RobotGrrl/KitePropulsion/Simulation/CO2JetAnimation/atmosphinder_sprite.png

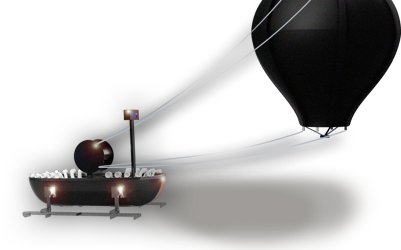
Simulation/CO2JetAnimation/atmosphinder_sprite.png
