RobotGrrl/KitePropulsion/Simulation/CO2JetAnimation/anim_bg.png

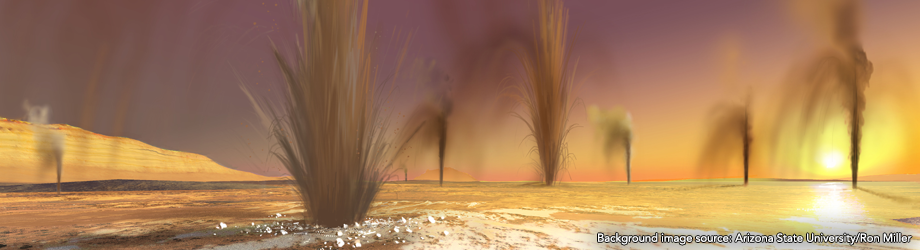
Simulation/CO2JetAnimation/anim_bg.png
