RobotGrrl/KitePropulsion/Electronics/efficiencies.md

| Power and Thermal Efficiencies | | | | | | | | |
| --- | --- | --- | --- | --- | --- | --- | --- | --- |
| | | | | | | | | |
| Ambient temperature | deg C | 25 | | | | | | |
| V\_bat | V | 16.8 | | | | | | (13.6, 14.8, 16.8) |
| | | | | | | | | |
| Parameter | Unit | 01 Input | 03 Motor | 04 Controller (5V) | 04 Controller (3.3V) | 05 Servo Out | 06 SBC  | Notes |
| V\_in | V | 16.8 | 16.8 | 16.8 | 16.8 | 16.8 | 16.8 | |
| V\_drop | V | 0.7 | 0.7 | 0.7 | 0.7 | 0.7 | 0.7 | Diode and other components |
| Load current | A | 1 | 1 | 1 | 1 | 1 | 2.2 | |
| | | | | | | | | |
| Switching name | \- | XL4005 | XL4016 | XL4005 | XL4005 | XL4005 | XL4005  | |
| Switching V\_in | V | 16.1 | 16.1 | 16.1 | 16.1 | 16.1 | 16.1 | |
| Switching I\_in | A | 0.50 | 0.56 | 0.46 | 0.46 | 0.48 | 1.03 | Determined by the efficiency |
| Switching P\_in | W | 8.0 | 9.1 | 7.4 | 7.4 | 7.7 | 16.5 | |
| Switching V\_out | V | 7.2 | 7.72 | 6.7 | 6.7 | 6.9 | 6.76 | |
| Switching I\_out | A | 1 | 1 | 1 | 1 | 1 | 2.2 | |
| Switching P\_out | W | 7.2 | 7.72 | 6.7 | 6.7 | 6.9 | 14.872  | |
| | | | | | | | | |
| Switching Effeciency | % | 90% | 85% | 90% | 90% | 90% | 90% | Given by the webpage... |
| Switching P\_dissipated | W | 0.8 | 1.4 | 0.7 | 0.7 | 0.8 | 1.7 | |
| | | | | | | | | |
| Linear name | \- | 7805 | AZ1084 | AZ1084 | AZ1117 | AZ1084 | AZ1084  | |
| Linear V\_drop | V | 2 | 1.5 | 1.5 | 1.4 | 1.5 | 1.5 | |
| Linear V\_in | V | 7.2 | 7.72 | 6.7 | 6.7 | 6.9 | 6.76 | Add +0.2V to be safe |
| Linear I\_in | A | 1 | 1 | 1 | 1 | 1 | 2.2 | |
| Linear P\_in | W | 7.2 | 7.72 | 6.7 | 6.7 | 6.9 | 14.872  | |
| Linear V\_out | V | 5 | 6.02 | 5 | 3.3 | 5.2 | 5.06 | |
| Linear I\_out | A | 1 | 1 | 1 | 1 | 1 | 2.2 | I\_out = I\_in for linear regulators |
| Linear P\_out | W | 5 | 6.02 | 5 | 3.3 | 5.2 | 11.132  | |
| | | | | | | | | |
| Linear Efficiency | % | 69% | 78% | 75% | 49% | 75% | 75% | |
| Linear P\_dissipated | W | 2.2 | 1.7 | 1.7 | 3.4 | 1.7 | 3.74 | |
| | | | | | | | | |
| Overall Efficiency | % | 63% | 66% | 67% | 44% | 68% | 67% | |
| | | | | | | | | |
| θ\_JC | deg C / W | 5 | 7.36 | 7.36 | 10 | 7.36 | 7.36 | Thermal resistance, junction-to-case, found as R\_thetaJC in the datasheet |
| θ\_CS | deg C / W | 0 | 0 | 0 | 0 | 0 | 0 | Thermal resistance case to surface |
| θ\_SA | deg C / W | 28 | 10 | 10 | 10 | 10 | 10 | Given in heatsink's datasheet, or 1000 deg C / W per 1 cm^2 (via TI app note). Thermal resistance from surface to air. |
| Thermal resistance | deg C / W | 33 | 17.36 | 17.36 | 20 | 17.36 | 17.36 | Total thermal resistance from junction to air |
| | | | | | | | | |
| Temperature rise above ambient | deg C | 72.6 | 29.512 | 29.512 | 68 | 29.512 | 64.9264 | Above ambient temperature |
| Temperature rise incl. ambient | deg C | 97.6 | 54.512 | 54.512 | 93 | 54.512 | 89.9264 | Including ambient |
| Operating junction temperature | deg C | 150 | 125 | 125 | 125 | 125 | 125 | The maximum temperature limit of the regulator, found as T\_j in the datasheet |
| Junction temperature remainder | deg C | 52.4 | 70.488 | 70.488 | 32 | 70.488 | 35.0736 | This many degrees to go until it is exceeded. The maximum internal die temperature (aka maximum operating junction temperature) cannot be exceeded |
