RobotGrrl/KitePropulsion/Data/generator_05-01-22/MokuOscilloscopeData_20220501_024608_Screenshot.png

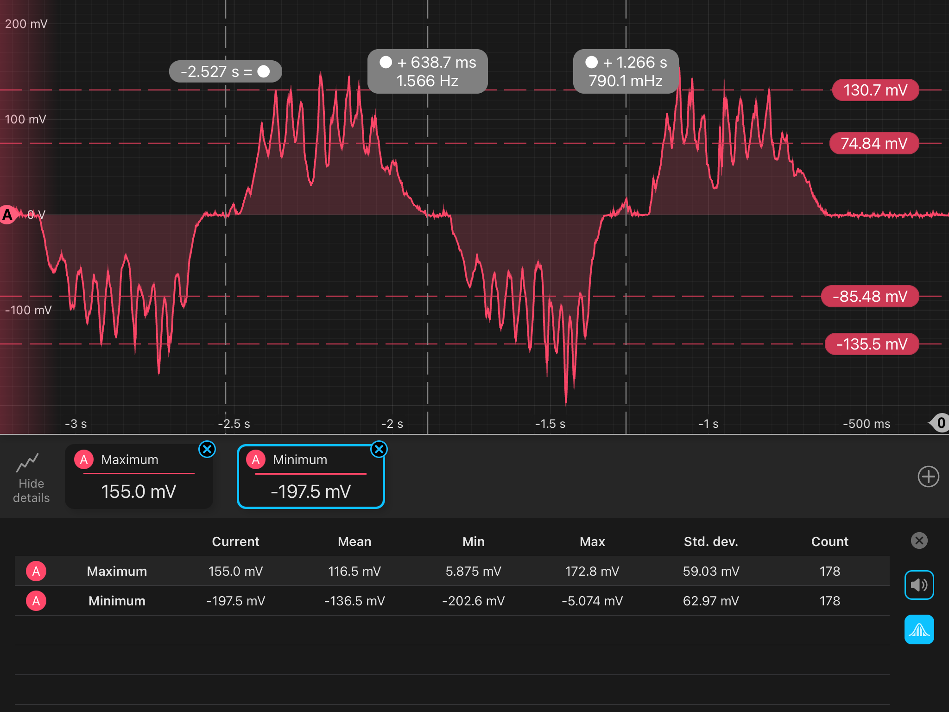
Data/generator_05-01-22/MokuOscilloscopeData_20220501_024608_Screenshot.png
