RobotGrrl/KitePropulsion/Diagrams/Kite Propulsion Block Diagram.png

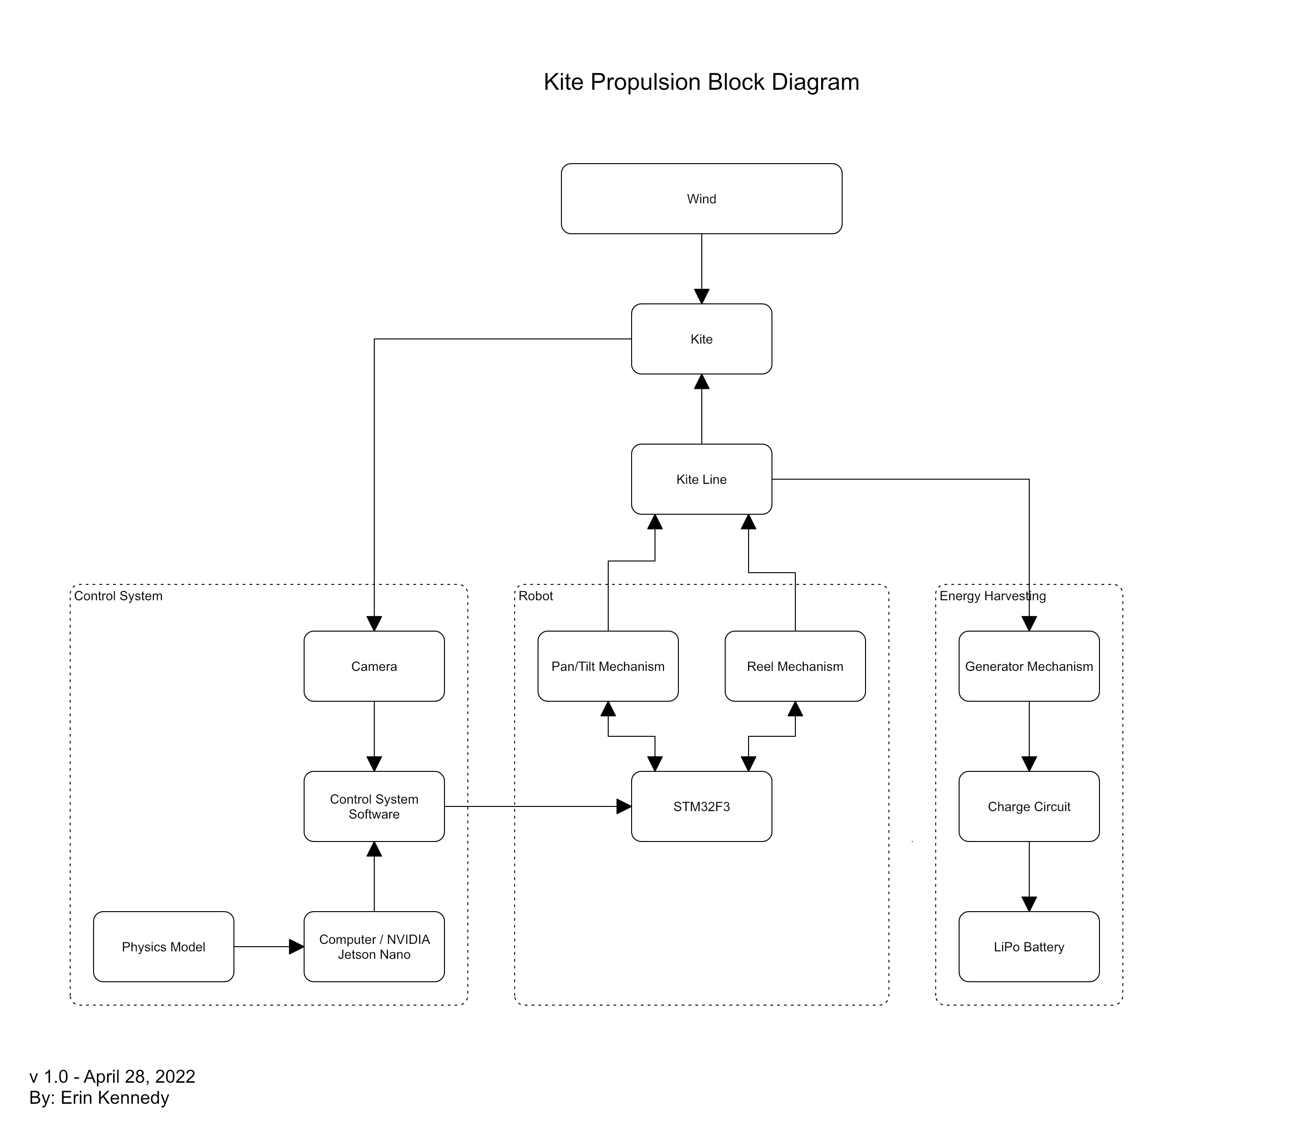
Diagrams/Kite Propulsion Block Diagram.png
