RobotGrrl/KitePropulsion/Electronics/00_CoverStage_v1/00_CoverStage_v1_art.png

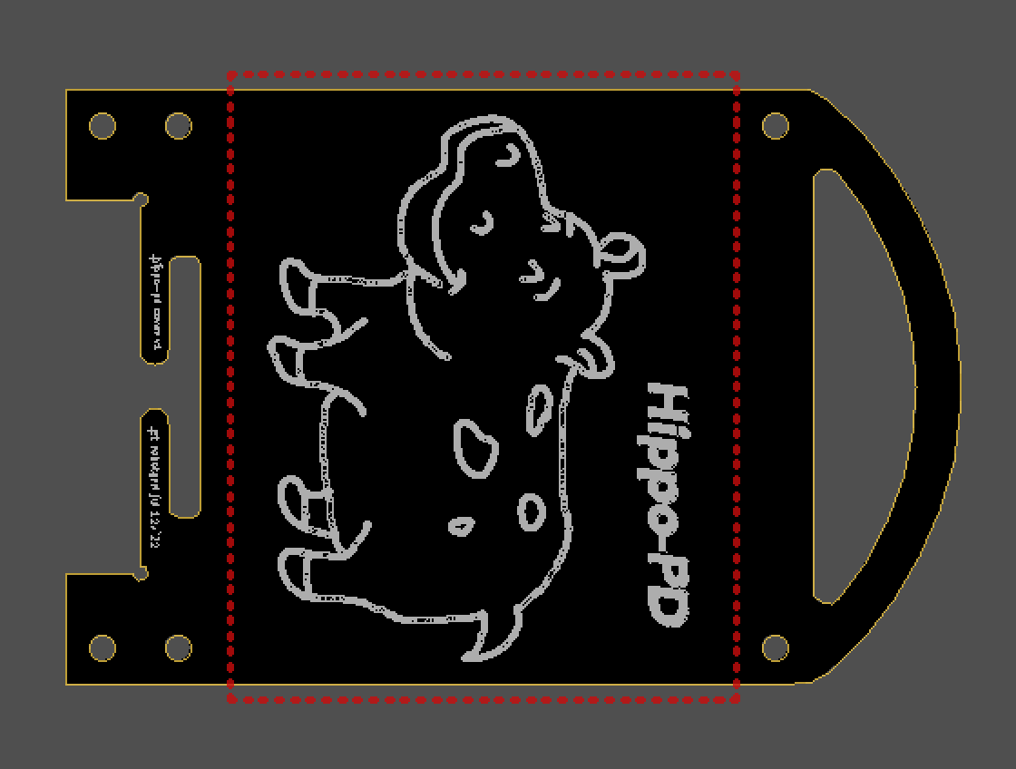
Electronics/00_CoverStage_v1/00_CoverStage_v1_art.png
