RobotGrrl/KitePropulsion/Electronics/00_CoverStage_v1/00_CoverStage_v1_top.png

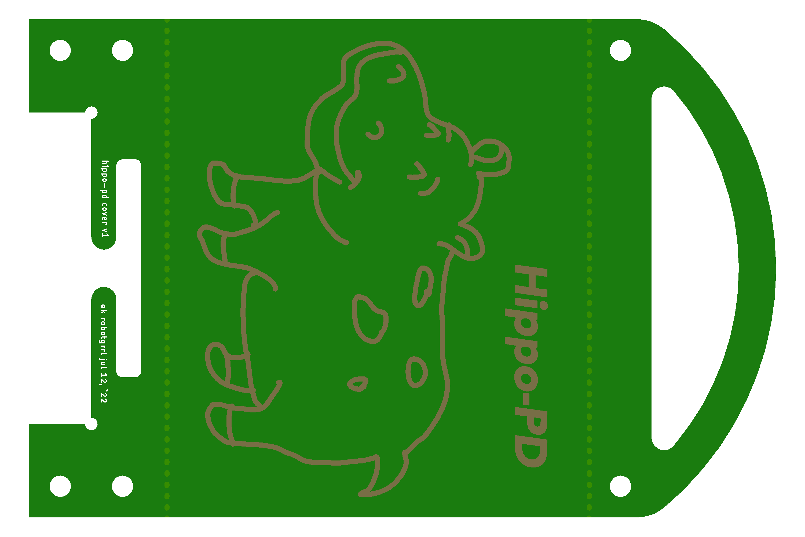
Electronics/00_CoverStage_v1/00_CoverStage_v1_top.png
