RobotGrrl/KitePropulsion/Electronics/01_InputStage_v1/01_InputStage_v1_bottom.png

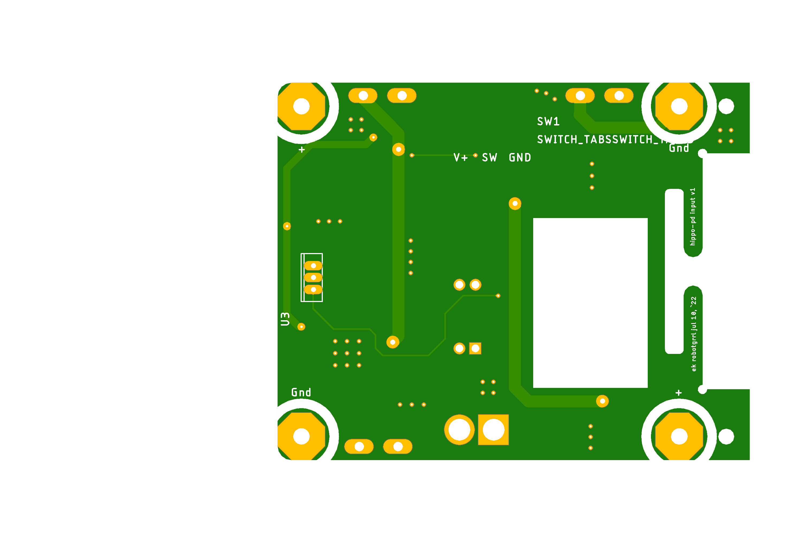
Electronics/01_InputStage_v1/01_InputStage_v1_bottom.png
