RobotGrrl/KitePropulsion/Electronics/02_MonitorStage_v1/02_MonitorStage_v1_art.png

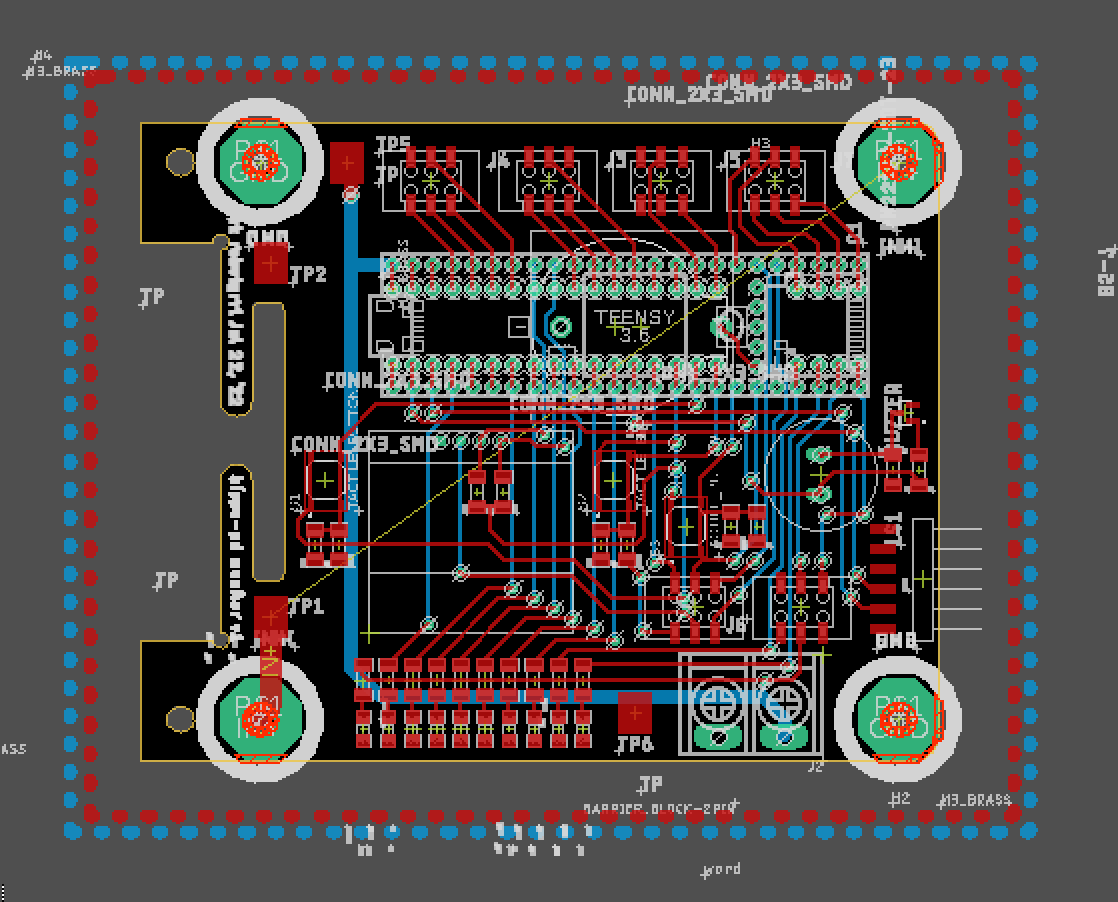
Electronics/02_MonitorStage_v1/02_MonitorStage_v1_art.png
