RobotGrrl/KitePropulsion/Electronics/02_MonitorStage_v1/02_MonitorStage_v1_bottom.png

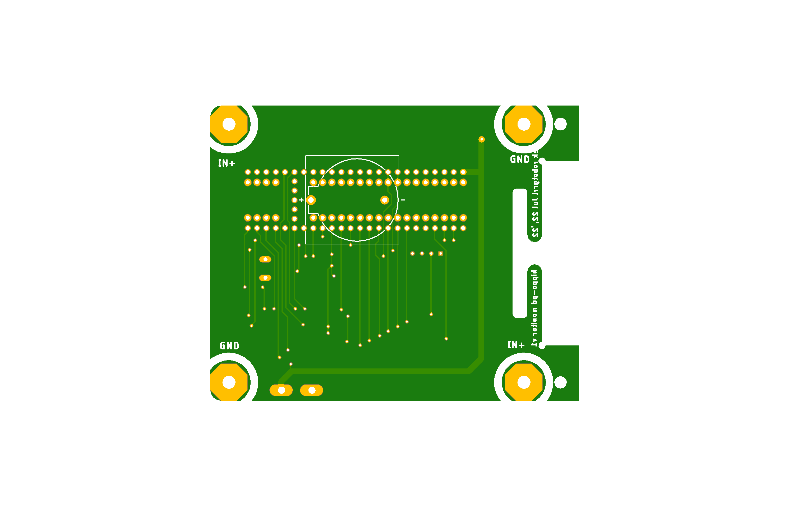
Electronics/02_MonitorStage_v1/02_MonitorStage_v1_bottom.png
