RobotGrrl/KitePropulsion/Electronics/03_MotorStage_v1/03_MotorStage_v1_art2.png

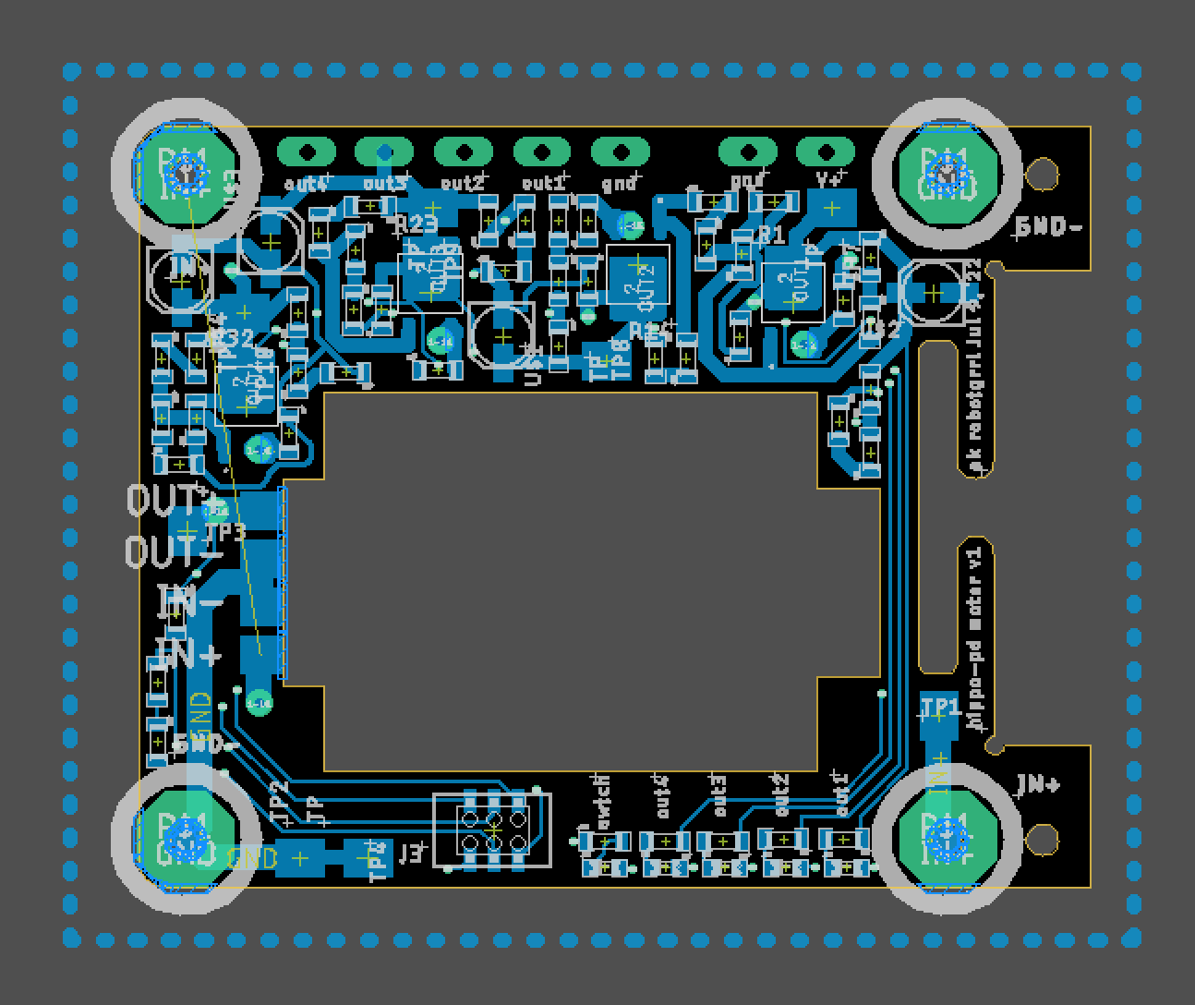
Electronics/03_MotorStage_v1/03_MotorStage_v1_art2.png
