RobotGrrl/KitePropulsion/Electronics/03_MotorStage_v1/03_MotorStage_v1_top.png

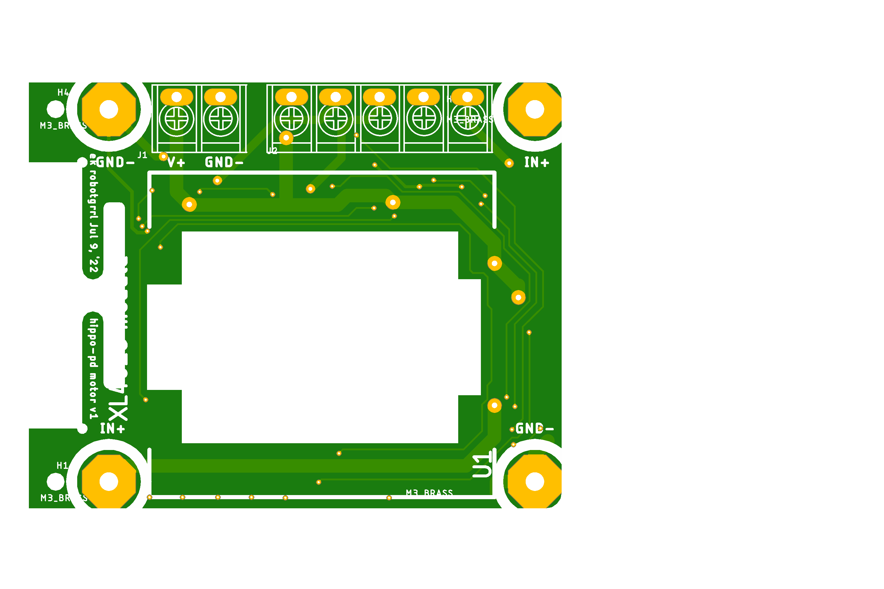
Electronics/03_MotorStage_v1/03_MotorStage_v1_top.png
