RobotGrrl/KitePropulsion/Electronics/04_ControllerStage_v1/04_ControllerStage_v1_bottom.png

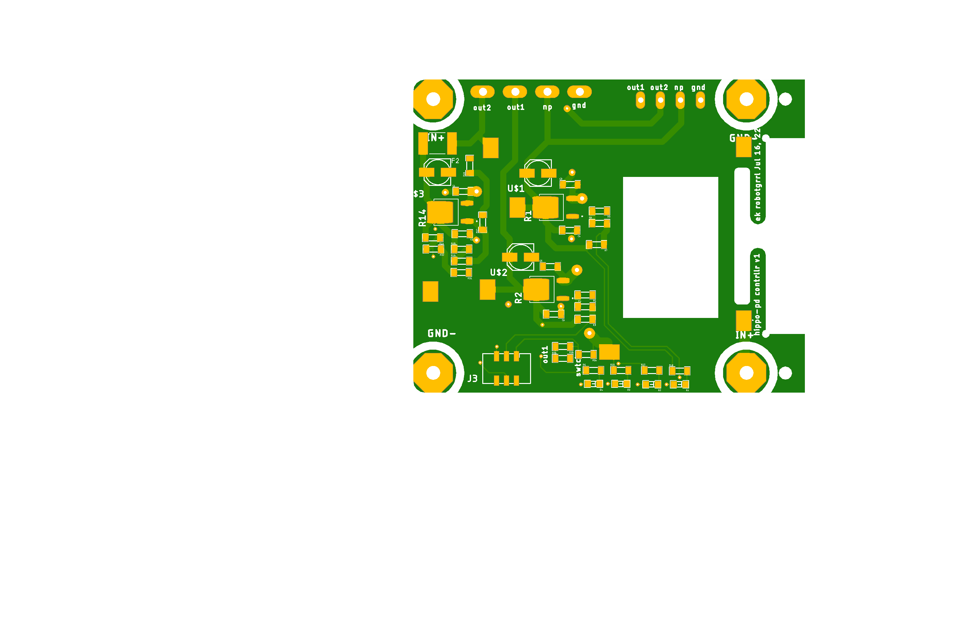
Electronics/04_ControllerStage_v1/04_ControllerStage_v1_bottom.png
