RobotGrrl/KitePropulsion/Electronics/04_ControllerStage_v1/04_ControllerStage_v1_top.png

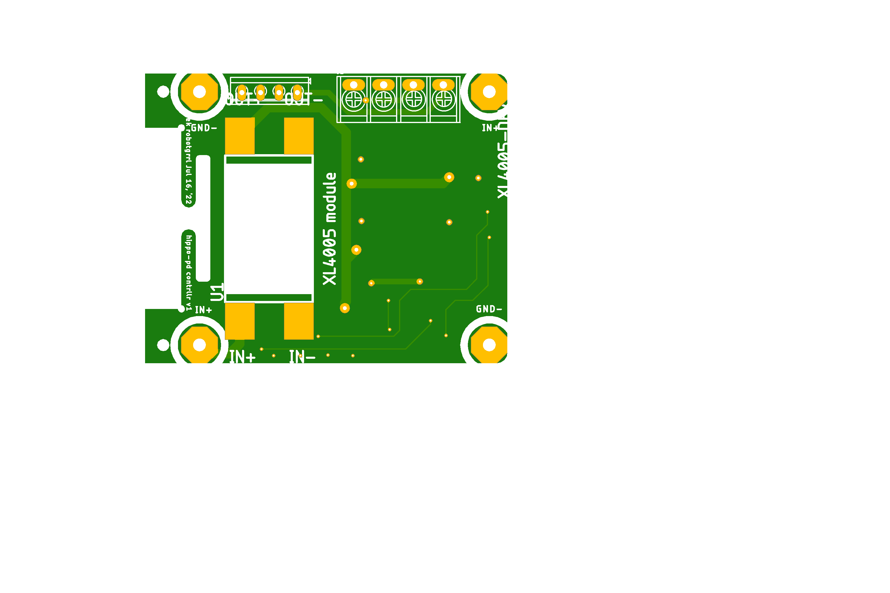
Electronics/04_ControllerStage_v1/04_ControllerStage_v1_top.png
