RobotGrrl/KitePropulsion/Electronics/05_ServoStage_v1/05_ServoStage_v1_art.png

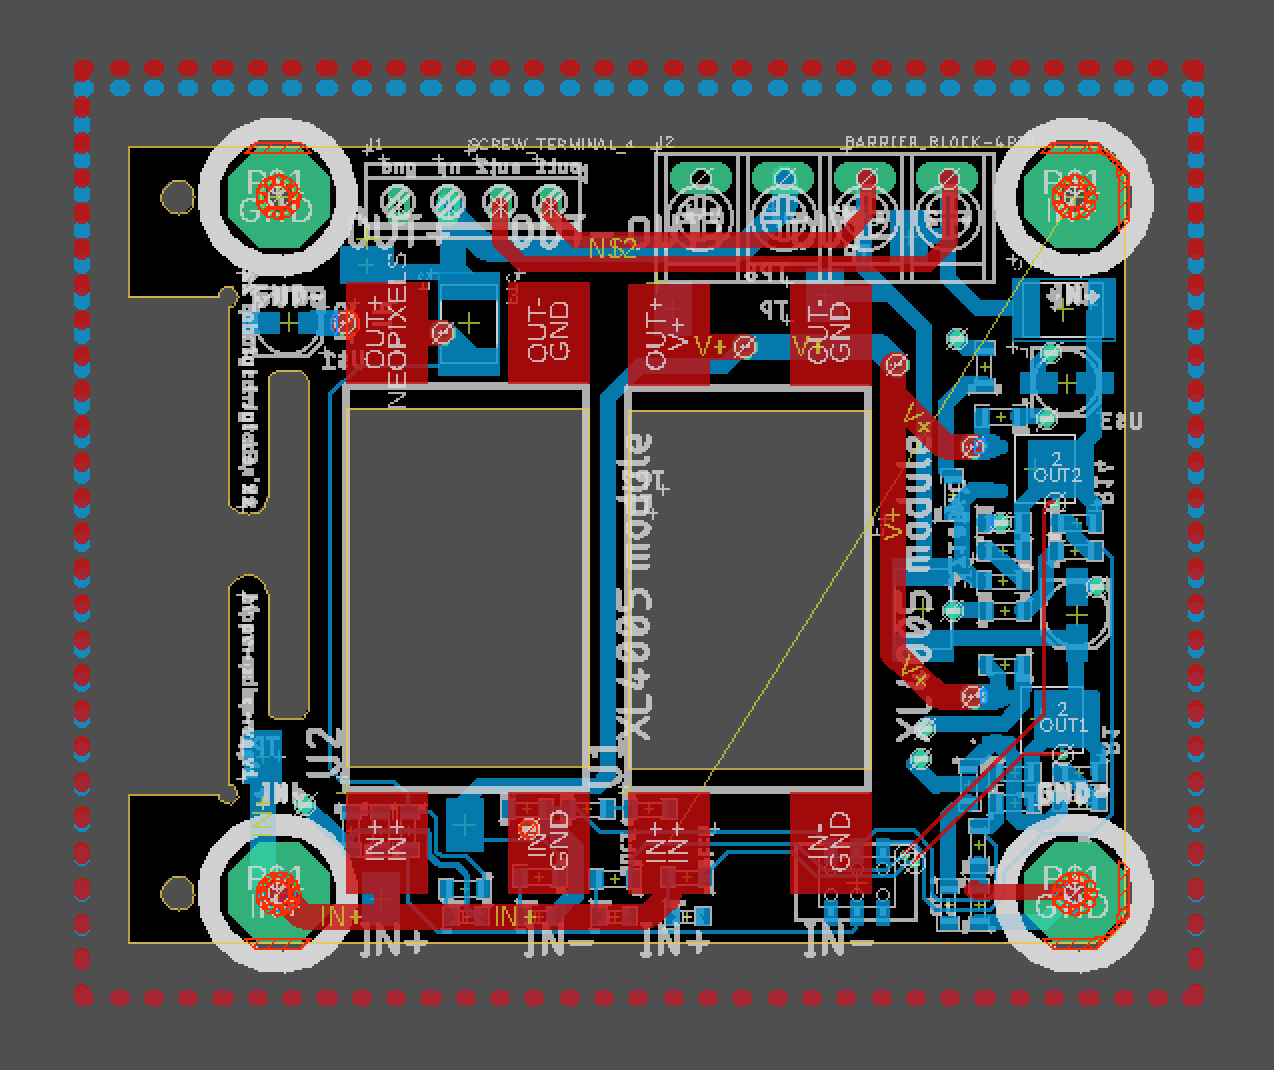
Electronics/05_ServoStage_v1/05_ServoStage_v1_art.png
