RobotGrrl/KitePropulsion/Electronics/06_SBCStage_v1/06_SBCStage_v1_art.png

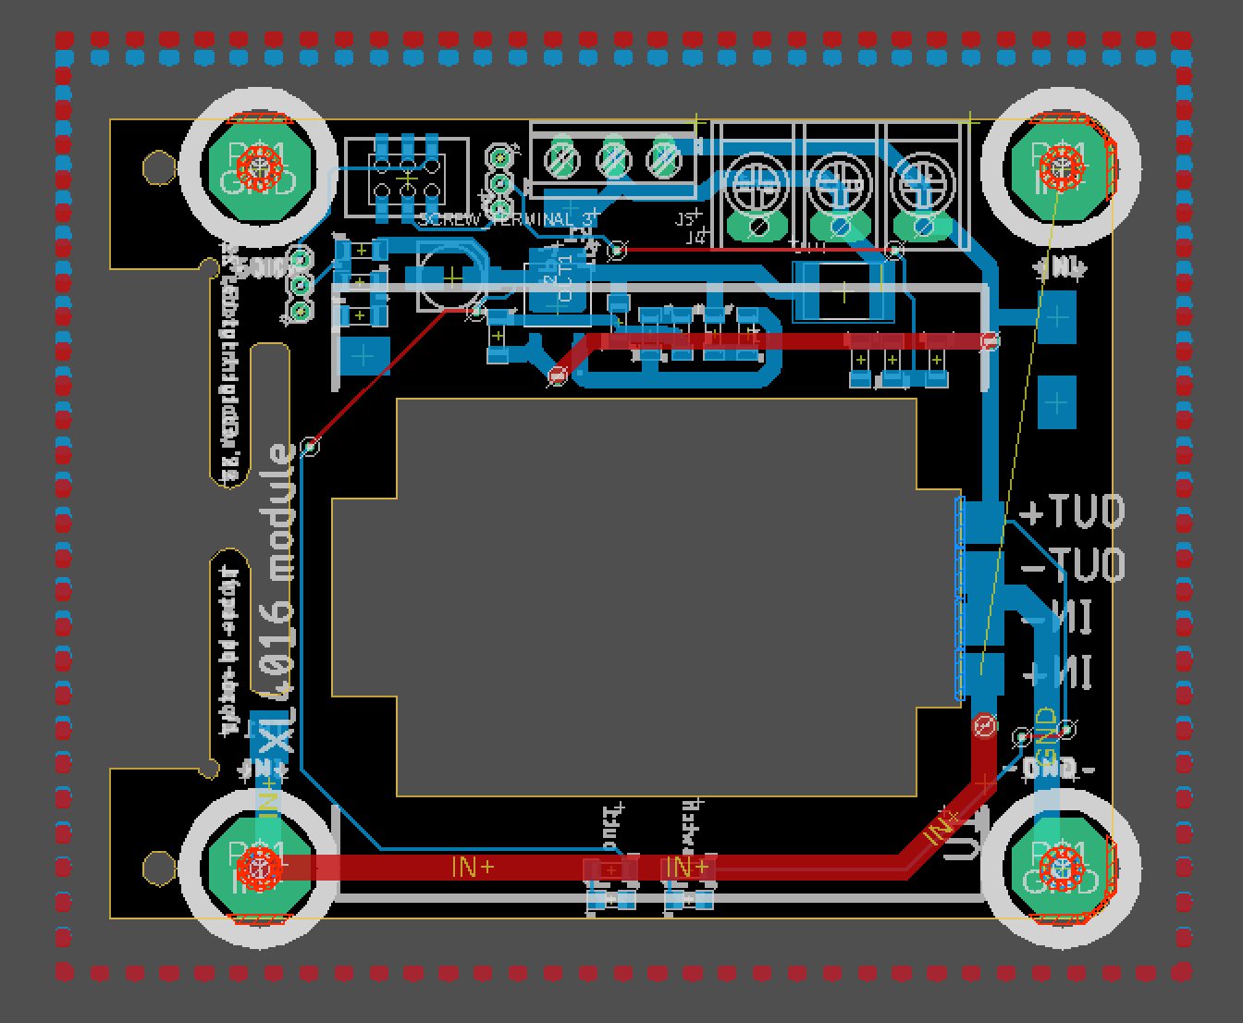
Electronics/06_SBCStage_v1/06_SBCStage_v1_art.png
