RobotGrrl/KitePropulsion/Electronics/06_SBCStage_v1/06_SBCStage_v1_top.png

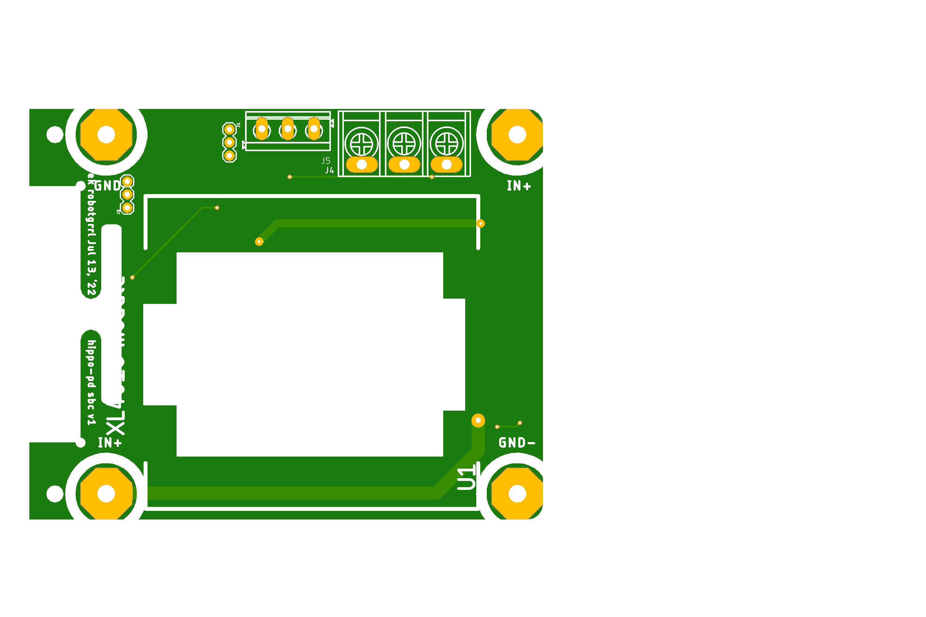
Electronics/06_SBCStage_v1/06_SBCStage_v1_top.png
