RobotGrrl/KitePropulsion/Electronics/99_Sleds_v1/Sled_8A_v1_art.png

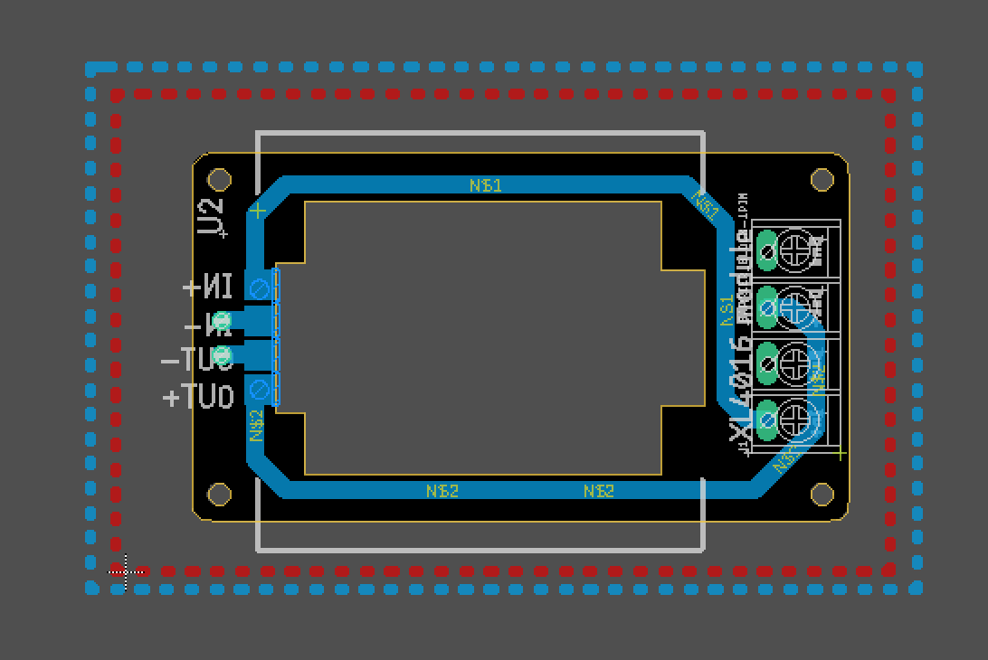
Electronics/99_Sleds_v1/Sled_8A_v1_art.png
