RobotGrrl/KitePropulsion/Design/hippo-pd/upper_bottom_test_jig.stl

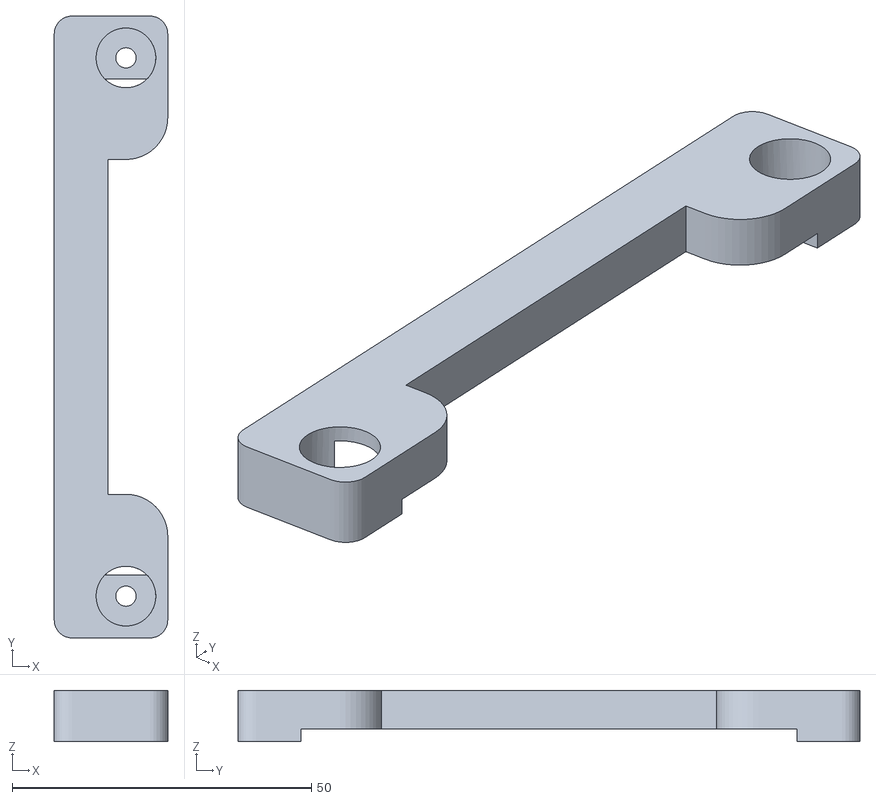
[picture p29: CAD file, 2022-07-31]
Design/hippo-pd/upper_bottom_test_jig.stl
19.0 x 104.0 x 8.57
