RobotGrrl/KitePropulsion/Design/Line Spool.stl

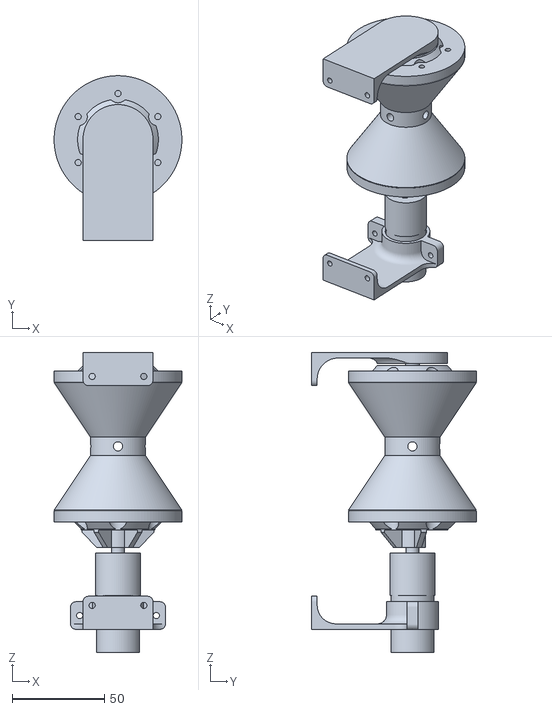
[picture p30: CAD file, 2022-09-07]
Design/Line Spool.stl
69.4 x 89.4 x 163.0
