RobotGrrl/KitePropulsion/Electronics/00_CoverStage_v1/00_CoverStage_v1.step

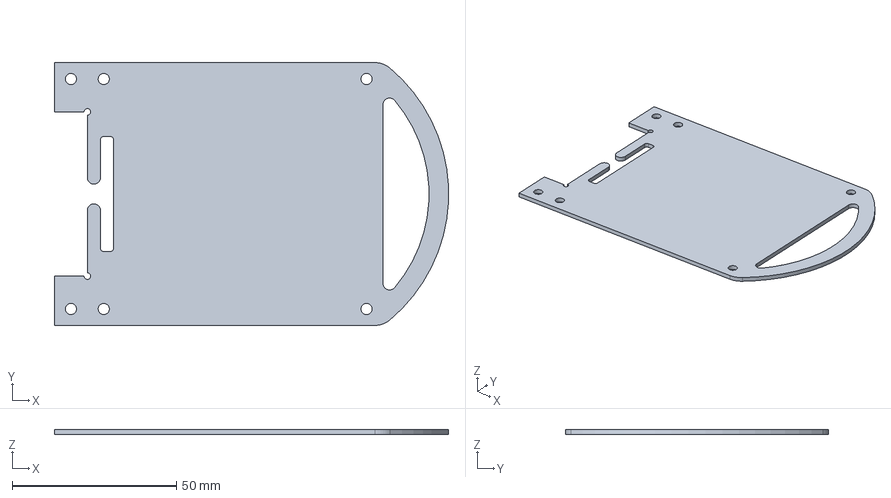
[picture p31: CAD file, 2022-07-22]
Electronics/00_CoverStage_v1/00_CoverStage_v1.step
119.9 x 80.0 x 1.57 mm
