RobotGrrl/KitePropulsion/Electronics/01_InputStage_v1/01_InputStage_v1.step

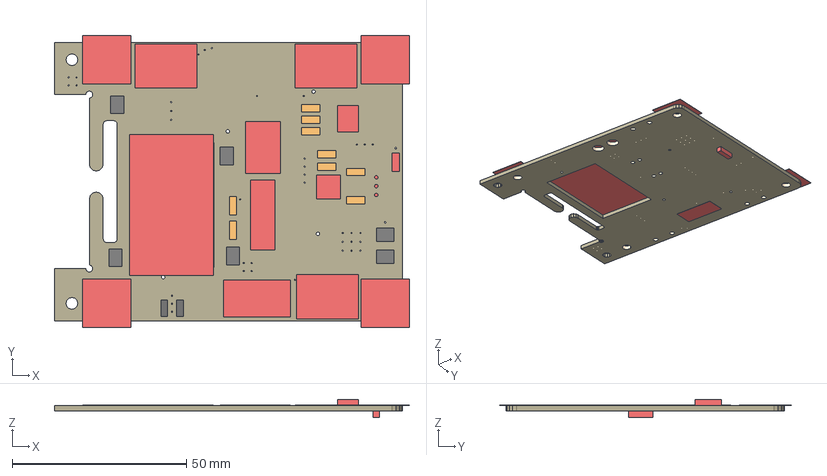
[picture p32: CAD file, 2022-07-22]
Electronics/01_InputStage_v1/01_InputStage_v1.step
102.0 x 84.0 x 5.18 mm
Board
BARRIER_BLOCK-2PIN x 3
XL4005-DEV
M3_BRASS x 4
XT60
TP x 6
TO220-IGO
DIODE_BIG
SWITCH_TABSSWITCH_TABS3
470 uF
15K x 9
ORANGE x 2
CONN_2X3_SMD
PTCPTC_1206
FUSE_HOLDER_TH
