RobotGrrl/KitePropulsion/Electronics/02_MonitorStage_v1/02_MonitorStage_v1.step

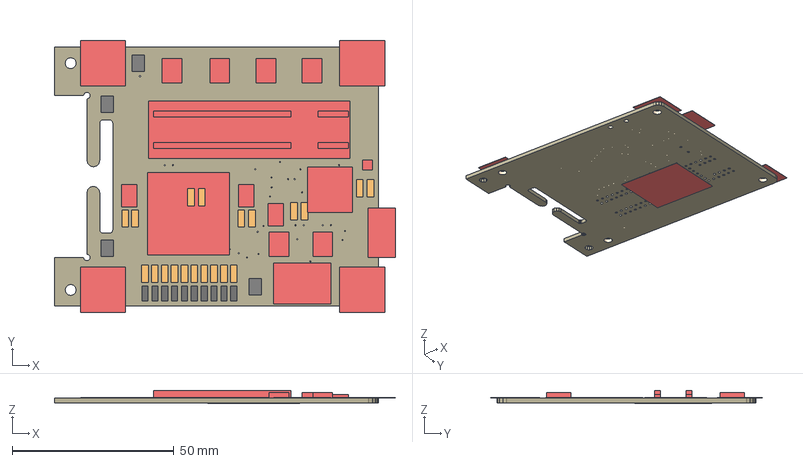
[picture p33: CAD file, 2022-07-22]
Electronics/02_MonitorStage_v1/02_MonitorStage_v1.step
105.3 x 84.0 x 3.93 mm
Board
BARRIER_BLOCK-2PIN
1X17 x 2
1X04 x 2
M3_BRASS x 4
BUZZER
CONN_2X3_SMD x 6
TP x 4
PN2222A-SOT-23
BS-7
1X06-SMD_RA_MALE_NO_HOLES
4.7K x 20
BLUE x 10
TEENSY_3.5/3.6
TINYSCREEN
TACTILE_BUTTON x 3
