RobotGrrl/KitePropulsion/Electronics/03_MotorStage_v1/03_MotorStage_v1.step

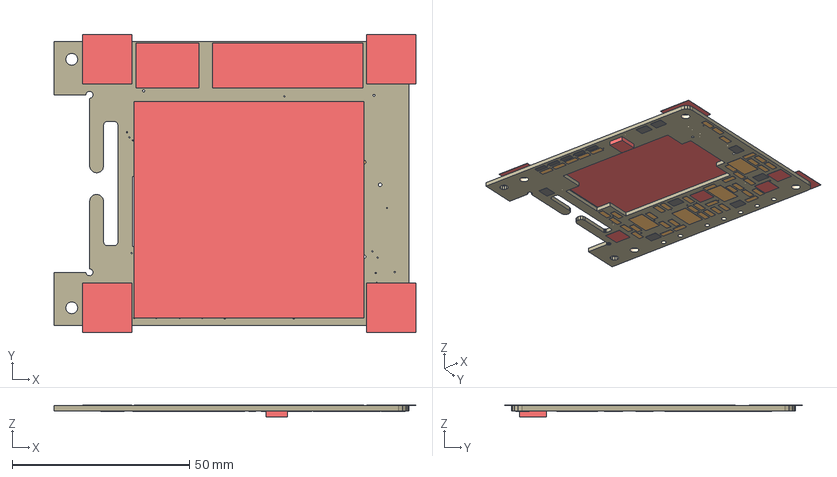
[picture p34: CAD file, 2022-07-22]
Electronics/03_MotorStage_v1/03_MotorStage_v1.step
102.0 x 84.0 x 3.37 mm
Board
M3_BRASS x 4
CONN_2X3_SMD
TP x 8
100 uF x 4
YELLOW x 5
XL4016-DEV
BARRIER_BLOCK-5PIN
BARRIER_BLOCK-2PIN
AZ1084C x 4
