RobotGrrl/KitePropulsion/Electronics/04_ControllerStage_v1/04_ControllerStage_v1.step

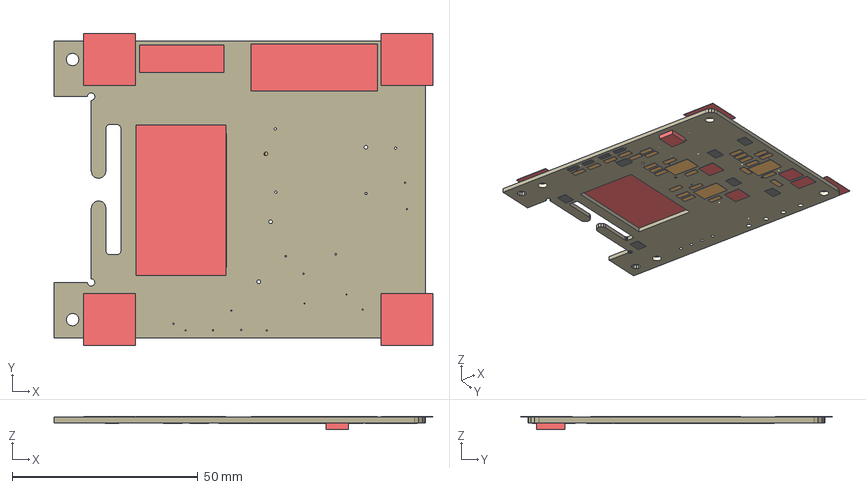
[picture p35: CAD file, 2022-07-22]
Electronics/04_ControllerStage_v1/04_ControllerStage_v1.step
102.0 x 84.0 x 3.37 mm
Board
M3_BRASS x 4
CONN_2X3_SMD
TP x 7
XL4005-DEV
100 uF x 3
AZ1084C
YELLOW x 4
PTC
SCREW_TERMINAL_4
BARRIER_BLOCK-4PIN
AZ1117CDAZ1117CD x 2
