RobotGrrl/KitePropulsion/Electronics/06_SBCStage_v1/06_SBCStage_v1.step

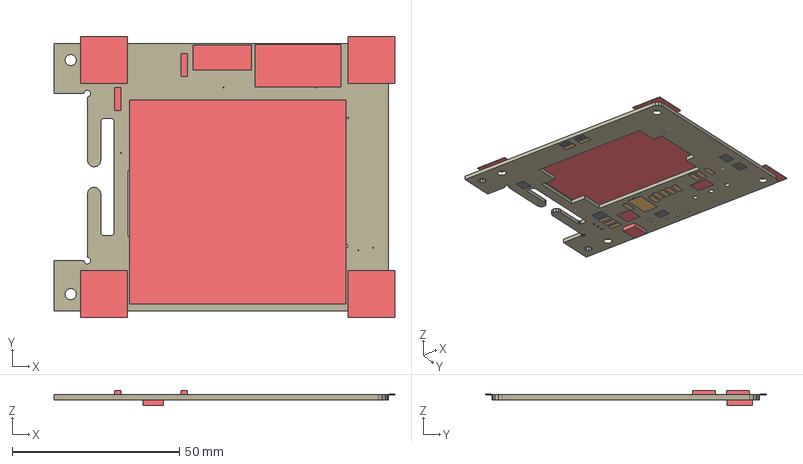
[picture p36: CAD file, 2022-07-22]
Electronics/06_SBCStage_v1/06_SBCStage_v1.step
102.0 x 84.0 x 4.53 mm
Board
M3_BRASS x 4
CONN_2X3_SMD
TP x 5
100 uF
YELLOW x 2
XL4016-DEV
AZ1084C
BARRIER_BLOCK-3PIN
1X03 x 2
PTC
SCREW_TERMINAL_3
