RobotGrrl/KitePropulsion/Electronics/99_Sleds_v1/Sled_5A_v1.step

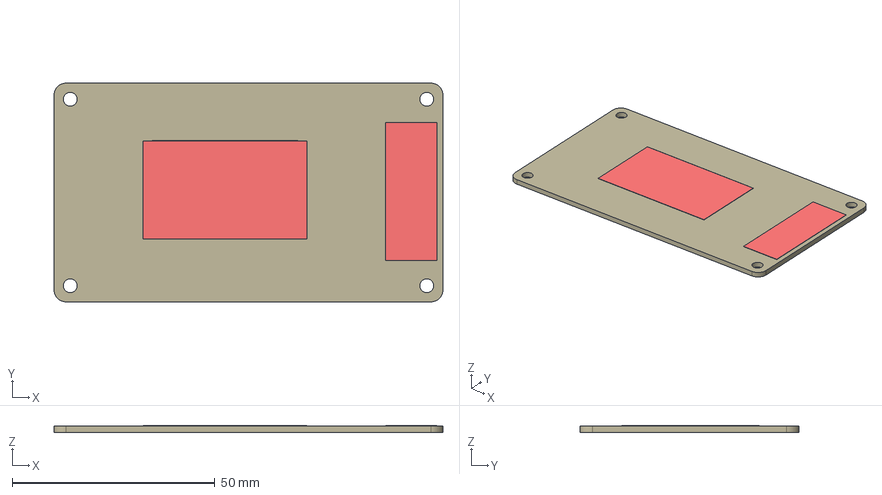
[picture p37: CAD file, 2022-07-22]
Electronics/99_Sleds_v1/Sled_5A_v1.step
96.0 x 54.0 x 1.67 mm
Board
BARRIER_BLOCK-4PIN
XL4005-DEV
