RobotGrrl/KitePropulsion/Electronics/stage_outline.dxf

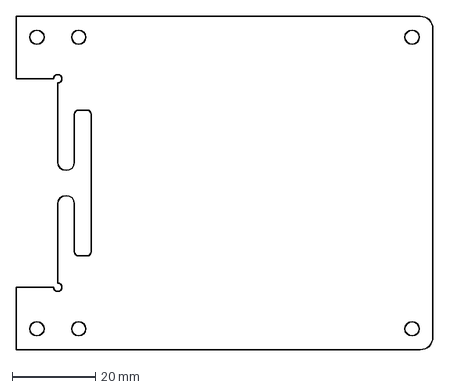
[picture p38: CAD file, 2022-07-22]
Electronics/stage_outline.dxf
100.0 x 80.0 mm
