RobotGrrl/KitePropulsion/Design/hippo-pd/lower_test_jig.stl

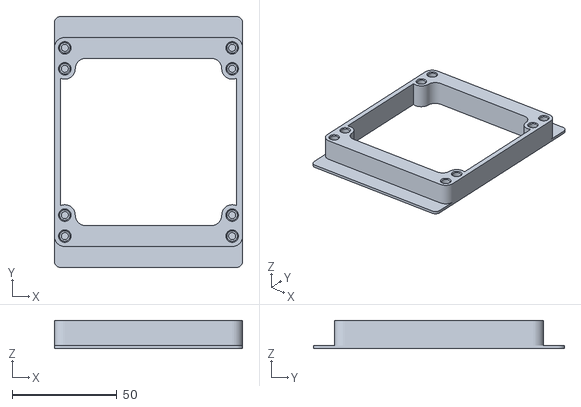
[picture p39: CAD file, 2022-07-31]
Design/hippo-pd/lower_test_jig.stl
90.0 x 120.0 x 13.6
