RobotGrrl/KitePropulsion/Design/Motor hub 3DP.stl

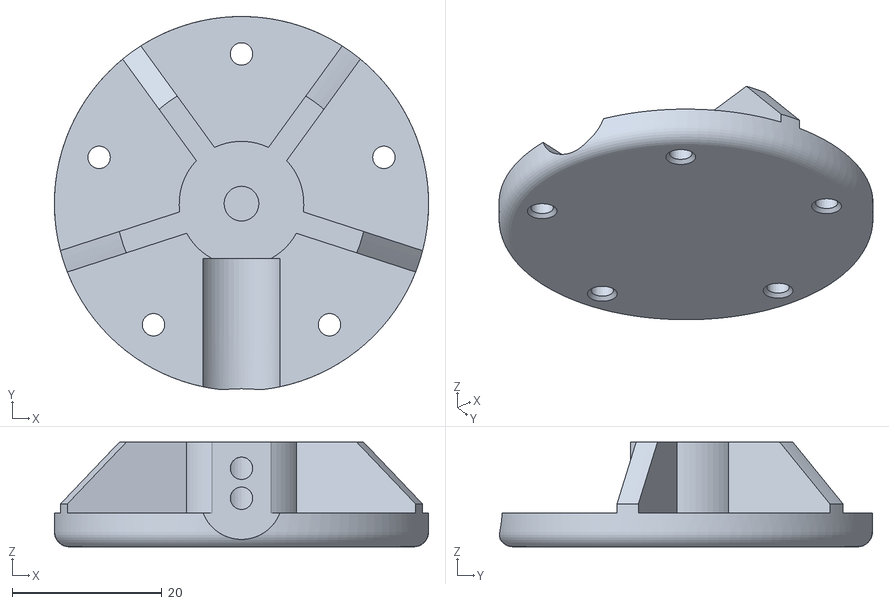
[picture p40: CAD file, 2022-07-12]
Design/Motor hub 3DP.stl
50.0 x 49.8 x 14.0
