RobotGrrl/KitePropulsion/Electronics/cover_outline.dxf

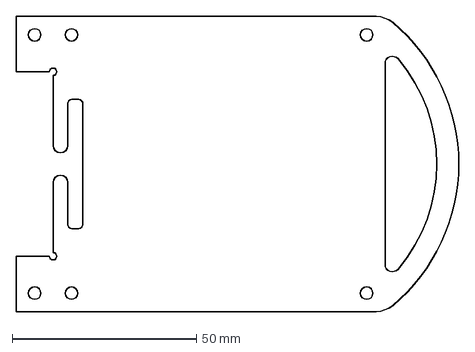
[picture p42: CAD file, 2022-07-22]
Electronics/cover_outline.dxf
120.0 x 80.0 mm
