RobotGrrl/KitePropulsion/Design/hippo-pd/Hippo-PD Test Jig.step

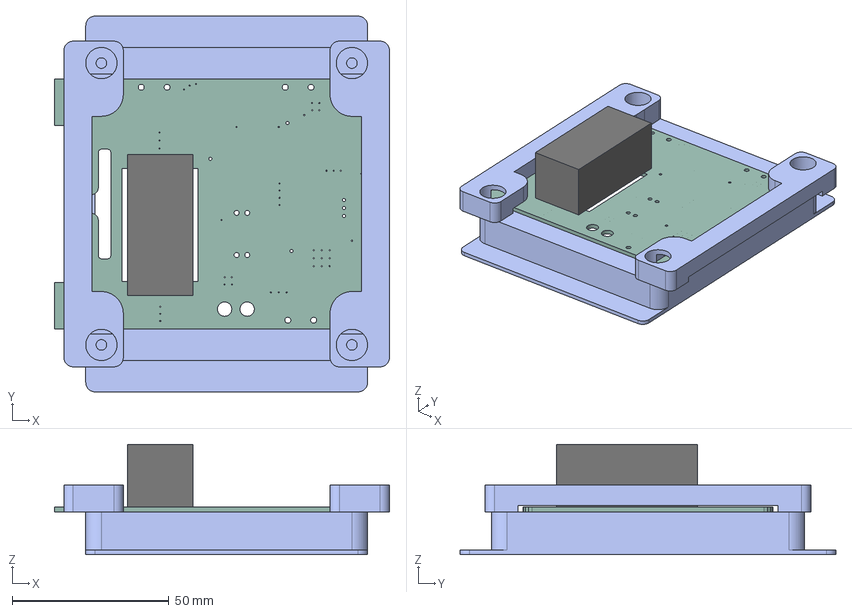
[picture p43: CAD file, 2022-07-31]
Design/hippo-pd/Hippo-PD Test Jig.step
107.0 x 120.0 x 35.2 mm
Board
5A regulator_1
lower
upper
