RobotGrrl/KitePropulsion/Design/Tilt Mechanism.step

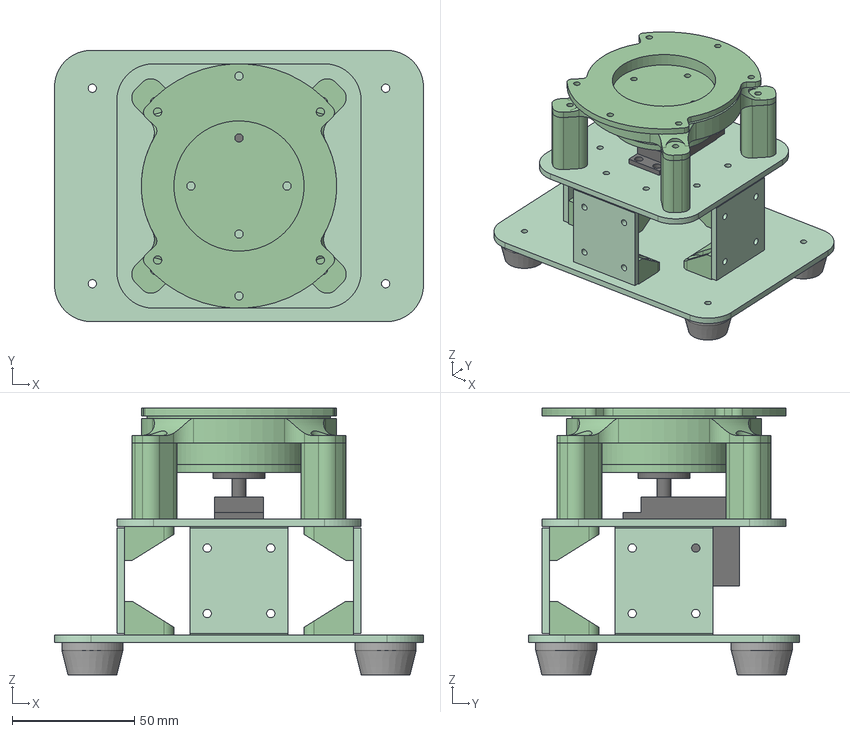
[picture p44: CAD file, 2022-06-22]
Design/Tilt Mechanism.step
151.0 x 111.0 x 109.2 mm
servo L
servo plate
axel
pan plate
bearing plate
side plate
side angle bracket
side angle bracket(Mirror)
side plate(Mirror)
side angle bracket(Mirror) (1)
side angle bracket(Mirror)(Mirror)
side angle bracket(Mirror) (2)
side angle bracket (1)
side plate (1)
ball
bearing spacers
feet (1)
