RobotGrrl/KitePropulsion/Electronics/99_Sleds_v1/Sled_Terminals_v1.step

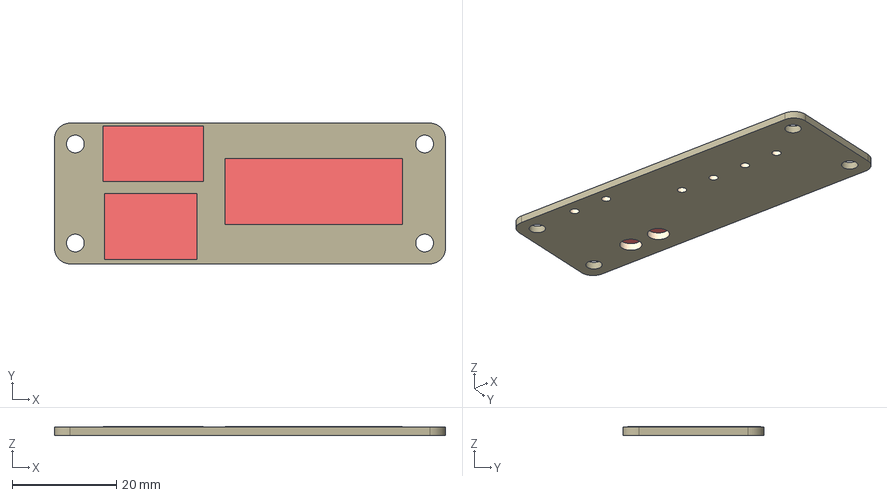
[picture p45: CAD file, 2022-07-22]
Electronics/99_Sleds_v1/Sled_Terminals_v1.step
75.0 x 27.0 x 1.67 mm
Board
BARRIER_BLOCK-4PIN
XT60
BARRIER_BLOCK-2PIN
