RobotGrrl/KitePropulsion/Design/Pan Mechanism.step

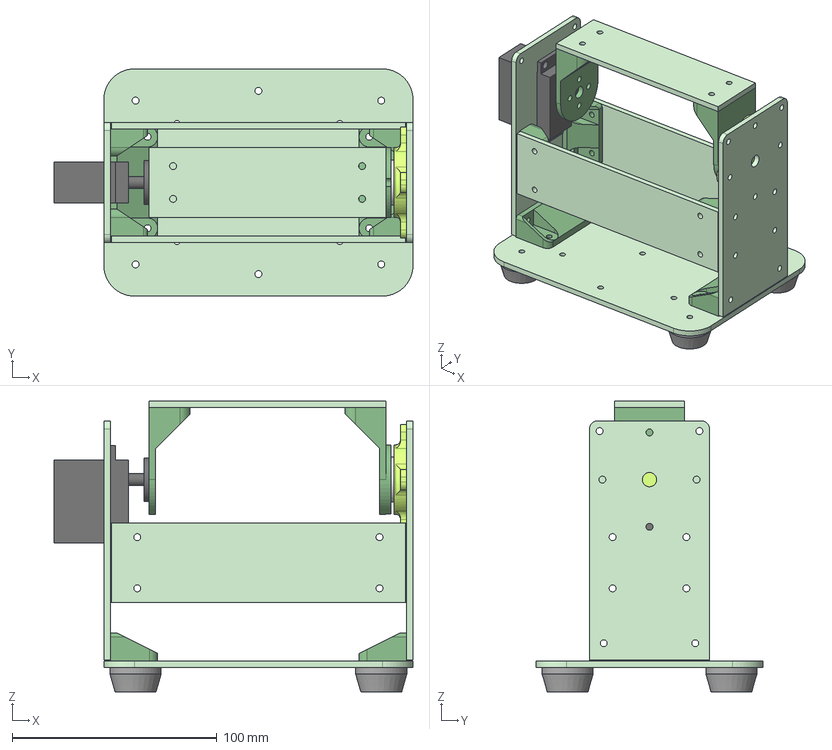
[picture p46: CAD file, 2022-06-21]
Design/Pan Mechanism.step
175.3 x 111.0 x 142.1 mm
servo L
servo plate
servo horn
bearing plate
Inner
ABEC9 v3
94459A130
bearing horn
mounting plate
angle bracket
end stop plate
angle bracket(Mirror)
angle plate
feet
angle plate(Mirror)
angle bracket(Mirror) (1)
angle bracket(Mirror)(Mirror)
end stop plate(Mirror)
fasteners todo
