RobotGrrl/KitePropulsion/Design/Generator.step

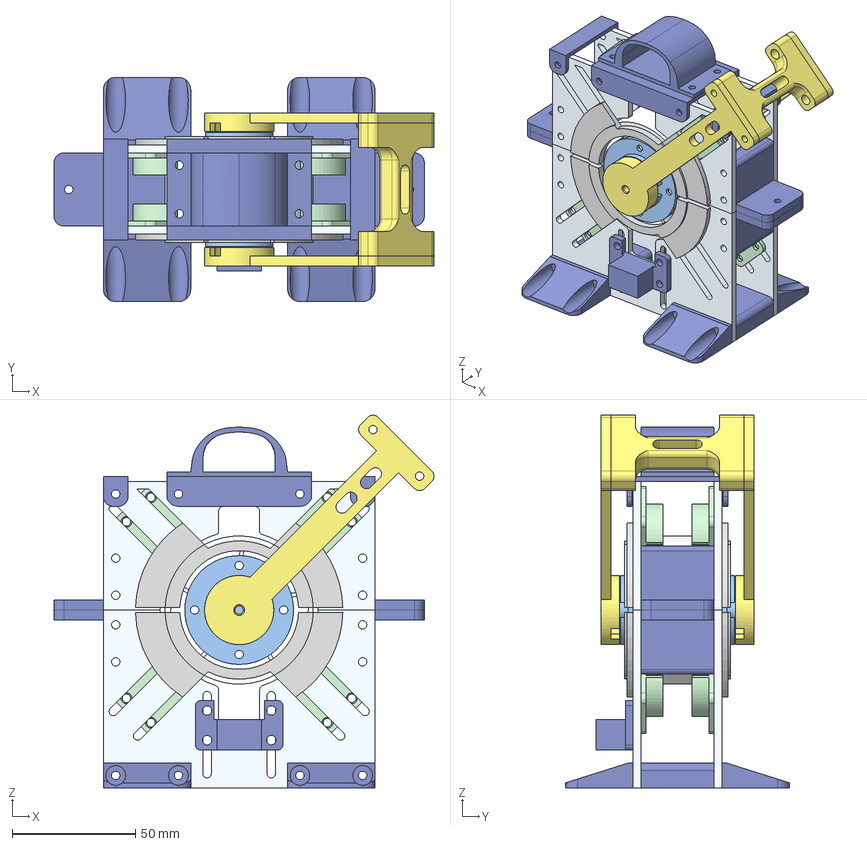
[picture p47: CAD file, 2022-05-01]
Design/Generator.step
153.9 x 90.8 x 150.9 mm
lower plate
support bearing
wheel
wheel bearing
kite bearing
support bearing(Mirror)
upper plate
support bearing(Mirror) (2)
support bearing(Mirror)(Mirror) (1)
lower link
half latch
foot
upper link
handle
kite link
upper side link
foot(Mirror)
lower plate(Mirror)
support bearing(Mirror) (1)
wheel(Mirror)
wheel bearing(Mirror)
kite bearing(Mirror)
support bearing(Mirror)(Mirror)
upper plate(Mirror)
support bearing(Mirror) (2)(Mirror)
support bearing(Mirror)(Mirror) (1)(Mirror)
half latch(Mirror)
lower link(Mirror)
half latch(Mirror) (1)
foot(Mirror) (1)
half latch(Mirror)(Mirror)
foot(Mirror)(Mirror)
upper side link(Mirror)
guard
motor mount
