RobotGrrl/KitePropulsion/Design/hippo-pd/clip_A.stl

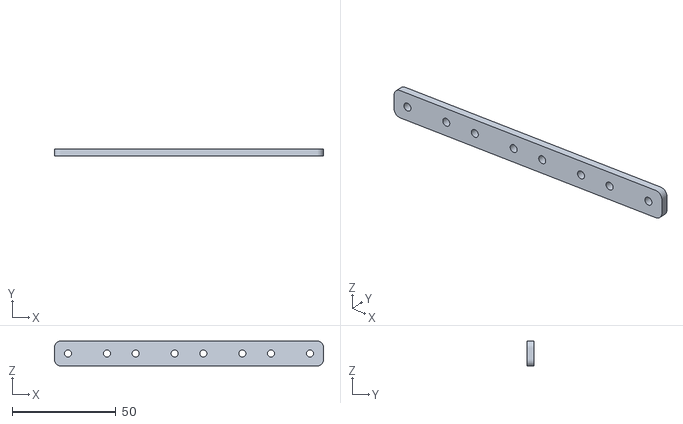
[picture p48: CAD file, 2022-07-25]
Design/hippo-pd/clip_A.stl
129.5 x 3.18 x 12.0
