RobotGrrl/KitePropulsion/Design/hippo-pd/tray.stl

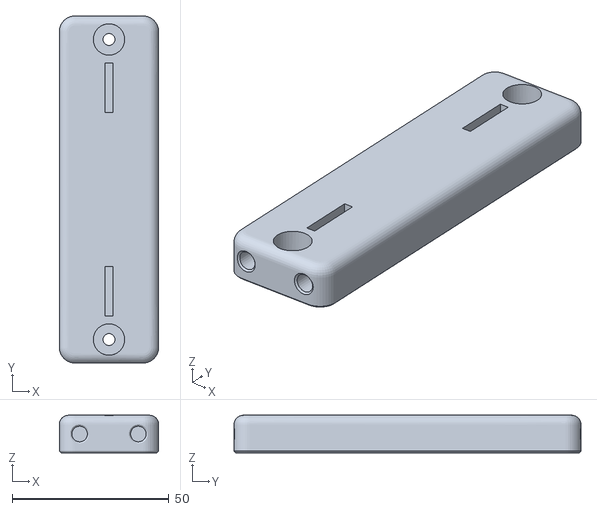
[picture p49: CAD file, 2022-07-25]
Design/hippo-pd/tray.stl
31.8 x 110.8 x 12.0
