RobotGrrl/KitePropulsion/Design/hippo-pd/clip_B.stl

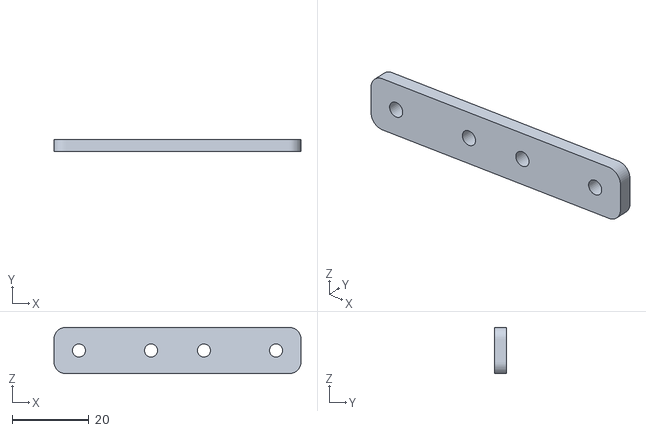
[picture p50: CAD file, 2022-07-25]
Design/hippo-pd/clip_B.stl
64.3 x 3.18 x 12.0
