RobotGrrl/KitePropulsion/(list of files, cad)

Other CAD files:
Electronics/05_ServoStage_v1/05_ServoStage_v1.step
Design/hippo-pd/upper_top_test_jig.stl
Design/Generator.f3d
Design/Generator.stl
Design/Line Spool.f3z
Design/Motor hub 3DP.f3z
Design/Pan Mechanism.f3z
Design/Pan Mechanism.stl
Design/Roll Experiment.f3z
Design/Tilt Mechanism.f3z
Design/Tilt Mechanism.stl
Design/hippo-pd/Hippo-PD Test Jig.f3z
