RobotGrrl/KitePropulsion/Electronics/05_ServoStage_v1/05_ServoStage_v1_CAMOutputs/Assembly/PnP_05_ServoStage_v1_front.txt

U1	79.59	53.87	0.00	XL4005-DEV	XL4005-DEV
U2	51.39	54.00	0.00	XL4005-DEV	XL4005-DEV
