RobotGrrl/KitePropulsion/Data/generator_05-01-22/MokuOscilloscopeData_20220501_024608_Measurements.csv

% Moku:Oscilloscope
% Channel A (Input 1) - DC coupling | 1 MOhm impedance | 1 x probe attenuation
% Channel B (Input 2) - DC coupling | 1 MOhm impedance | 1 x probe attenuation
% Time span 3.000 s | time offset 1.740 s | Normal acquisition mode | 1 averages
% Edge trigger: Channel A | level 2.000 V | Auto mode | Rising edge | Auto sensitivity | noise reject off | HF reject off
% Output 1 - Pulse | 50.000 000 Hz | 3.303 5 Vpp | offset 0.000 0 V | phase 0.000 deg | width 1.000 ms | edge 4.000 ns | output load 1 MOhm
% Output 2 - Ramp | 50.000 000 000 kHz | 500.9 mVpp | offset 0.000 0 V | phase 0.000 deg | symmetry 90.00 % | output load 50 Ohm
% Internal 10 MHz clock
% Acquired 2022-05-01 T 02:47:07 -0400
% Kite Propulsion Generator Prototype Iteration 1.0
% Statistics | Ch A Maximum (V) | Ch A Minimum (V)
% Mean | 1.165437e-01 | -1.365011e-01
% Min | 5.875082e-03 | -2.025568e-01
% Max | 1.727808e-01 | -5.073935e-03
% Std. dev. | 5.902575e-02 | 6.296557e-02
% Count | 178 | 178
% Time (s) | Ch A Maximum (V) | Ch A Minimum (V)
-1.292674e+02 | 4.939865e-03 | -4.939865e-03
-1.291653e+02 | 4.939865e-03 | -5.473905e-03
-1.290658e+02 | 4.939865e-03 | -4.806356e-03
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
