RobotGrrl/KitePropulsion/Electronics/01_intput_testpoints.PNG

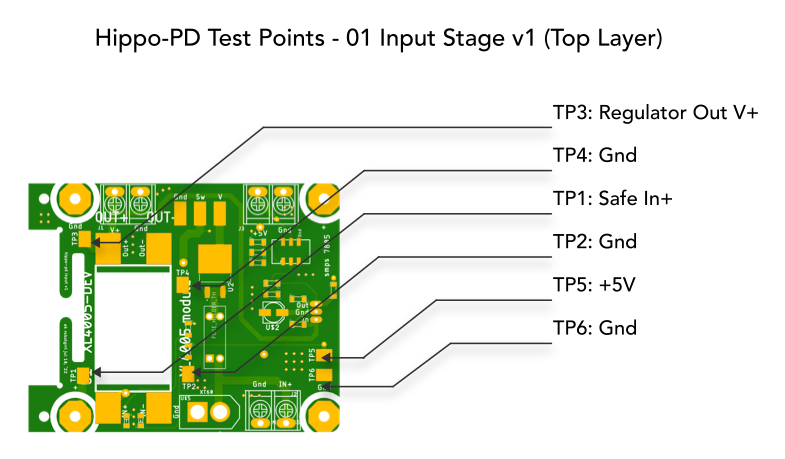
Electronics/01_intput_testpoints.PNG
