RobotGrrl/KitePropulsion/Electronics/02_monitor_testpoints.PNG

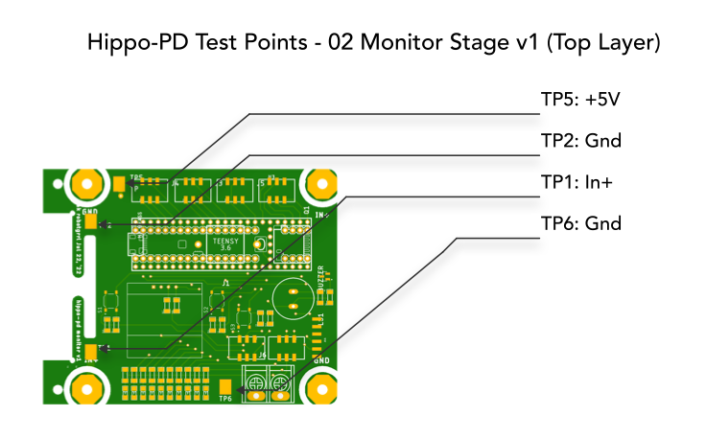
Electronics/02_monitor_testpoints.PNG
