RobotGrrl/KitePropulsion/Electronics/03_motor_testpoints.PNG

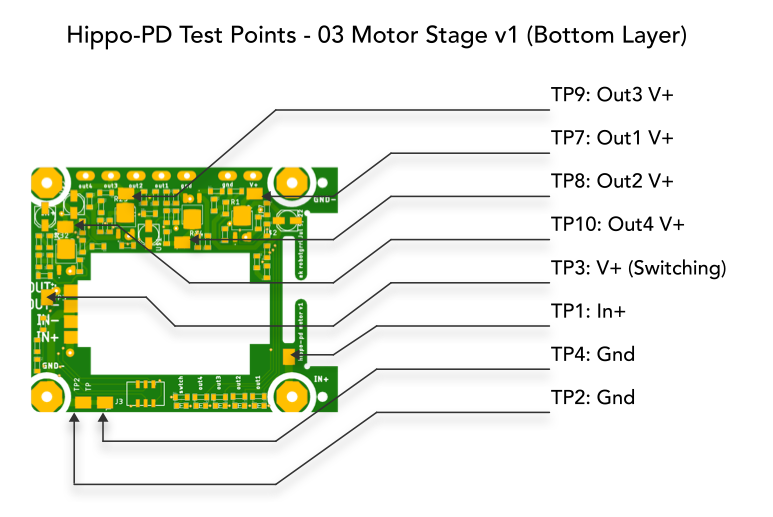
Electronics/03_motor_testpoints.PNG
