RobotGrrl/KitePropulsion/Electronics/06_SBCStage_v1/06_SBCStage_v1.pdf

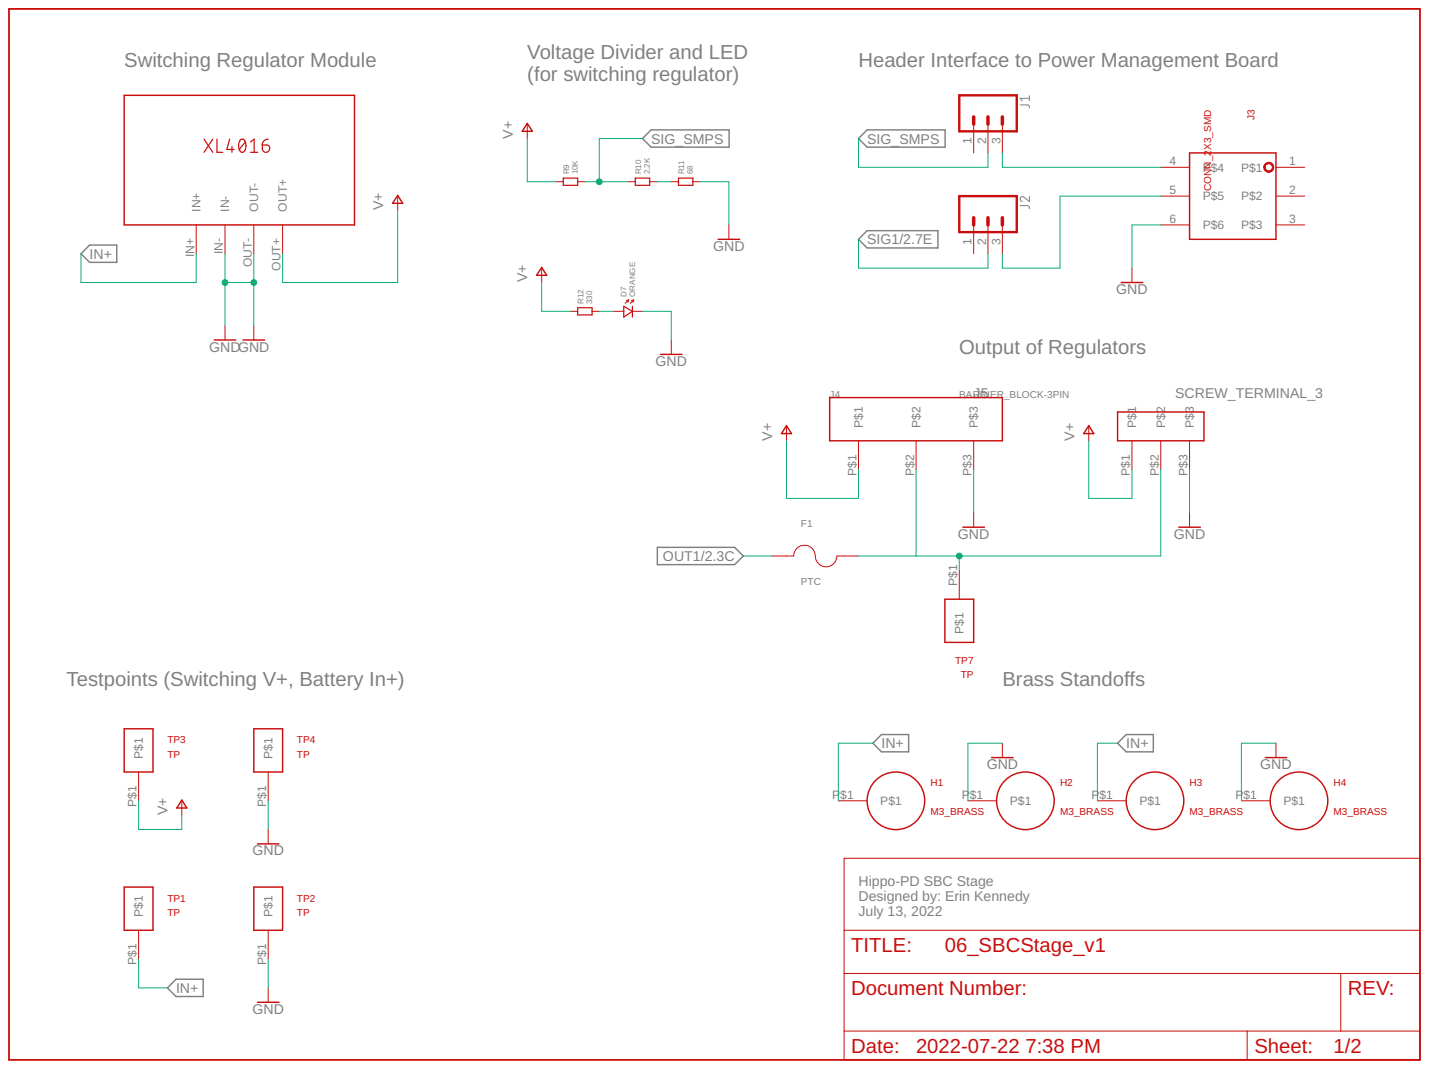
[picture p54: page 1]

IN- OUT- OUT- OUT+ OUT+

Hippo-PD SBC Stage Designed by: Erin Kennedy
July 13, 2022
TITLE:

Document Number: | REV:

Date: 2022-07-22 7:38 PM | Sheet: 1/2

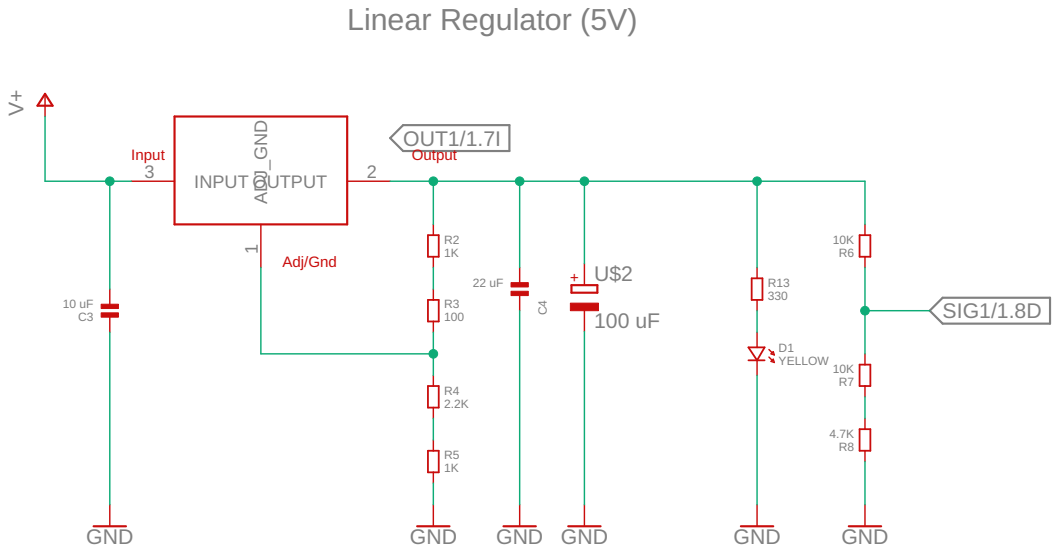
[picture p55: page 2]

V+ GND GND GND GND GND GND

Hippo-PD SBC Stage Designed by: Erin Kennedy
July 13, 2022
TITLE:

Document Number: | REV:

Date: 2022-07-22 7:38 PM | Sheet: 2/2
