RobotGrrl/KitePropulsion/Electronics/05_ServoStage_v1/05_ServoStage_v1.pdf

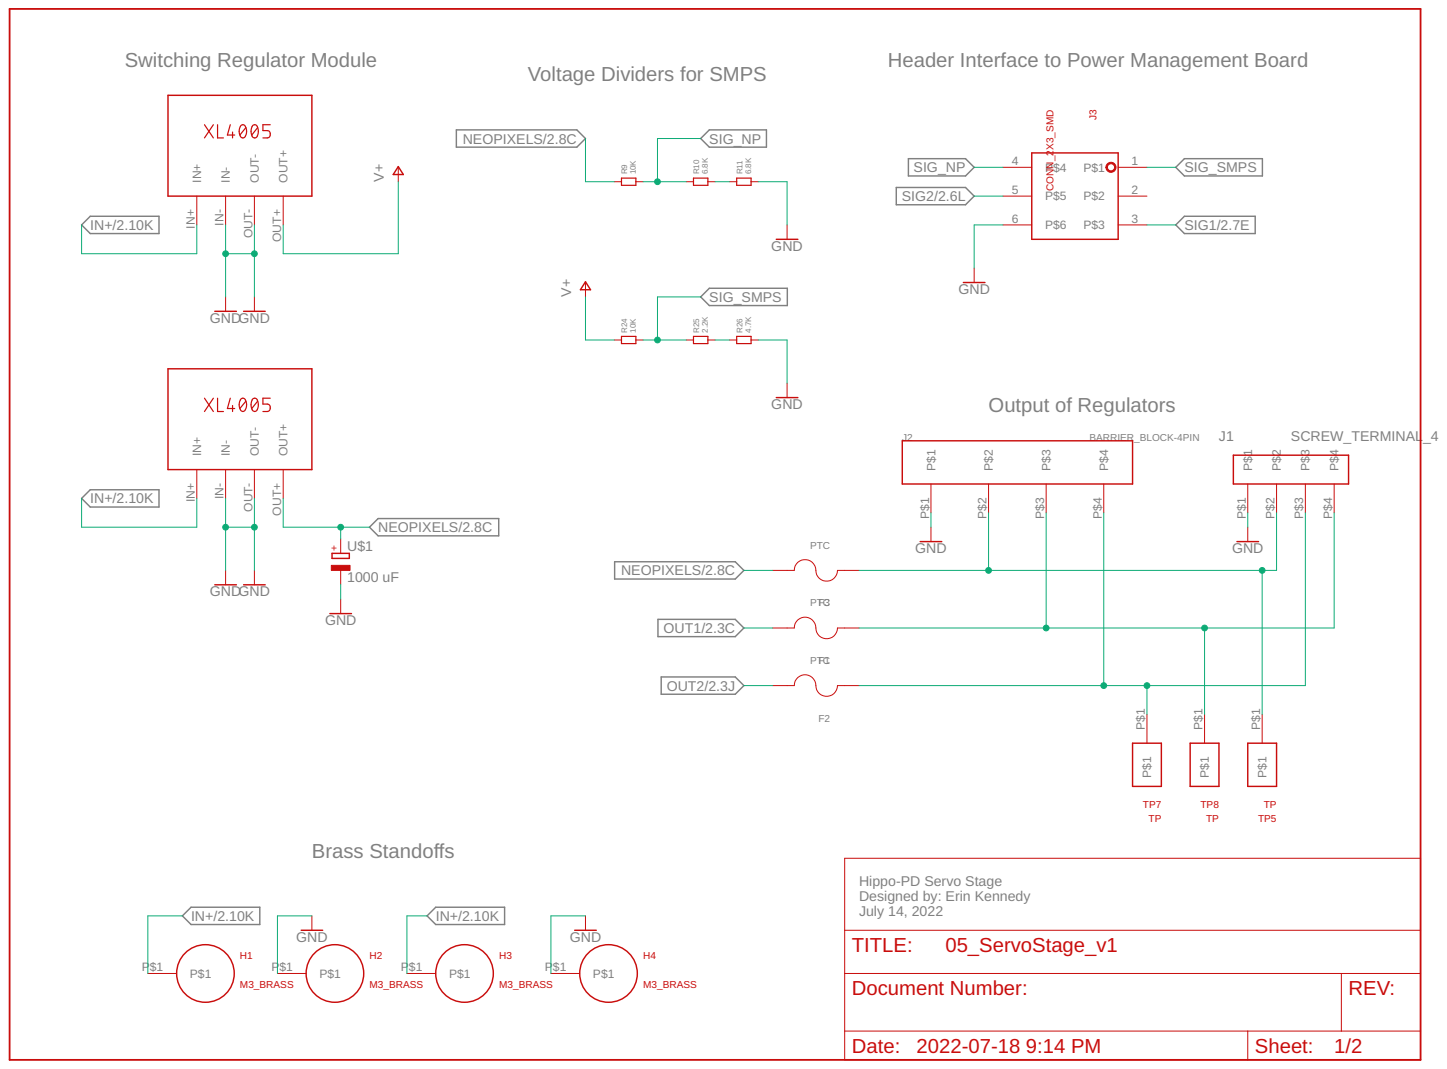
[picture p56: page 1]

Header Interface to Power Management Board

Voltage Dividers for SMPS

IN- OUT- OUT- OUT+ OUT+

IN- OUT- OUT- OUT+ OUT+ U$1

Hippo-PD Servo Stage Designed by: Erin Kennedy

Document Number: | REV:

Date: 2022-07-18 9:14 PM | Sheet: 1/2

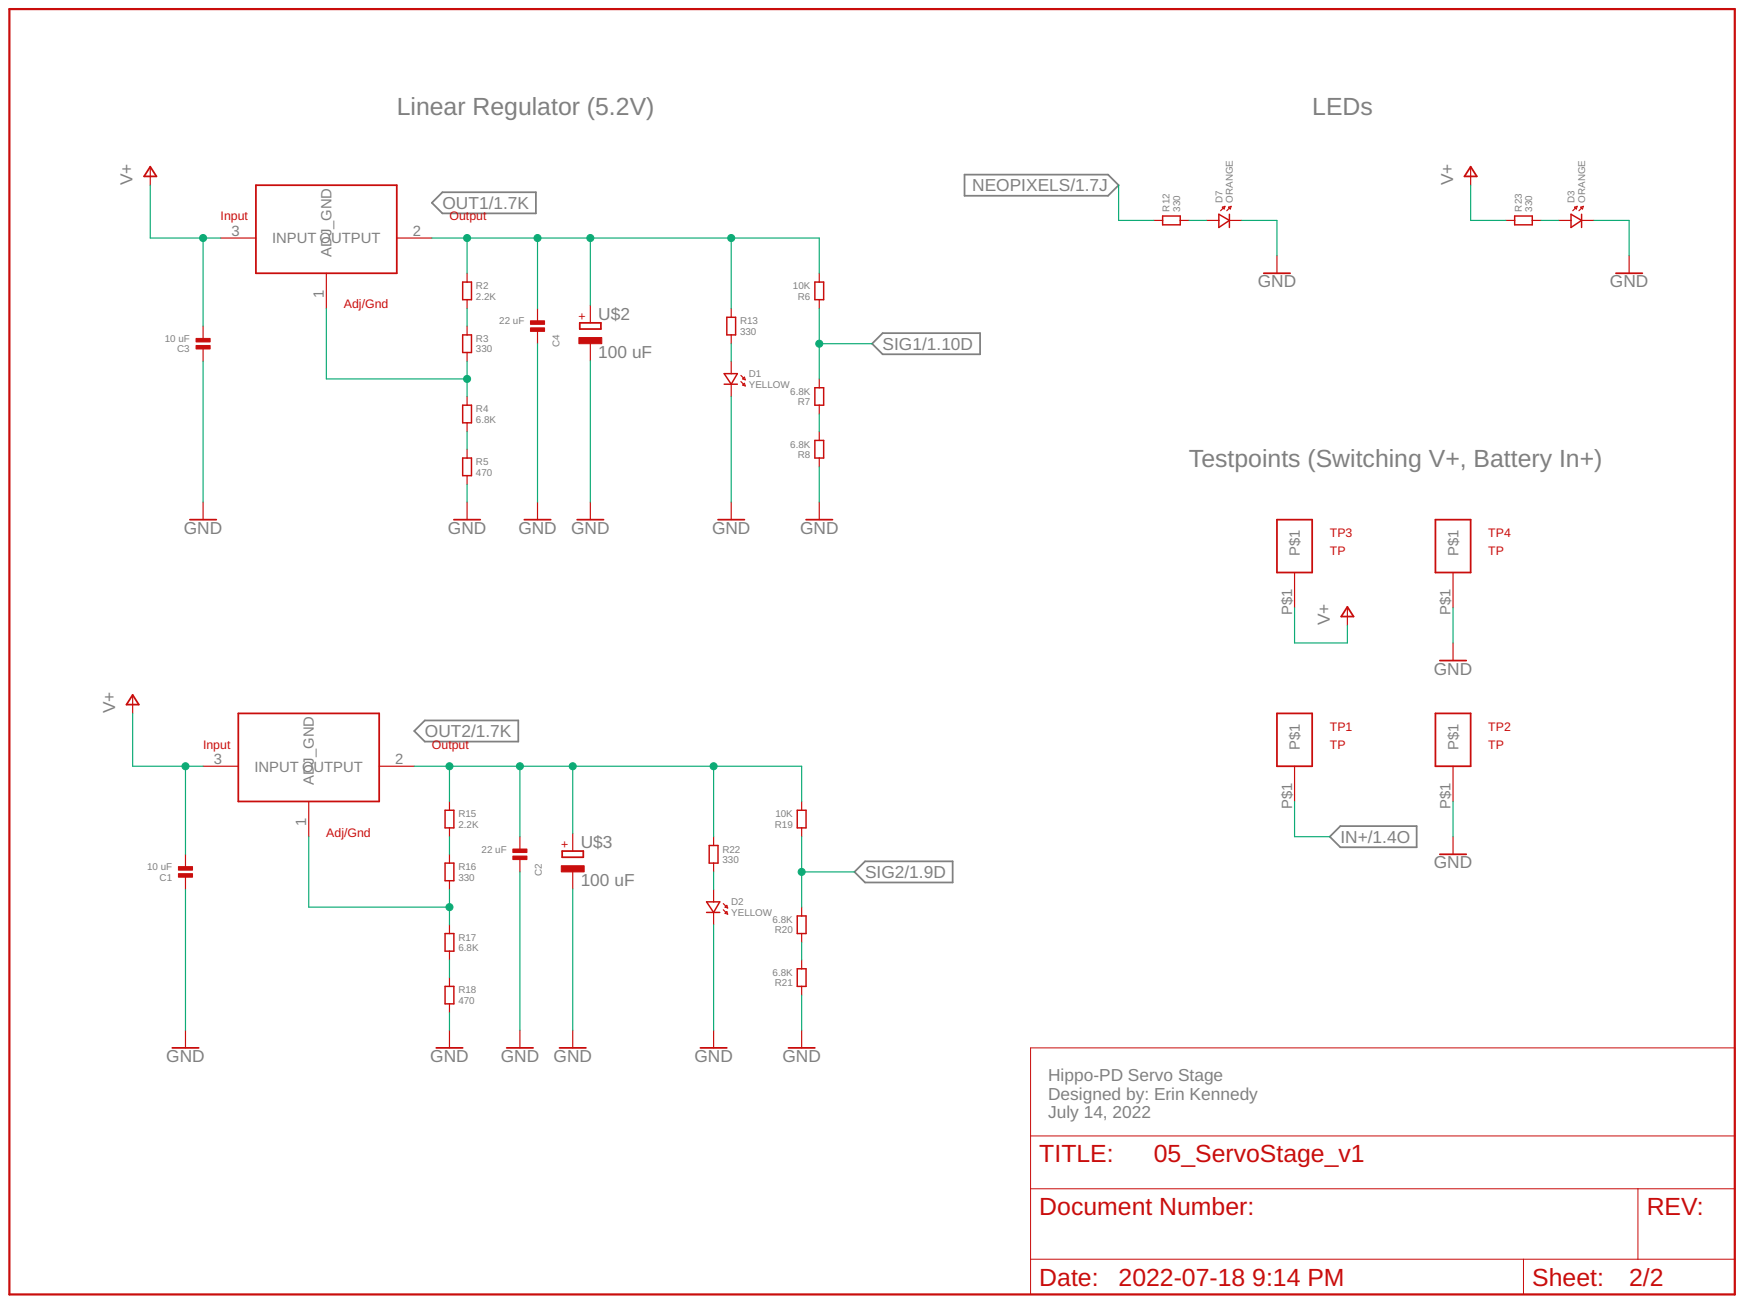
[picture p57: page 2]

V+ GND GND GND GND GND GND

Testpoints (Switching V+, Battery In+)

Hippo-PD Servo Stage Designed by: Erin Kennedy
July 14, 2022
TITLE:

Document Number: | REV:

Date: 2022-07-18 9:14 PM | Sheet: 2/2
