RobotGrrl/KitePropulsion/Electronics/04_ControllerStage_v1/04_ControllerStage_v1.pdf

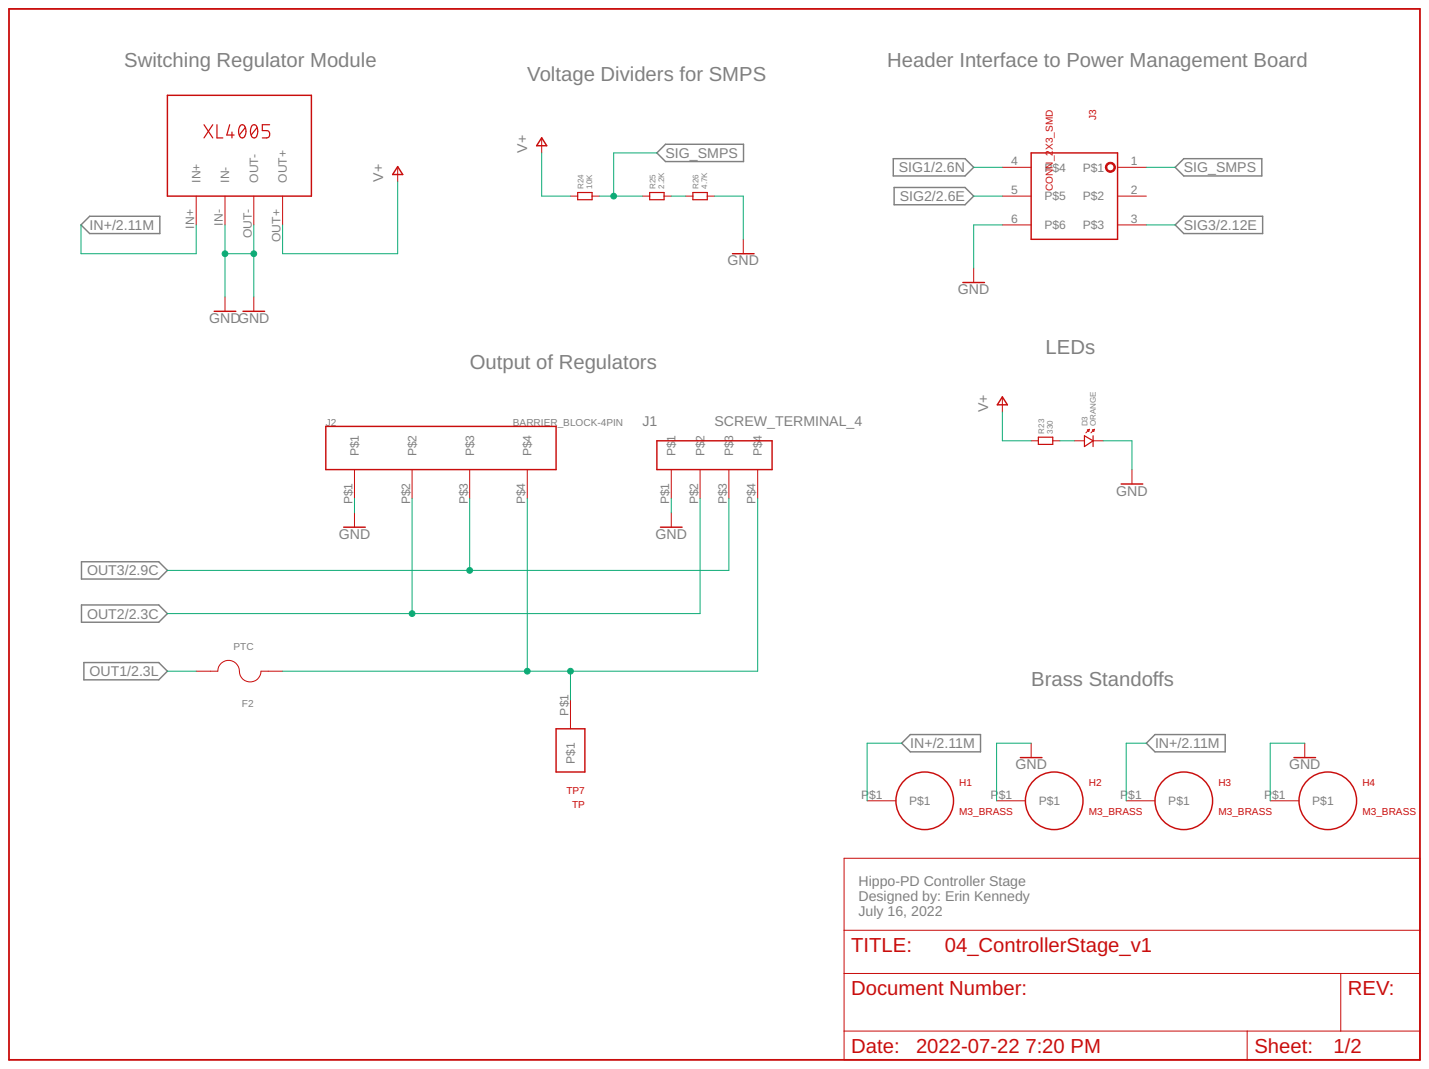
[picture p58: page 1]

Header Interface to Power Management Board

Voltage Dividers for SMPS

IN- OUT- OUT- OUT+ OUT+

Hippo-PD Controller Stage Designed by: Erin Kennedy
July 16, 2022
TITLE:

Document Number: | REV:

Date: 2022-07-22 7:20 PM | Sheet: 1/2

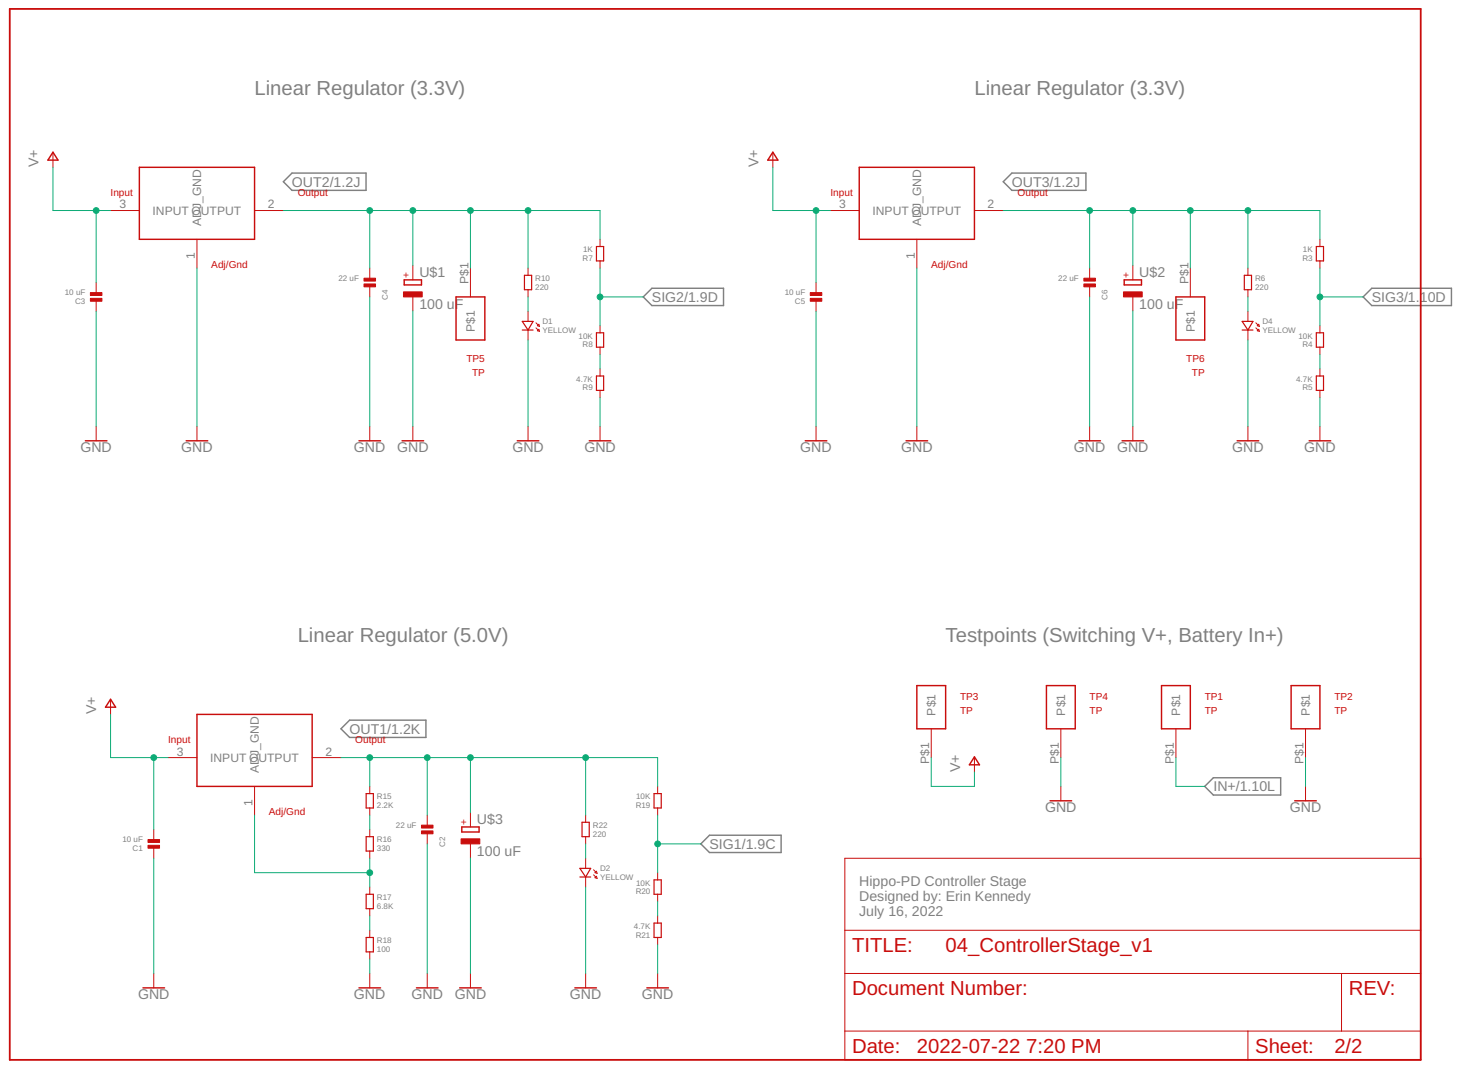
[picture p59: page 2]

V+ GND GND GND GND GND GND

Testpoints (Switching V+, Battery In+)

Hippo-PD Controller Stage Designed by: Erin Kennedy
July 16, 2022
TITLE:

Document Number: | REV:

Date: 2022-07-22 7:20 PM | Sheet: 2/2
