RobotGrrl/KitePropulsion/Electronics/03_MotorStage_v1/03_MotorStage_v1.pdf

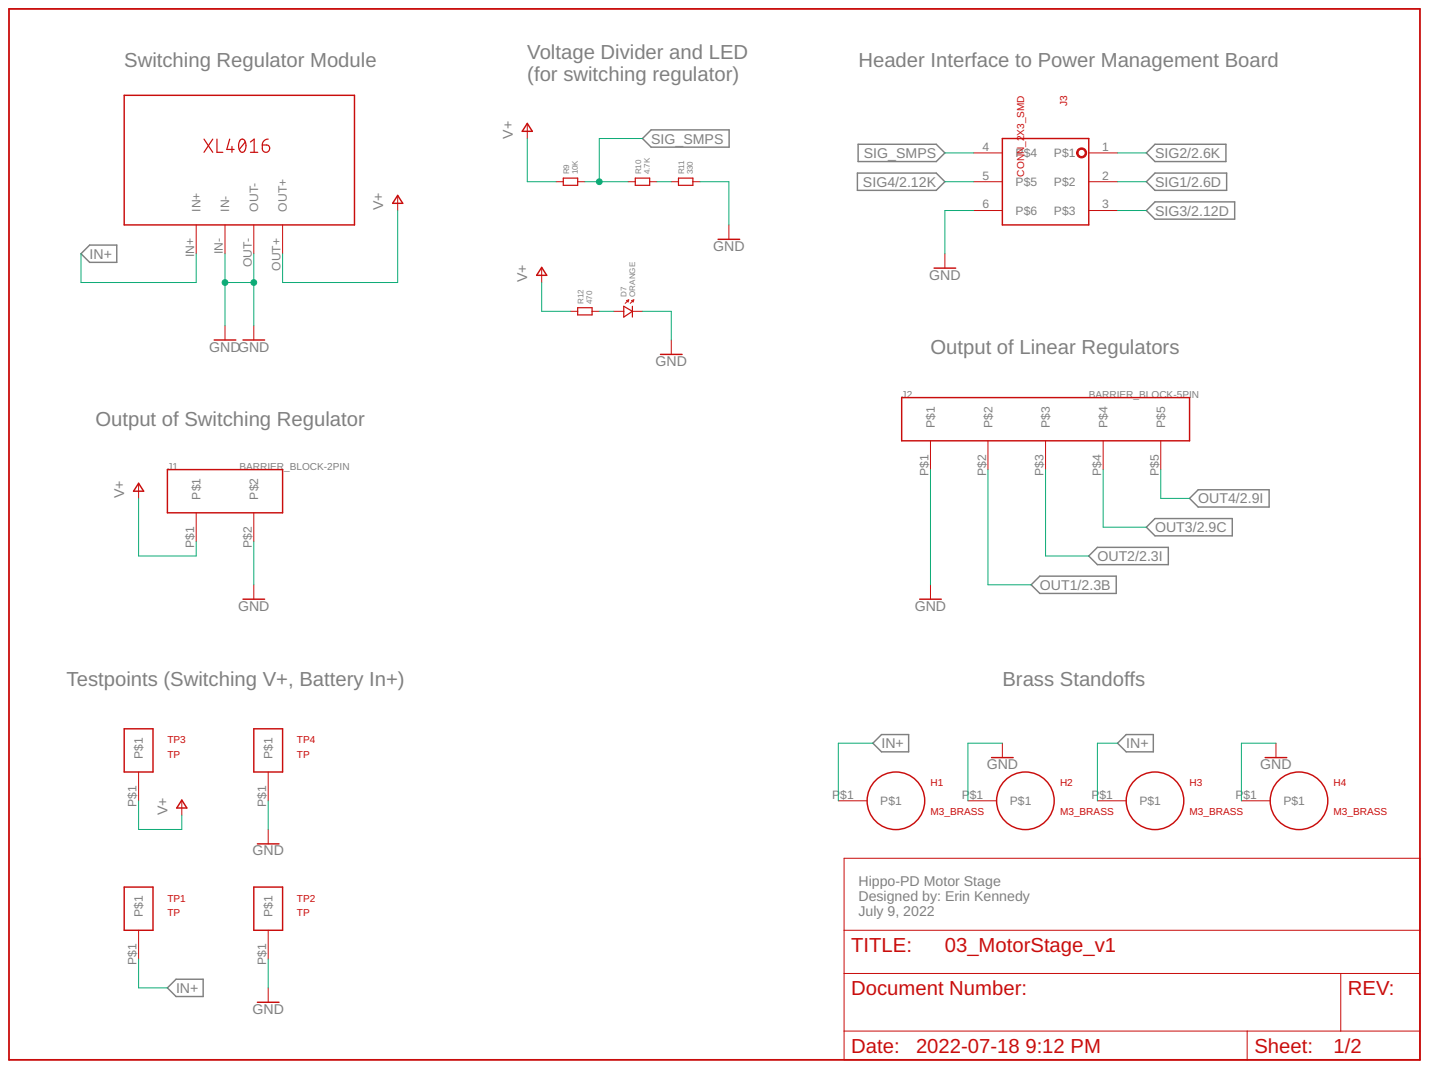
[picture p60: page 1]

IN- OUT- OUT- OUT+ OUT+

Output of Linear Regulators

Output of Switching Regulator

Hippo-PD Motor Stage Designed by: Erin Kennedy
July 9, 2022
TITLE:

Document Number: | REV:

Date: 2022-07-18 9:12 PM | Sheet: 1/2

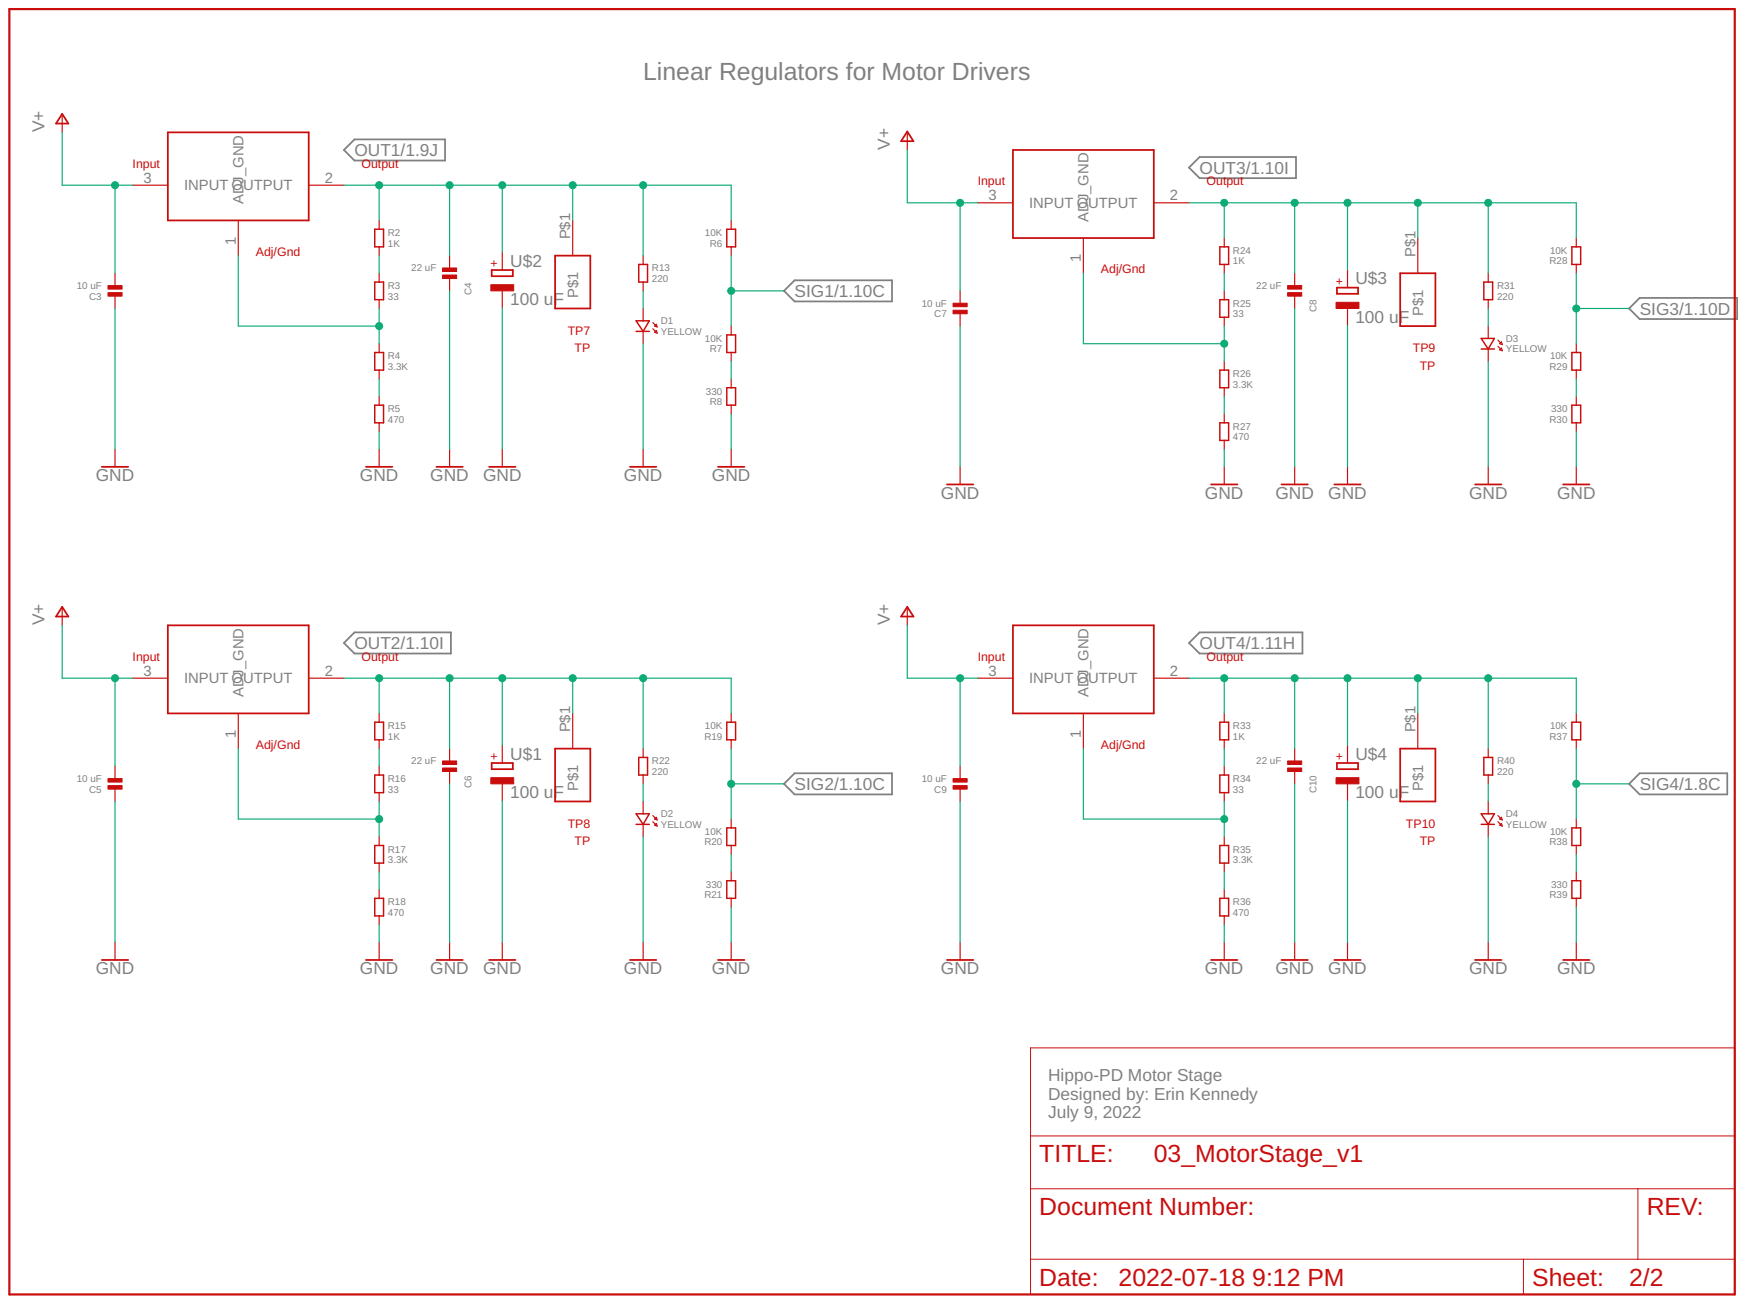
[picture p61: page 2]

Linear Regulators for Motor Drivers

V+ GND GND GND GND GND GND

Hippo-PD Motor Stage Designed by: Erin Kennedy
July 9, 2022
TITLE:

Document Number: | REV:

Date: 2022-07-18 9:12 PM | Sheet: 2/2
