RobotGrrl/KitePropulsion/Electronics/02_MonitorStage_v1/02_MonitorStage_v1.pdf

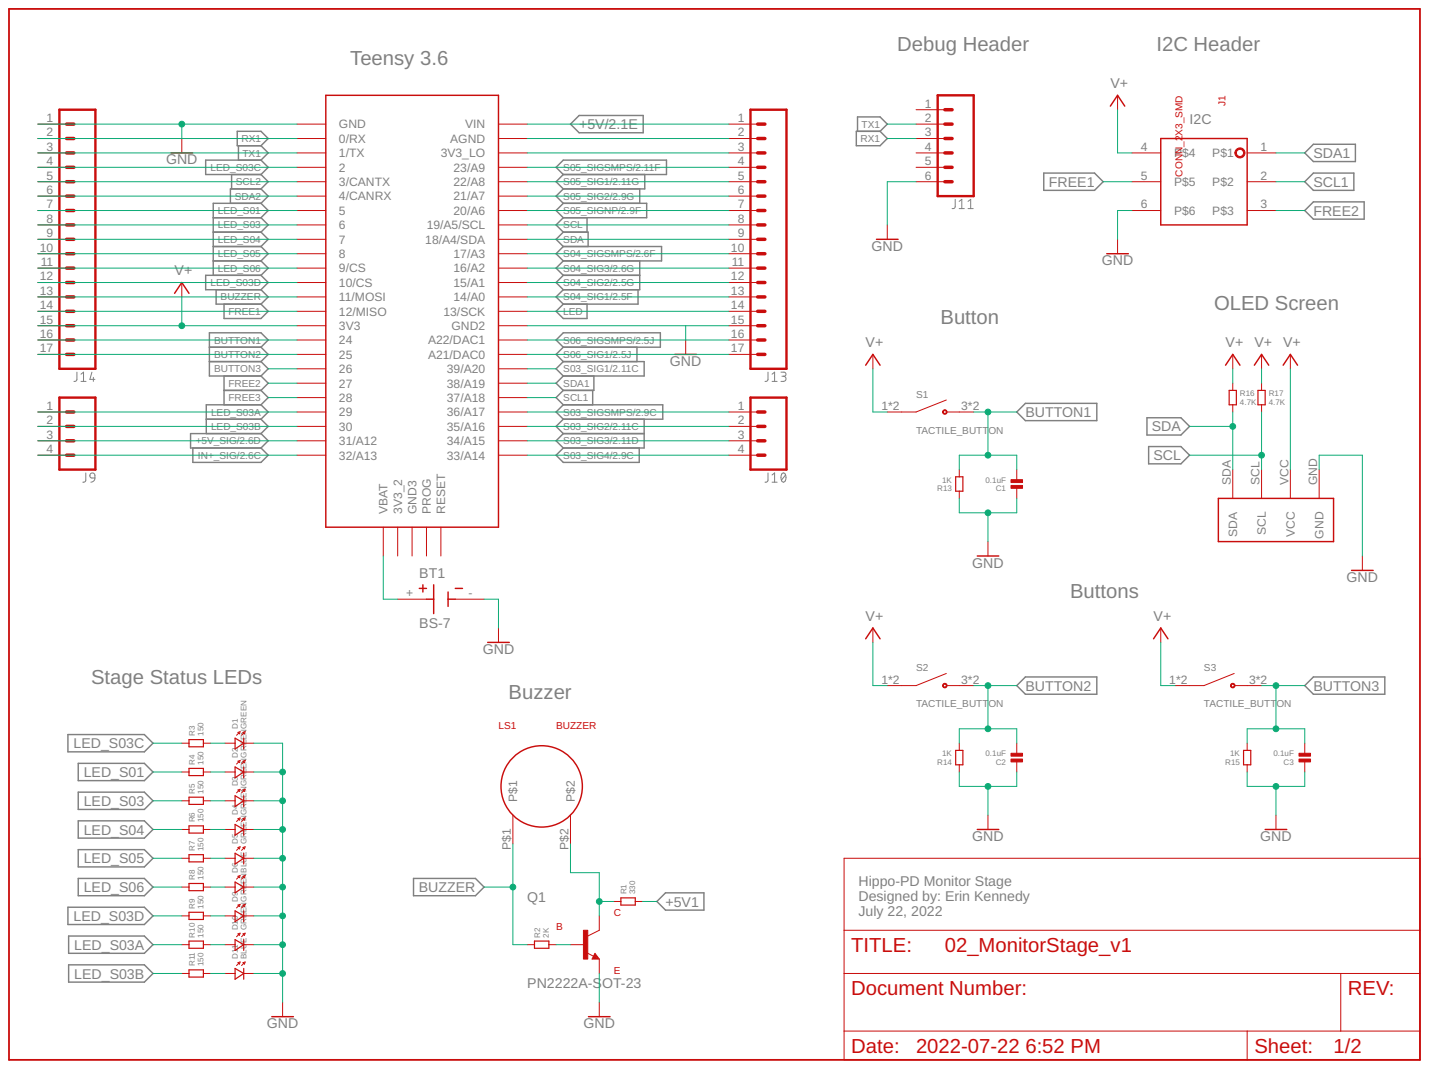
[picture p62: page 1]

GREEN GREEN GREEN GREEN GREEN BLUE

Hippo-PD Monitor Stage Designed by: Erin Kennedy
July 22, 2022
TITLE:
Document Number:

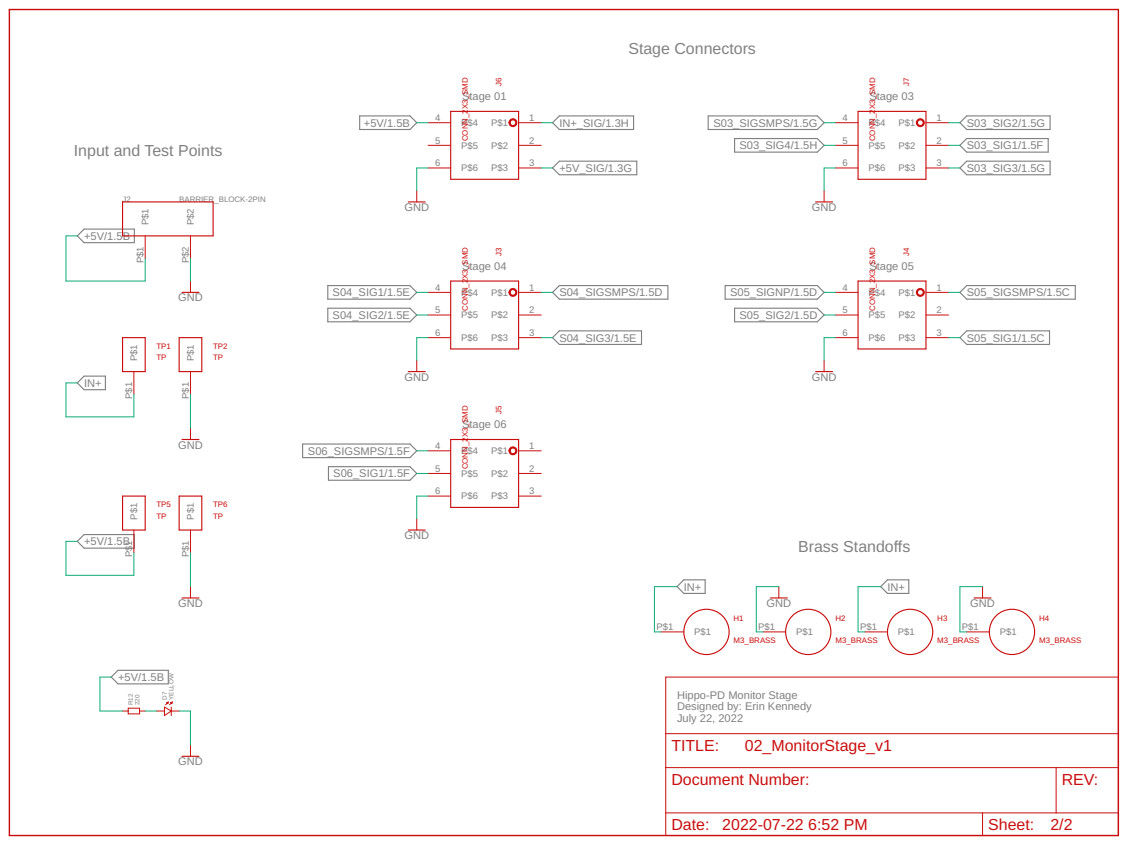
[picture p63: page 2]

Input and Test Points

Hippo-PD Monitor Stage Designed by: Erin Kennedy
July 22, 2022
TITLE:

Document Number: | REV:

Date: 2022-07-22 6:52 PM | Sheet: 2/2
