RobotGrrl/KitePropulsion/Electronics/01_InputStage_v1/01_InputStage_v1.pdf

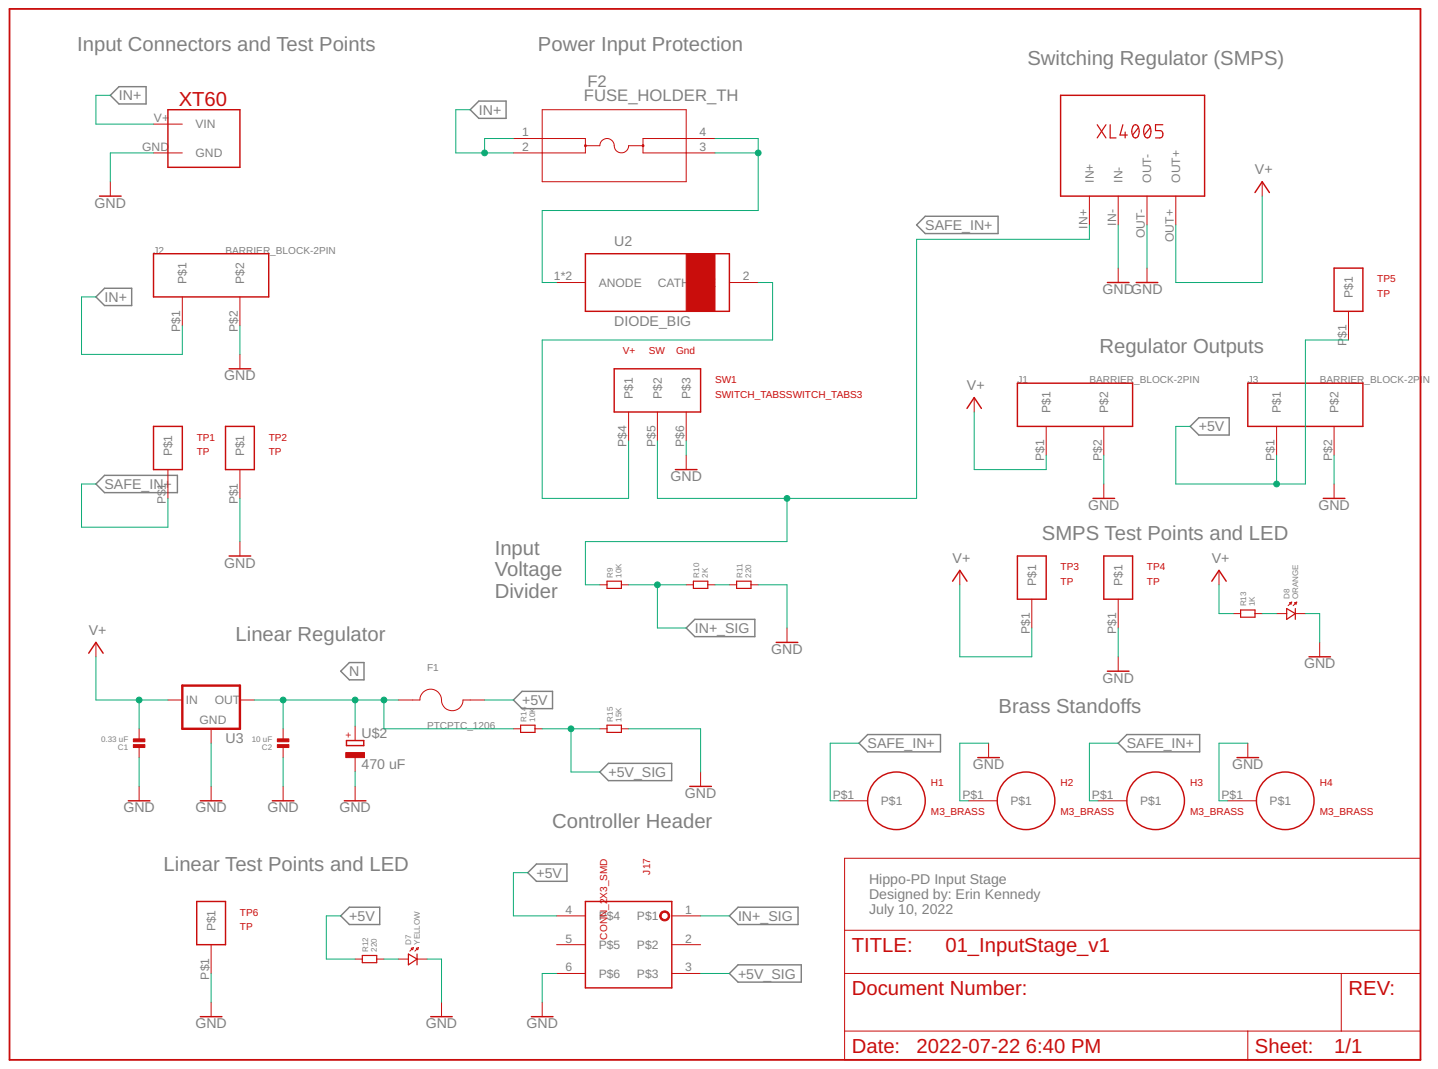
[picture p64: page 1]

Input Connectors and Test Points

Switching Regulator (SMPS) Power Input Protection

IN- OUT- OUT- OUT+ OUT+

GND
SMPS Test Points and LED

Linear Test Points and LED

Hippo-PD Input Stage Designed by: Erin Kennedy
July 10, 2022
TITLE:
Document Number:
