RobotGrrl/KitePropulsion/Electronics/00_CoverStage_v1/00_CoverStage_v1.pdf

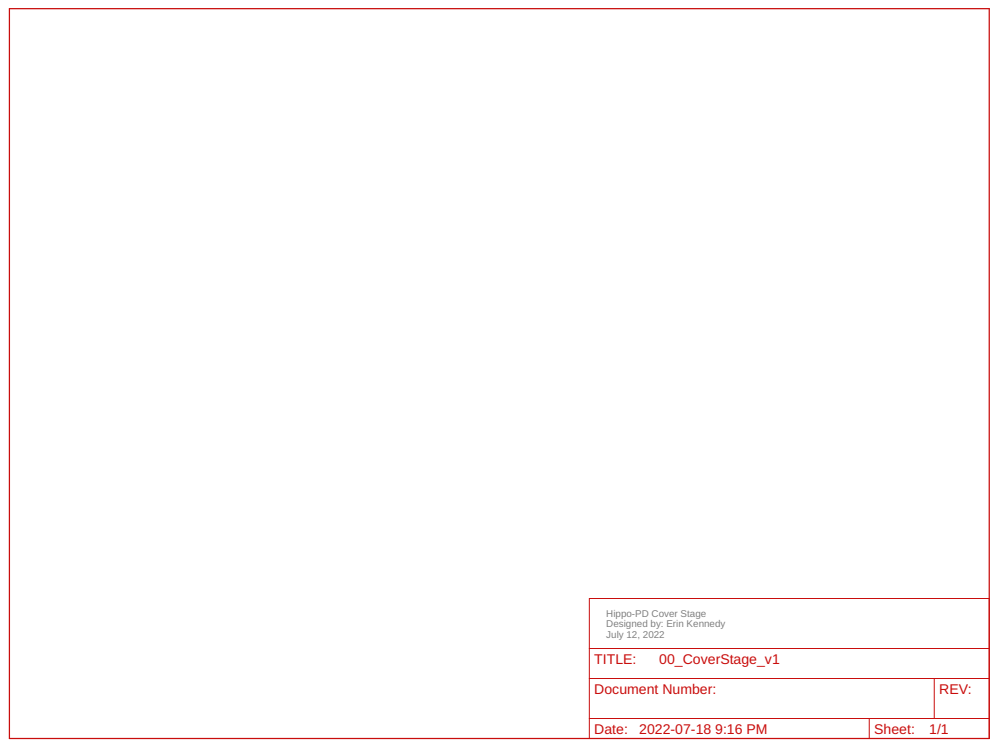
[picture p65: page 1]

Hippo-PD Cover Stage Designed by: Erin Kennedy
July 12, 2022
TITLE:

Document Number: | REV:

Date: 2022-07-18 9:16 PM | Sheet: 1/1
