RobotGrrl/KitePropulsion/Electronics/02_MonitorStage_v1/02_MonitorStage_v1.brd

## EAGLE design Electronics/02_MonitorStage_v1/02_MonitorStage_v1.brd (2022-08-03)

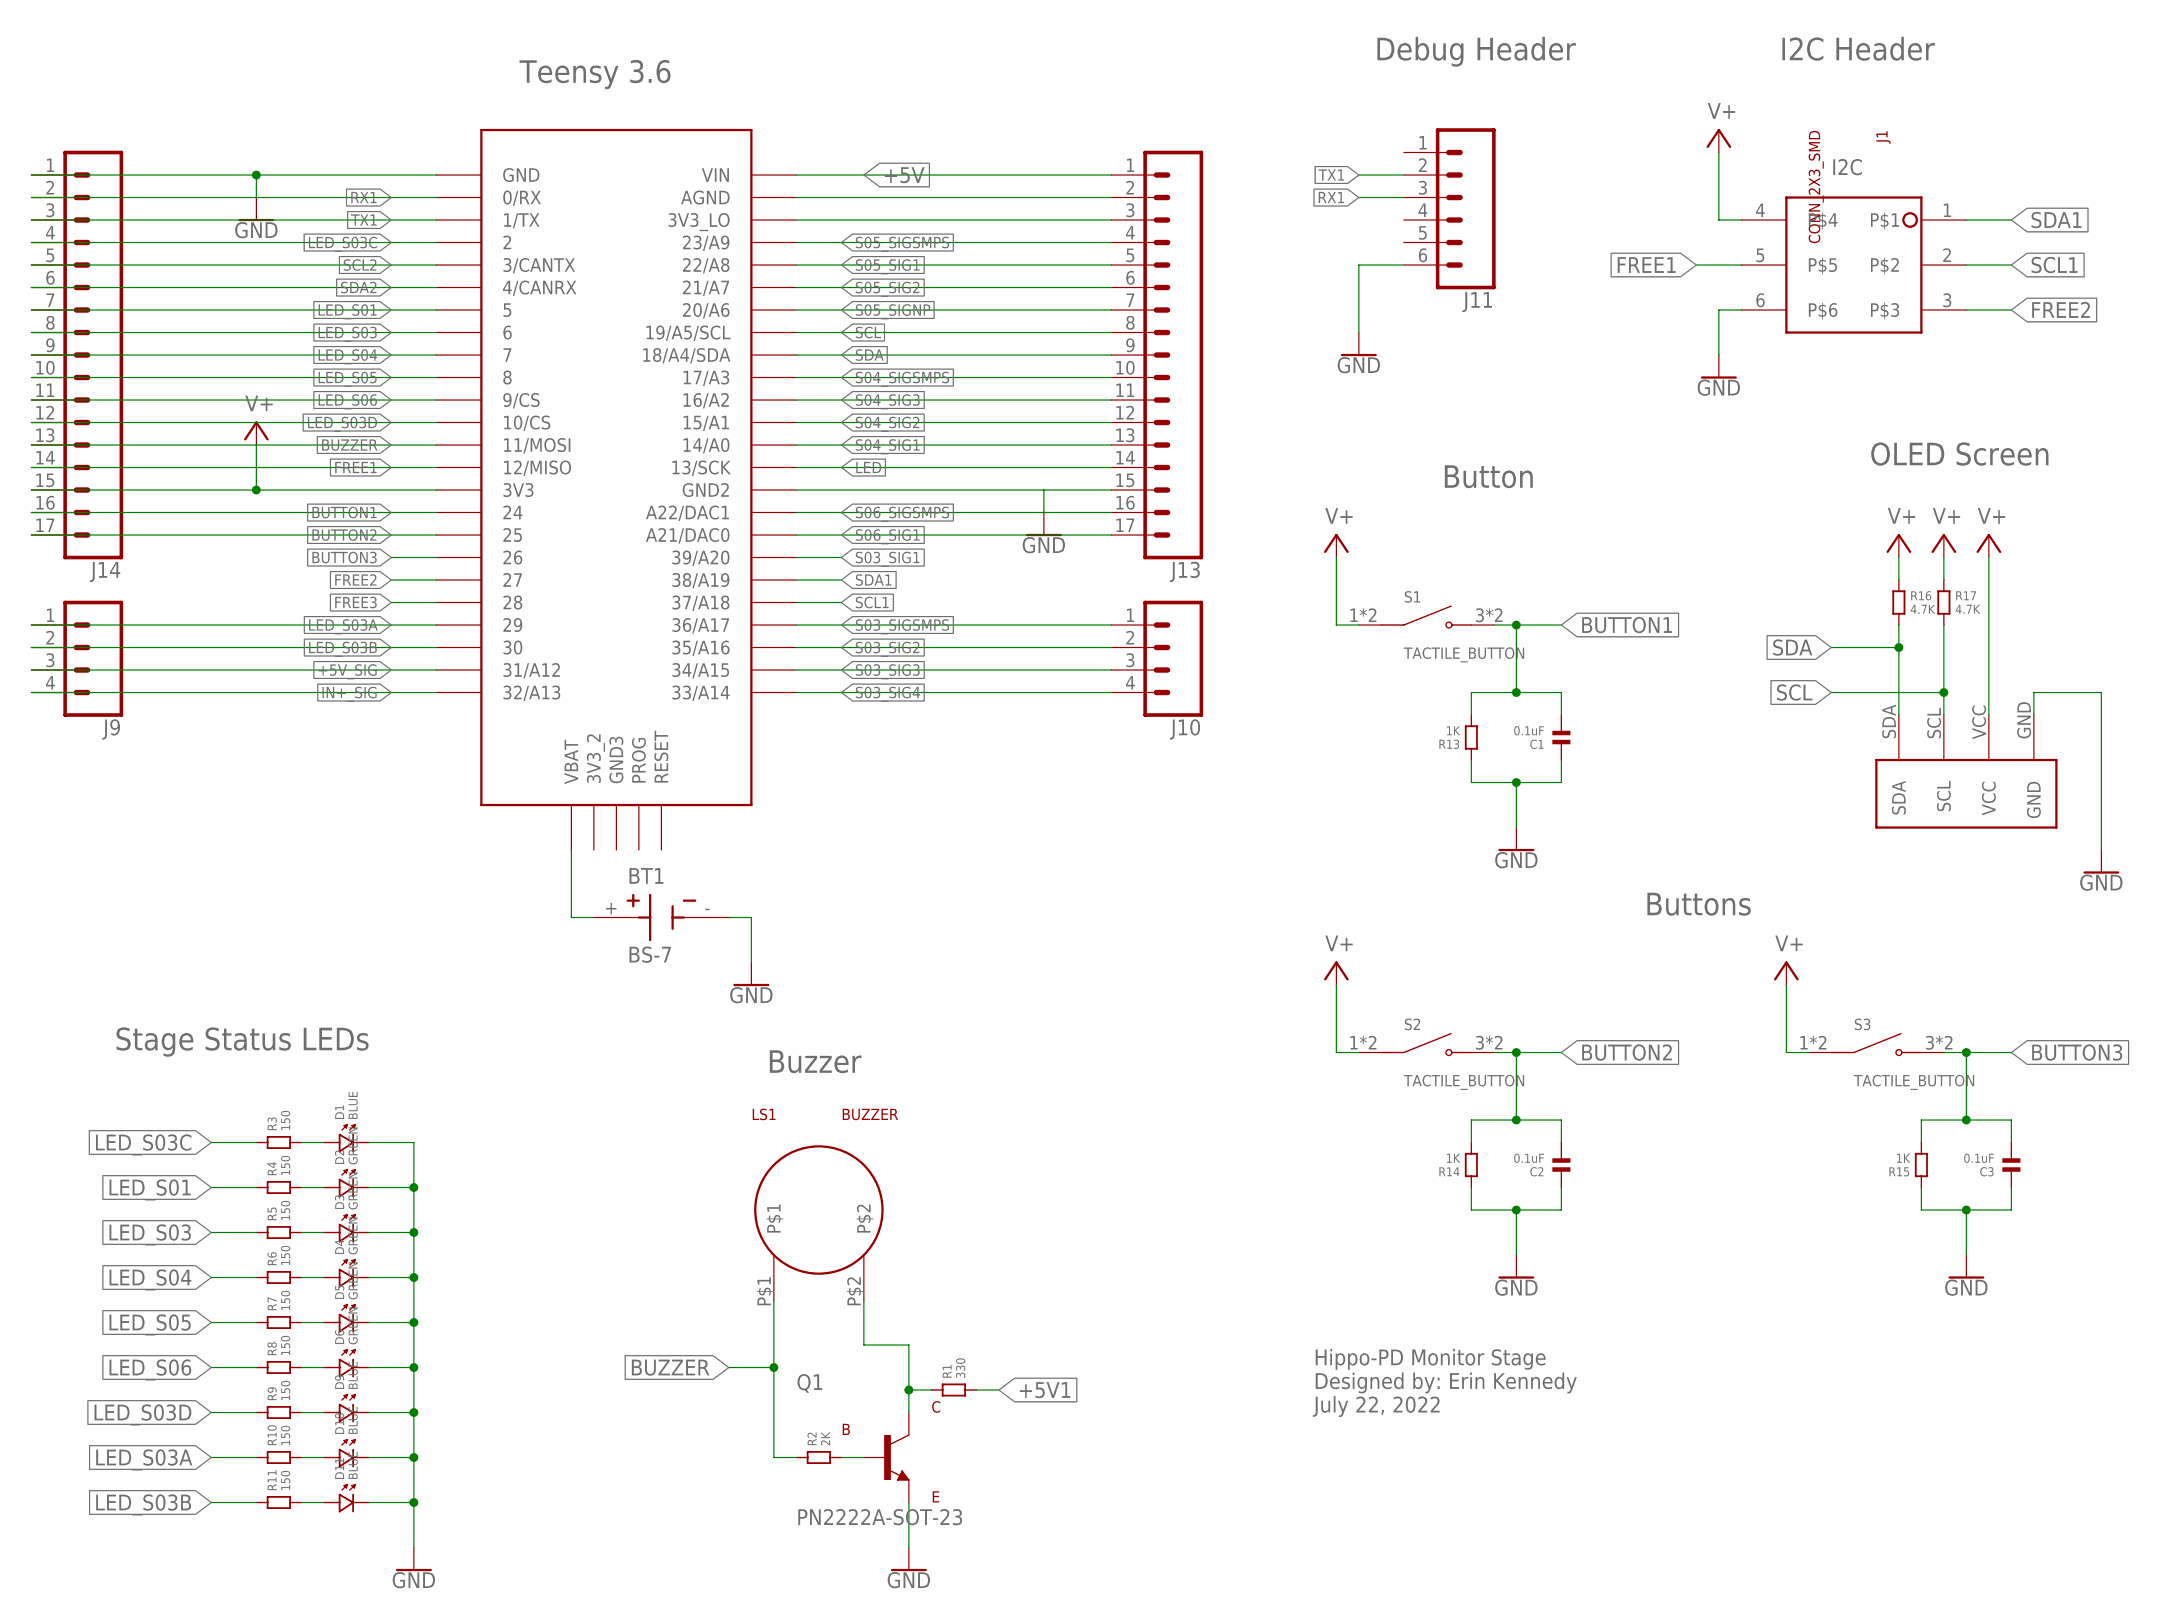
[picture p69: schematic 02_MonitorStage_v1.sch, sheet 1]

Parts:
BT1: BS-7; BAT_BS-7
C1, C2, C3: 0.1uF; 1206
D1, D9, D10, D11: BLUE; 1206.LED
D2, D3, D4, D5, D6: GREEN; 1206.LED
J1: CONN_2X3_SMD; 2X3_SMD_CONNECTOR
J9, J10: CONN_04; 1X04
J11: CONN_06; 1X06-SMD_RA_MALE_NO_HOLES
J13, J14: CONN_17; 1X17
LS1: BUZZER
Q1: PN2222A-SOT-23
R1: 330; 1206
R2: 2K; 1206
R3, R4, R5, R6, R7, R8, R9, R10, R11: 150; 1206
R13, R14, R15: 1K; 1206
R16, R17: 4.7K; 1206
S1, S2, S3: TACTILE_BUTTON
U1: TEENSY_3.5/3.6
U2: TINYSCREEN

Connections:
+5V: J13.1, U1.VIN; also elsewhere on the board
+5V1: R1.2
+5V_SIG: J9.3, U1.31/A12; also elsewhere on the board
BUTTON1: C1.2, J14.16, R13.2, S1.3 (NO), S1.4 (NO), U1.24
BUTTON2: C2.2, J14.17, R14.2, S2.3 (NO), S2.4 (NO), U1.25
BUTTON3: C3.2, R15.2, S3.3 (NO), S3.4 (NO), U1.26
BUZZER: J14.13, LS1.P$1, R2.1, U1.11/MOSI
FREE1: J1.5, J14.14, U1.12/MISO
FREE2: J1.3, U1.27
FREE3: U1.28
GND: BT1.-, C1.1, C2.1, C3.1, D1.P$2 (2), D2.P$2 (2), D3.P$2 (2), D4.P$2 (2), D5.P$2 (2), D6.P$2 (2), D9.P$2 (2), D10.P$2 (2), D11.P$2 (2), J1.6, J11.6, J13.15, J14.1, Q1.EMITTER, R13.1, R14.1, R15.1, U1.GND, U1.GND2, U2.GND; also elsewhere on the board
IN+_SIG: J9.4, U1.32/A13; also elsewhere on the board
LED: J13.14, U1.13/SCK
LED_S01: J14.7, R4.1, U1.5
LED_S03: J14.8, R5.1, U1.6
LED_S03A: J9.1, R10.1, U1.29
LED_S03B: J9.2, R11.1, U1.30
LED_S03C: J14.4, R3.1, U1.2
LED_S03D: J14.12, R9.1, U1.10/CS
LED_S04: J14.9, R6.1, U1.7
LED_S05: J14.10, R7.1, U1.8
LED_S06: J14.11, R8.1, U1.9/CS
unnamed: BT1.+, U1.VBAT
unnamed: D1.P$1 (1), R3.2
unnamed: D2.P$1 (1), R4.2
unnamed: J13.2, U1.AGND
unnamed: D3.P$1 (1), R5.2
unnamed: D4.P$1 (1), R6.2
unnamed: D5.P$1 (1), R7.2
unnamed: D6.P$1 (1), R8.2
unnamed: D9.P$1 (1), R9.2
unnamed: D10.P$1 (1), R10.2
unnamed: D11.P$1 (1), R11.2
unnamed: LS1.P$2, Q1.COLLECTOR, R1.1
unnamed: J13.3, U1.3V3_LO
unnamed: Q1.BASE, R2.2
RX1: J11.3, J14.2, U1.0/RX
S03_SIG1: U1.39/A20; also elsewhere on the board
S03_SIG2: J10.2, U1.35/A16; also elsewhere on the board
S03_SIG3: J10.3, U1.34/A15; also elsewhere on the board
S03_SIG4: J10.4, U1.33/A14; also elsewhere on the board
S03_SIGSMPS: J10.1, U1.36/A17; also elsewhere on the board
S04_SIG1: J13.13, U1.14/A0; also elsewhere on the board
S04_SIG2: J13.12, U1.15/A1; also elsewhere on the board
S04_SIG3: J13.11, U1.16/A2; also elsewhere on the board
S04_SIGSMPS: J13.10, U1.17/A3; also elsewhere on the board
S05_SIG1: J13.5, U1.22/A8; also elsewhere on the board
S05_SIG2: J13.6, U1.21/A7; also elsewhere on the board
S05_SIGNP: J13.7, U1.20/A6; also elsewhere on the board
S05_SIGSMPS: J13.4, U1.23/A9; also elsewhere on the board
S06_SIG1: J13.17, U1.21/DAC0 (A21/DAC0); also elsewhere on the board
S06_SIGSMPS: J13.16, U1.A22/DAC1; also elsewhere on the board
SCL: J13.8, R17.2, U1.19/A5/SCL, U2.SCL
SCL1: J1.2, U1.37/A18
SCL2: J14.5, U1.3/CANTX
SDA: J13.9, R16.2, U1.18/A4/SDA, U2.SDA
SDA1: J1.1, U1.38/A19
SDA2: J14.6, U1.4/CANRX
TX1: J11.2, J14.3, U1.1/TX
V+: J1.4, J14.15, R16.1, R17.1, S1.1 (COM), S1.2 (COM), S2.1 (COM), S2.2 (COM), S3.1 (COM), S3.2 (COM), U1.3V3, U2.VCC

Notes on the sheet:
I2C
Hippo-PD Monitor Stage Designed by: Erin Kennedy July 22, 2022
Teensy 3.6
Stage Status LEDs
Buzzer
Debug Header
I2C Header
OLED Screen
Button
Buttons

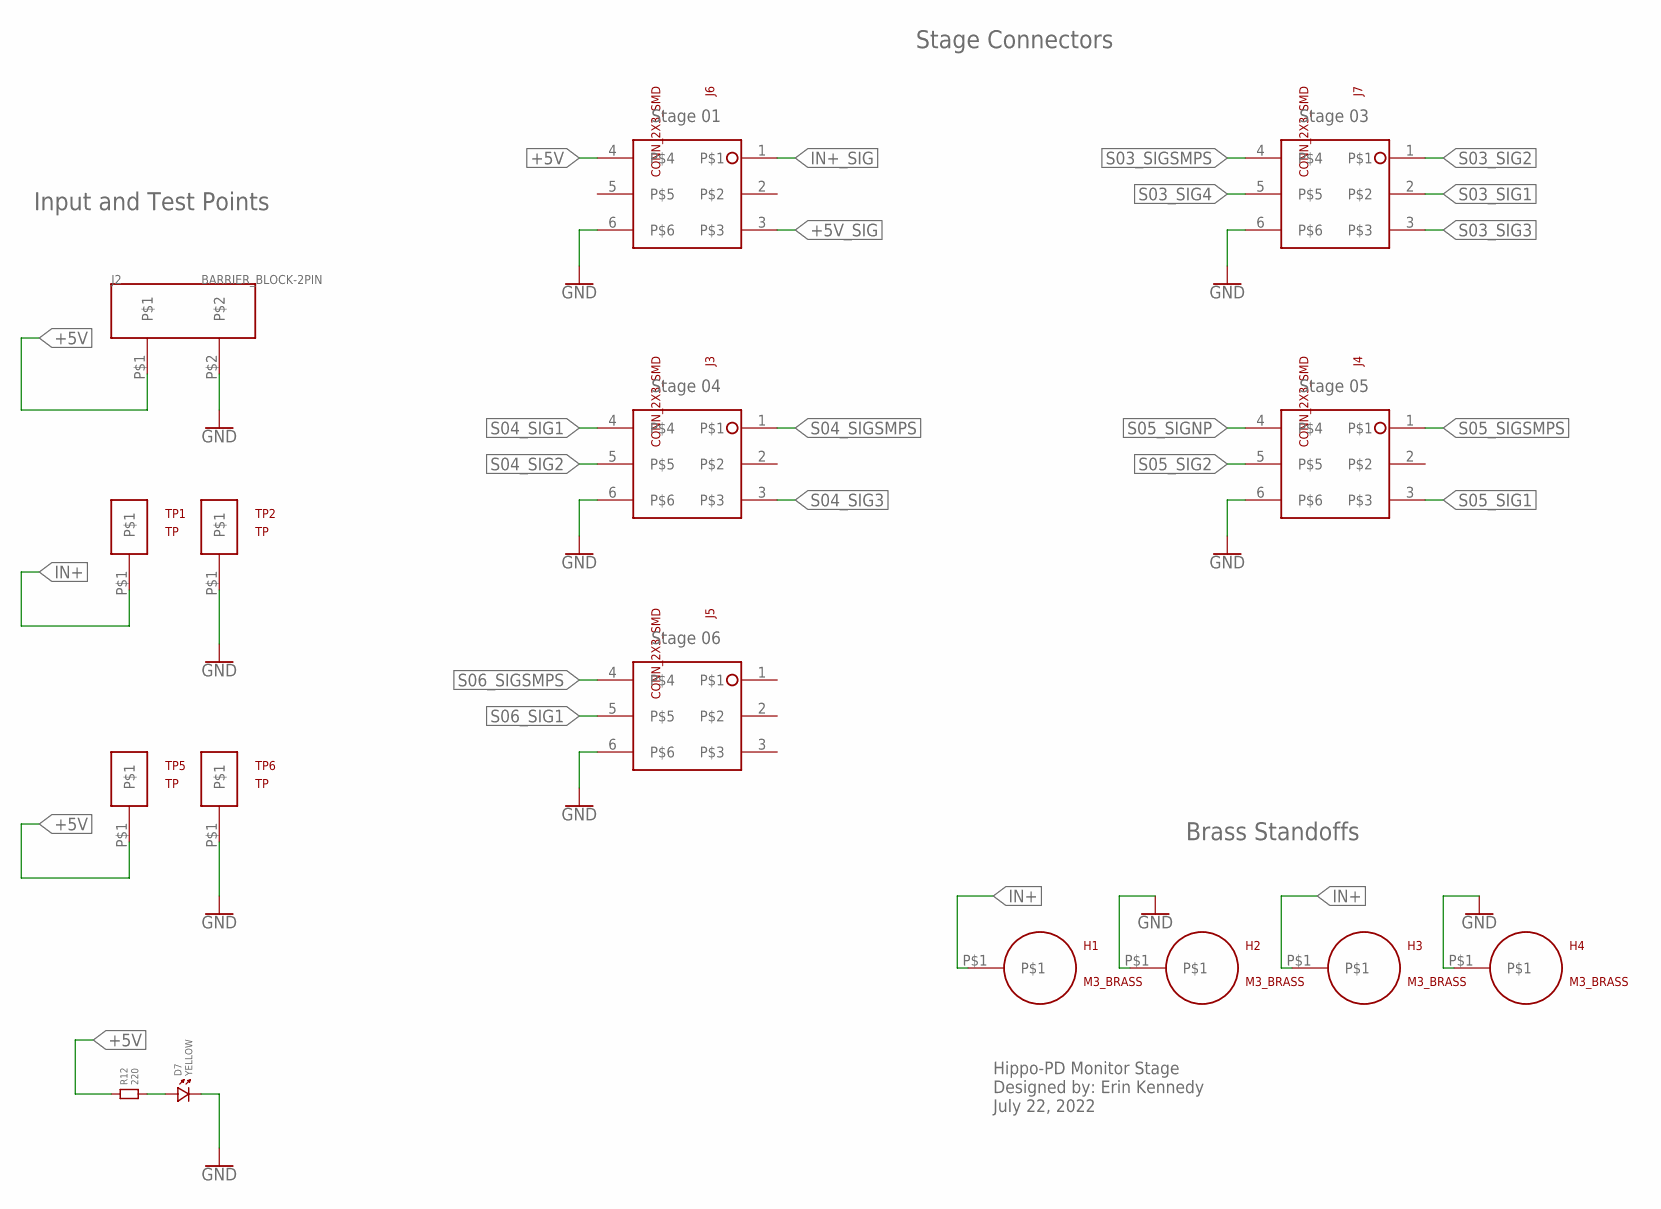
[picture p70: schematic 02_MonitorStage_v1.sch, sheet 2]

Parts:
D7: YELLOW; 1206.LED
H1, H2, H3, H4: M3_BRASS
J2: BARRIER_BLOCK-2PIN; BARRIERBLOCK-2PIN
J3, J4, J5, J6, J7: CONN_2X3_SMD; 2X3_SMD_CONNECTOR
R12: 220; 1206
TP1, TP2, TP5, TP6: TP

Connections:
+5V: J2.P$1, J6.4, R12.1, TP5.P$1; also elsewhere on the board
+5V_SIG: J6.3; also elsewhere on the board
GND: D7.P$2 (2), H2.P$1, H4.P$1, J2.P$2, J3.6, J4.6, J5.6, J6.6, J7.6, TP2.P$1, TP6.P$1; also elsewhere on the board
IN+: H1.P$1, H3.P$1, TP1.P$1
IN+_SIG: J6.1; also elsewhere on the board
unnamed: D7.P$1 (1), R12.2
S03_SIG1: J7.2; also elsewhere on the board
S03_SIG2: J7.1; also elsewhere on the board
S03_SIG3: J7.3; also elsewhere on the board
S03_SIG4: J7.5; also elsewhere on the board
S03_SIGSMPS: J7.4; also elsewhere on the board
S04_SIG1: J3.4; also elsewhere on the board
S04_SIG2: J3.5; also elsewhere on the board
S04_SIG3: J3.3; also elsewhere on the board
S04_SIGSMPS: J3.1; also elsewhere on the board
S05_SIG1: J4.3; also elsewhere on the board
S05_SIG2: J4.5; also elsewhere on the board
S05_SIGNP: J4.4; also elsewhere on the board
S05_SIGSMPS: J4.1; also elsewhere on the board
S06_SIG1: J5.5; also elsewhere on the board
S06_SIGSMPS: J5.4; also elsewhere on the board

Notes on the sheet:
Stage 01
Stage 03
Stage 04
Stage 05
Stage 06
Hippo-PD Monitor Stage Designed by: Erin Kennedy July 22, 2022
Input and Test Points
Brass Standoffs
Stage Connectors

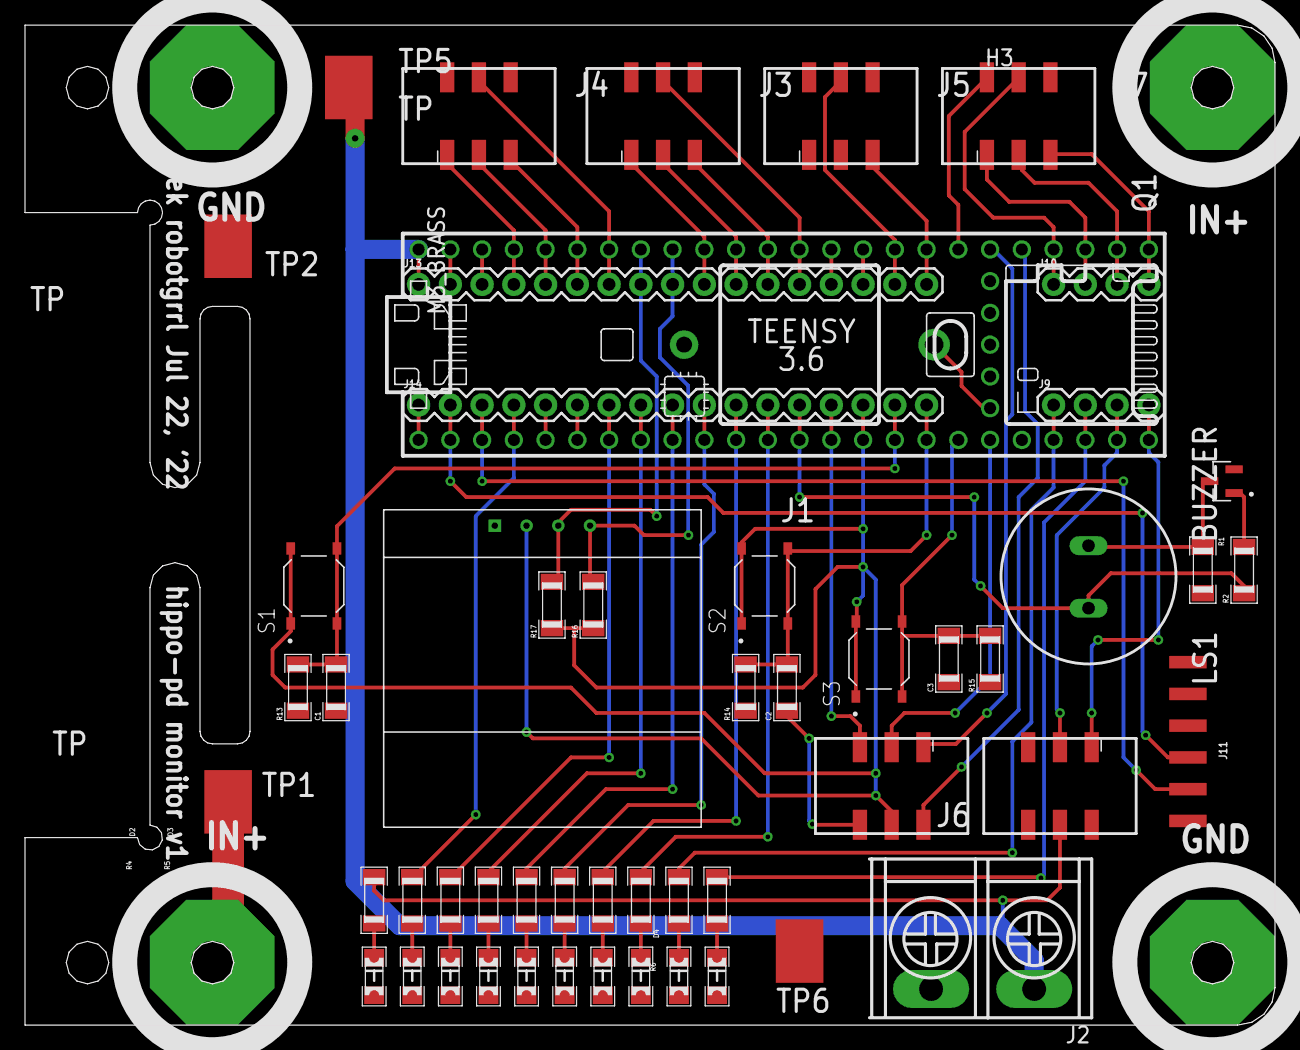
[picture p71: board 02_MonitorStage_v1.brd from above]

Board: 2 copper layers, 100.0 x 80.0 mm, 58 parts (1 on the bottom side), 60 nets.
