RobotGrrl/KitePropulsion/Electronics/03_MotorStage_v1/03_MotorStage_v1.brd

## EAGLE design Electronics/03_MotorStage_v1/03_MotorStage_v1.brd (2022-08-03)

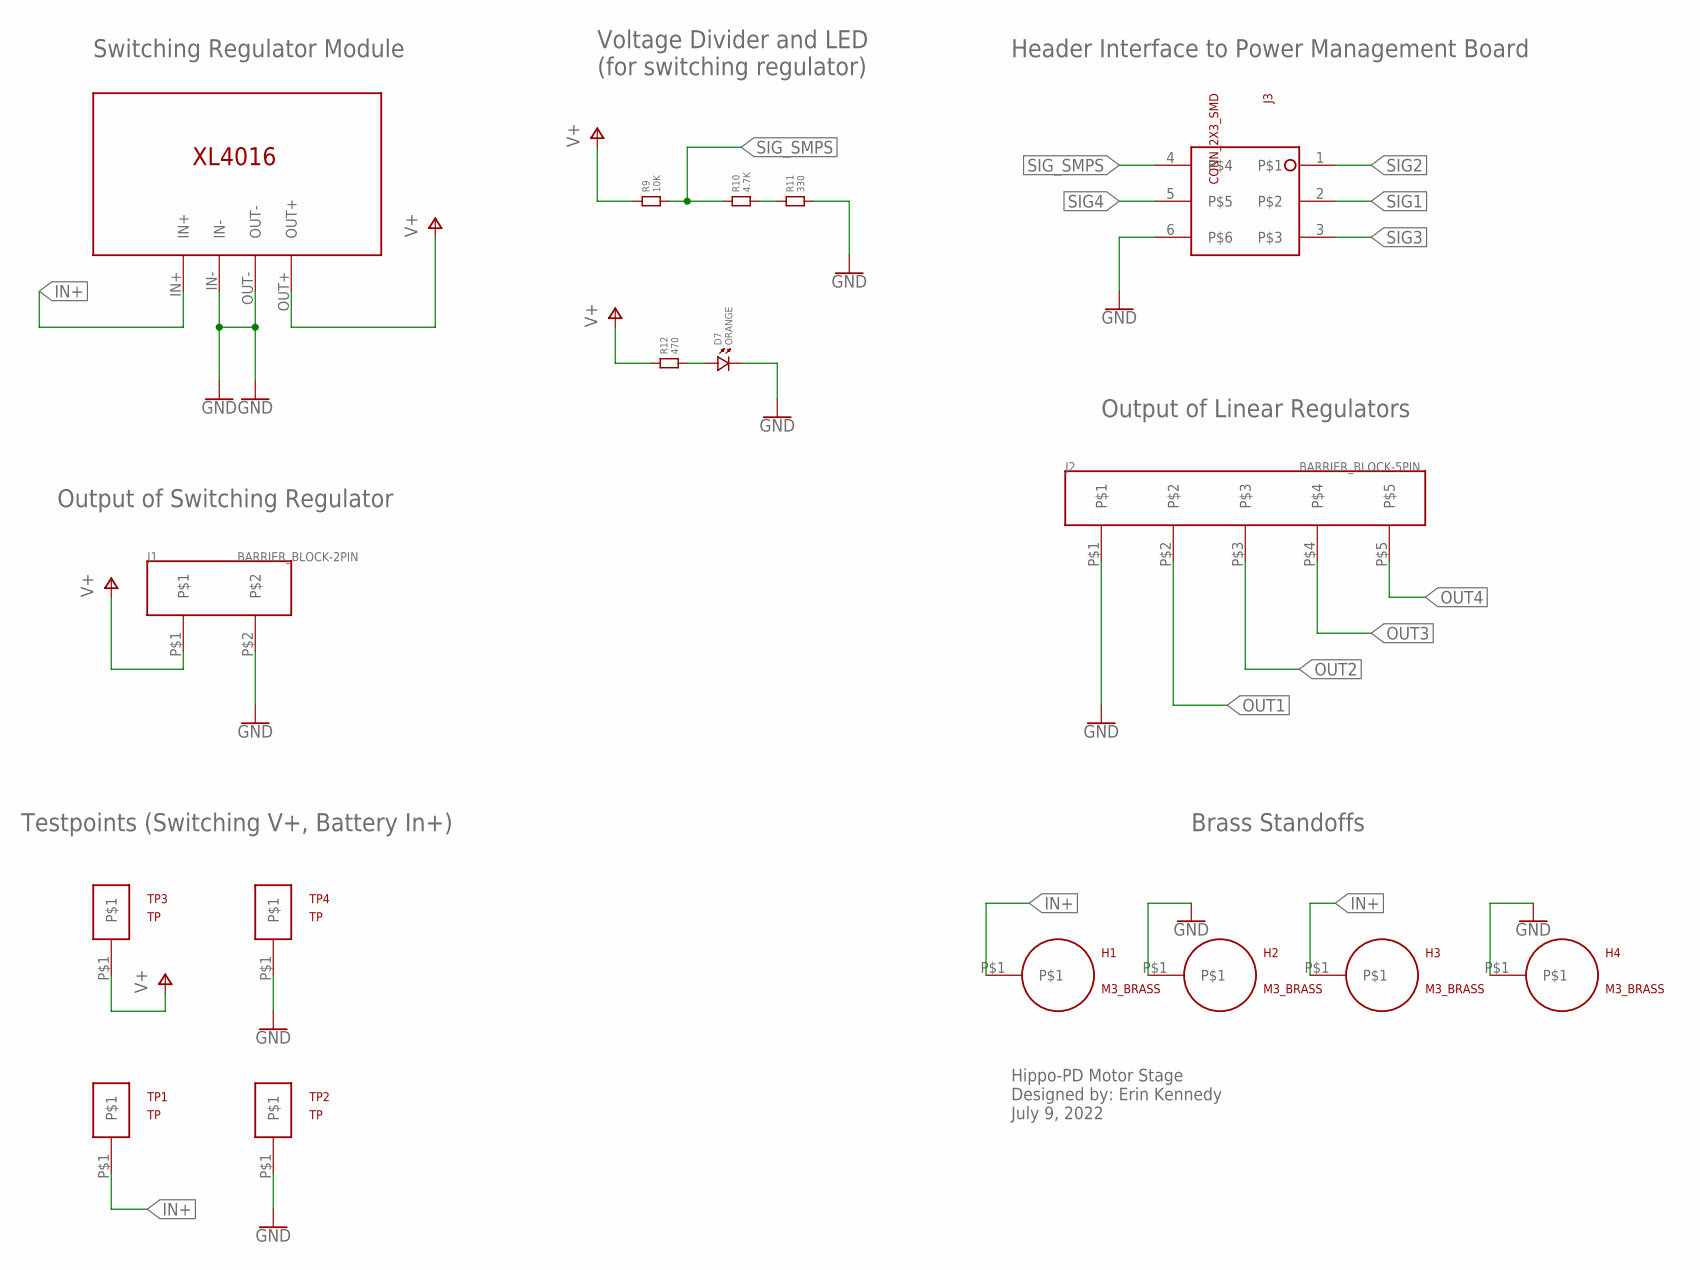
[picture p72: schematic 03_MotorStage_v1.sch, sheet 1]

Parts:
D7: ORANGE; 1206.LED
H1, H2, H3, H4: M3_BRASS
J1: BARRIER_BLOCK-2PIN; BARRIERBLOCK-2PIN
J2: BARRIER_BLOCK-5PIN; BARRIERBLOCK-5PIN
J3: CONN_2X3_SMD; 2X3_SMD_CONNECTOR
R9: 10K; 1206
R10: 4.7K; 1206
R11: 330; 1206
R12: 470; 1206
TP1, TP2, TP3, TP4: TP
U1: XL4016-DEV

Connections:
GND: D7.P$2 (2), H2.P$1, H4.P$1, J1.P$2, J2.P$1, J3.6, R11.2, TP2.P$1, TP4.P$1, U1.IN-, U1.OUT-; also elsewhere on the board
IN+: H1.P$1, H3.P$1, TP1.P$1, U1.IN+
unnamed: D7.P$1 (1), R12.2
unnamed: R10.2, R11.1
OUT1: J2.P$2; also elsewhere on the board
OUT2: J2.P$3; also elsewhere on the board
OUT3: J2.P$4; also elsewhere on the board
OUT4: J2.P$5; also elsewhere on the board
SIG1: J3.2; also elsewhere on the board
SIG2: J3.1; also elsewhere on the board
SIG3: J3.3; also elsewhere on the board
SIG4: J3.5; also elsewhere on the board
SIG_SMPS: J3.4, R9.2, R10.1
V+: J1.P$1, R9.1, R12.1, TP3.P$1, U1.OUT+; also elsewhere on the board

Notes on the sheet:
Switching Regulator Module
Voltage Divider and LED (for switching regulator)
Header Interface to Power Management Board
Output of Linear Regulators
Brass Standoffs
Testpoints (Switching V+, Battery In+)
Output of Switching Regulator
Hippo-PD Motor Stage Designed by: Erin Kennedy July 9, 2022

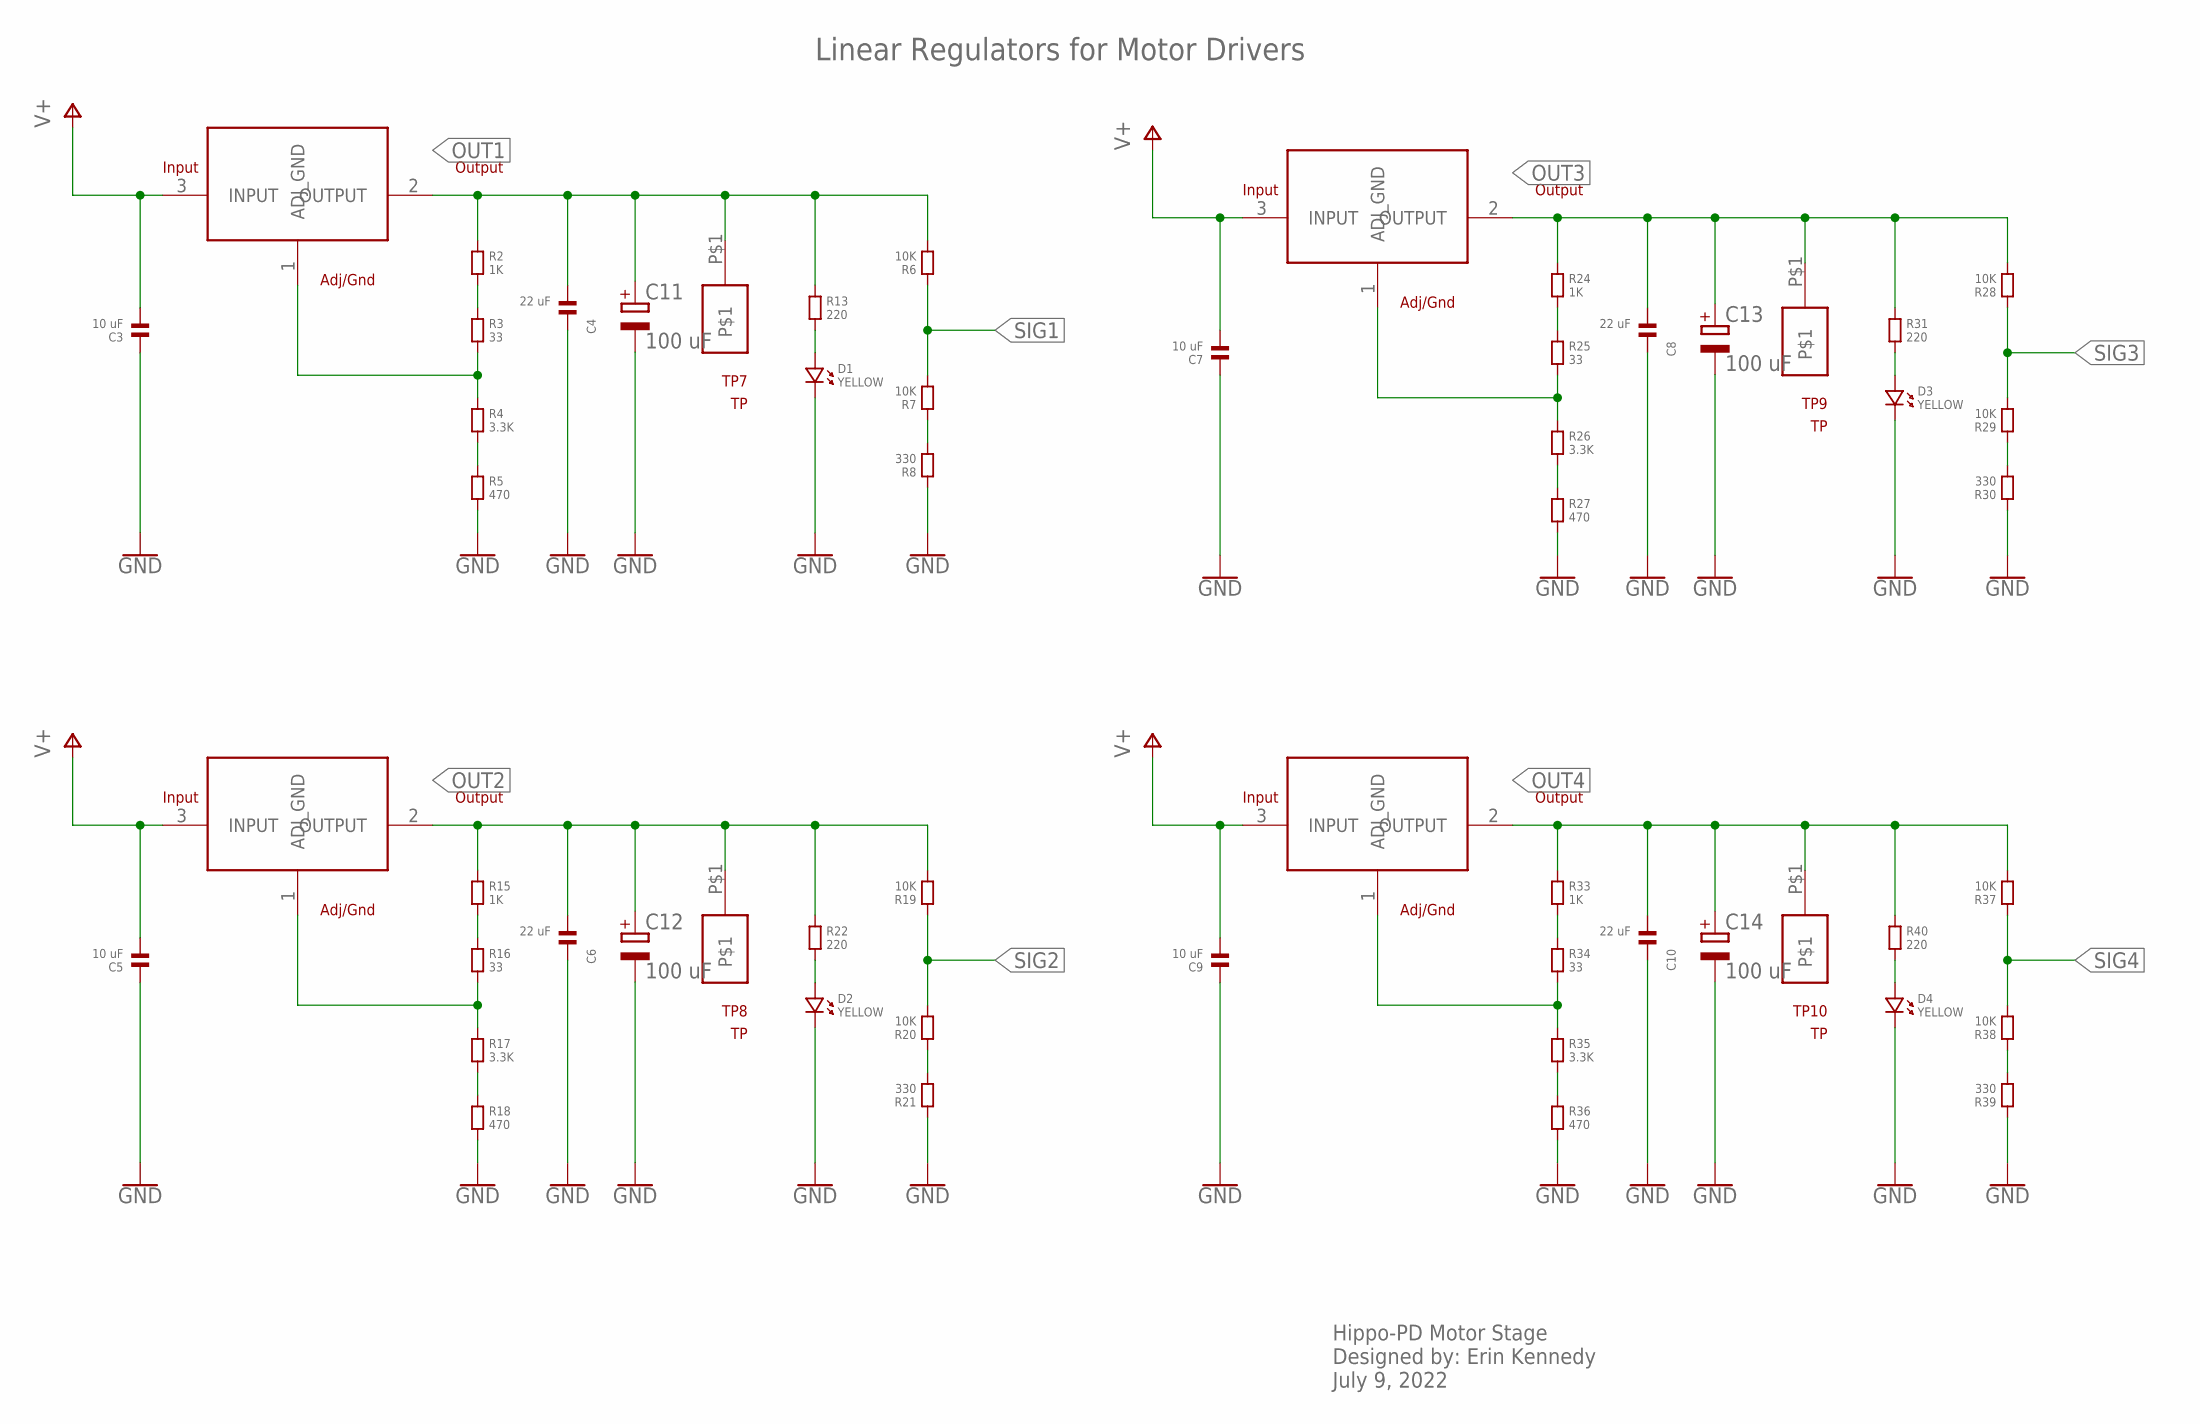
[picture p73: schematic 03_MotorStage_v1.sch, sheet 2]

Parts:
C3, C5, C7, C9: 10 uF; 1206
C4, C6, C8, C10: 22 uF; 1206
C11, C12, C13, C14: 100 uF; ELECTROLYTIC_CAP
D1, D2, D3, D4: YELLOW; 1206.LED
R2, R15, R24, R33: 1K; 1206
R3, R16, R25, R34: 33; 1206
R4, R17, R26, R35: 3.3K; 1206
R5, R18, R27, R36: 470; 1206
R6, R7, R19, R20, R28, R29, R37, R38: 10K; 1206
R8, R21, R30, R39: 330; 1206
R13, R22, R31, R40: 220; 1206
TP7, TP8, TP9, TP10: TP
U2, U3, U4, U5: AZ1084C

Connections:
GND: C3.1, C4.1, C5.1, C6.1, C7.1, C8.1, C9.1, C10.1, C11.-, C12.-, C13.-, C14.-, D1.P$2 (2), D2.P$2 (2), D3.P$2 (2), D4.P$2 (2), R5.2, R8.1, R18.2, R21.1, R27.2, R30.1, R36.2, R39.1; also elsewhere on the board
unnamed: D1.P$1 (1), R13.2
unnamed: R2.2, R3.1
unnamed: R3.2, R4.1, U2.1 (ADJ_GND)
unnamed: R4.2, R5.1
unnamed: D3.P$1 (1), R31.2
unnamed: R7.1, R8.2
unnamed: R24.2, R25.1
unnamed: D2.P$1 (1), R22.2
unnamed: R15.2, R16.1
unnamed: R16.2, R17.1, U3.1 (ADJ_GND)
unnamed: R17.2, R18.1
unnamed: R20.1, R21.2
unnamed: R25.2, R26.1, U4.1 (ADJ_GND)
unnamed: R26.2, R27.1
unnamed: R29.1, R30.2
unnamed: D4.P$1 (1), R40.2
unnamed: R33.2, R34.1
unnamed: R34.2, R35.1, U5.1 (ADJ_GND)
unnamed: R35.2, R36.1
unnamed: R38.1, R39.2
OUT1: C4.2, C11.+, R2.1, R6.2, R13.1, TP7.P$1, U2.2 (OUTPUT); also elsewhere on the board
OUT2: C6.2, C12.+, R15.1, R19.2, R22.1, TP8.P$1, U3.2 (OUTPUT); also elsewhere on the board
OUT3: C8.2, C13.+, R24.1, R28.2, R31.1, TP9.P$1, U4.2 (OUTPUT); also elsewhere on the board
OUT4: C10.2, C14.+, R33.1, R37.2, R40.1, TP10.P$1, U5.2 (OUTPUT); also elsewhere on the board
SIG1: R6.1, R7.2; also elsewhere on the board
SIG2: R19.1, R20.2; also elsewhere on the board
SIG3: R28.1, R29.2; also elsewhere on the board
SIG4: R37.1, R38.2; also elsewhere on the board
V+: C3.2, C5.2, C7.2, C9.2, U2.3 (INPUT), U3.3 (INPUT), U4.3 (INPUT), U5.3 (INPUT); also elsewhere on the board

Notes on the sheet:
Linear Regulators for Motor Drivers
Hippo-PD Motor Stage Designed by: Erin Kennedy July 9, 2022

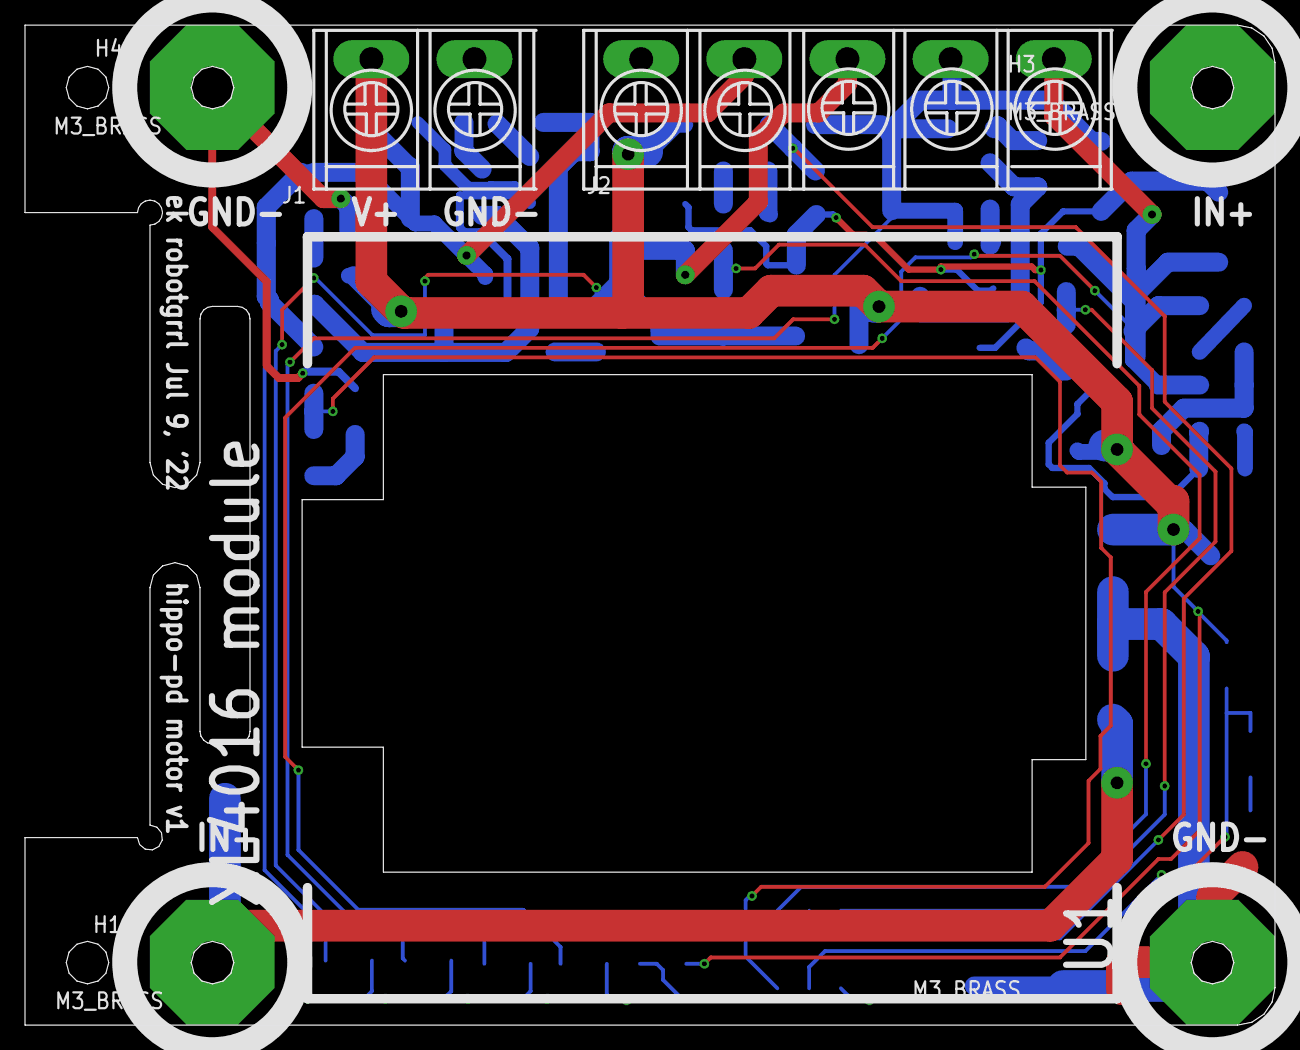
[picture p74: board 03_MotorStage_v1.brd from above]

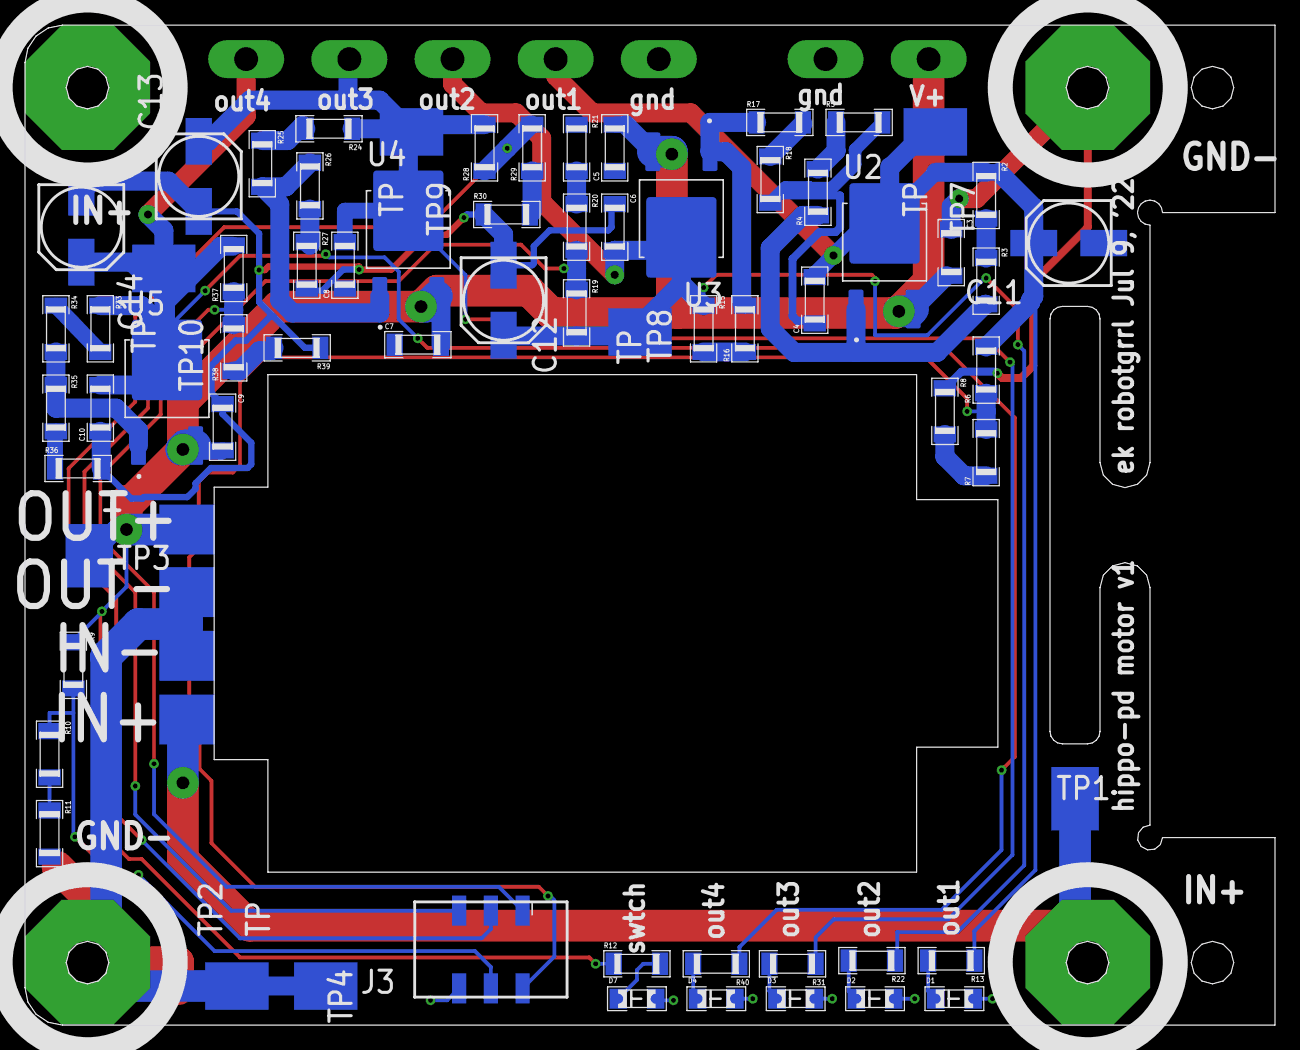
[picture p75: board 03_MotorStage_v1.brd from below]

Board: 2 copper layers, 100.0 x 80.0 mm, 73 parts (66 on the bottom side), 34 nets.
