RobotGrrl/KitePropulsion/Electronics/04_ControllerStage_v1/04_ControllerStage_v1.brd

## EAGLE design Electronics/04_ControllerStage_v1/04_ControllerStage_v1.brd (2022-07-22)

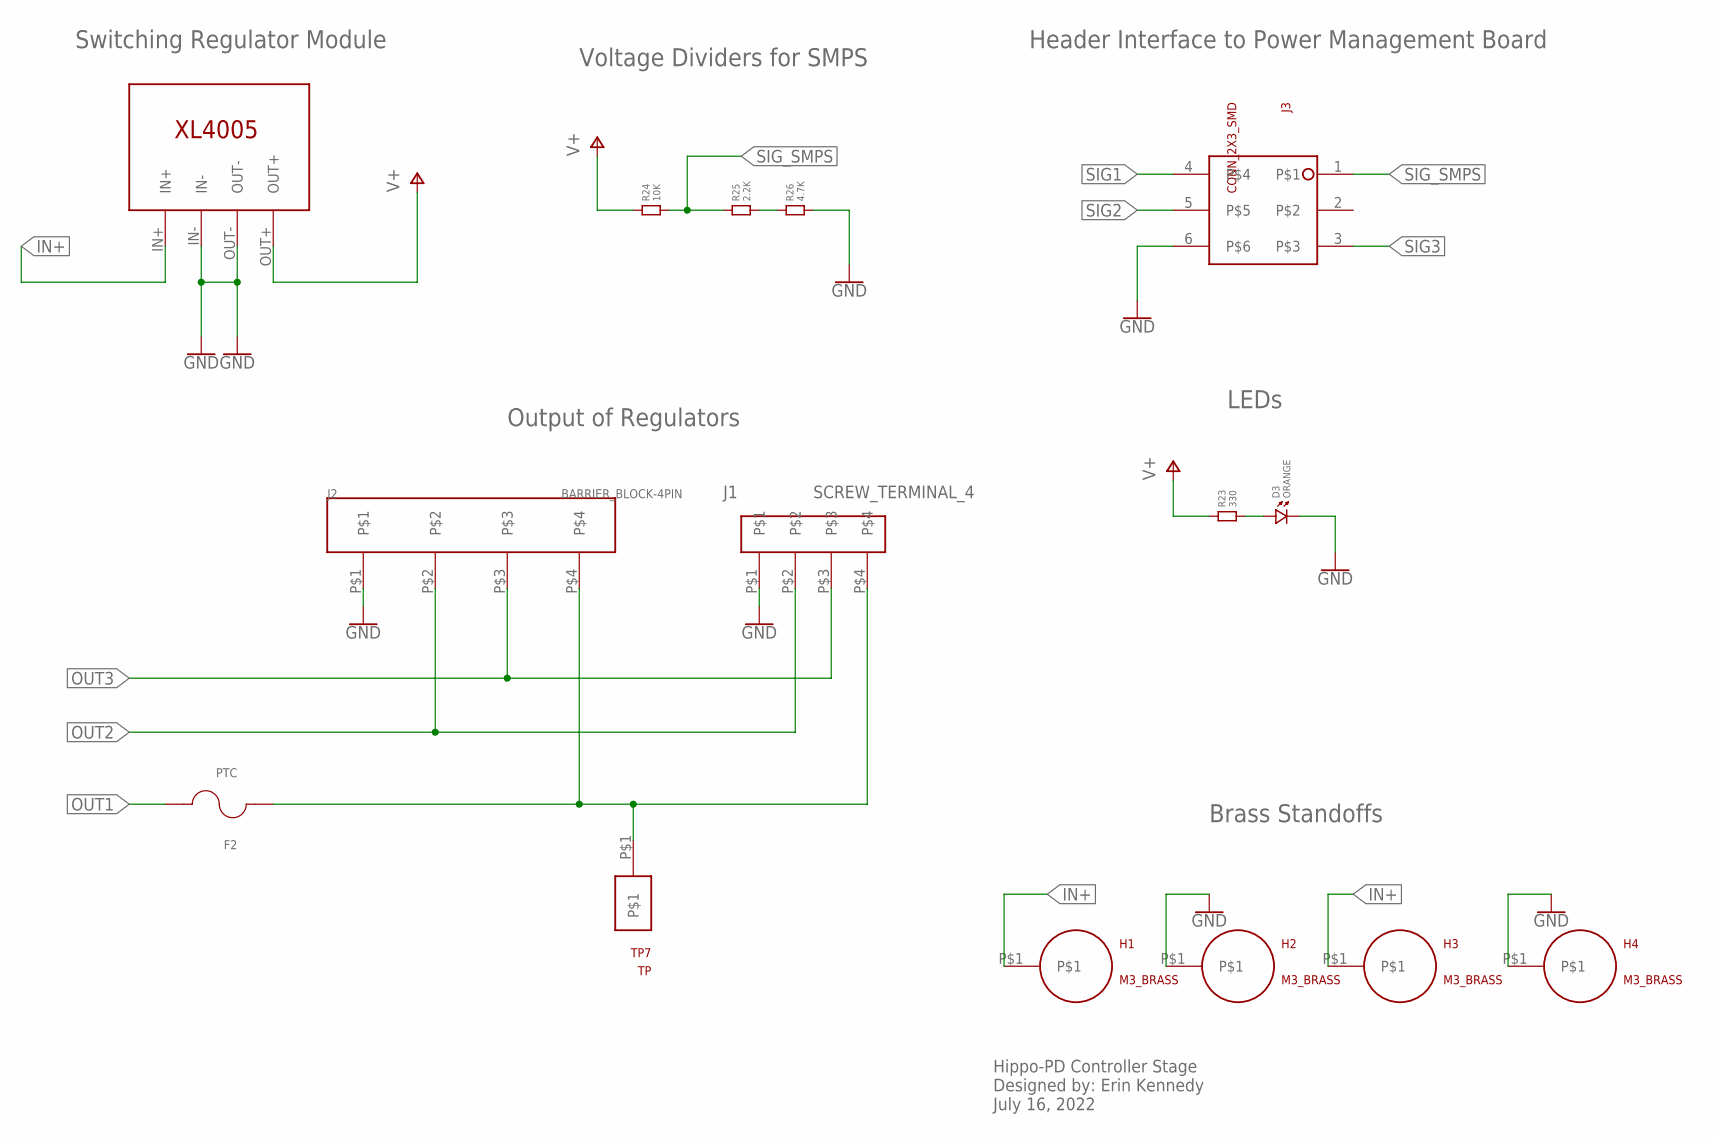
[picture p76: schematic 04_ControllerStage_v1.sch, sheet 1]

Parts:
D3: ORANGE; 1206.LED
F2: PTC
H1, H2, H3, H4: M3_BRASS
J1: SCREW_TERMINAL_4; SCREW_TERM_4
J2: BARRIER_BLOCK-4PIN; BARRIERBLOCK-4PIN
J3: CONN_2X3_SMD; 2X3_SMD_CONNECTOR
R23: 330; 1206
R24: 10K; 1206
R25: 2.2K; 1206
R26: 4.7K; 1206
TP7: TP
U1: XL4005-DEV

Connections:
GND: D3.P$2 (2), H2.P$1, H4.P$1, J1.P$1, J2.P$1, J3.6, R26.2, U1.IN-, U1.OUT-; also elsewhere on the board
IN+: H1.P$1, H3.P$1, U1.IN+; also elsewhere on the board
unnamed: D3.P$1 (1), R23.2
unnamed: R25.2, R26.1
unnamed: F2.1, J1.P$4, J2.P$4, TP7.P$1
OUT1: F2.2; also elsewhere on the board
OUT2: J1.P$2, J2.P$2; also elsewhere on the board
OUT3: J1.P$3, J2.P$3; also elsewhere on the board
SIG1: J3.4; also elsewhere on the board
SIG2: J3.5; also elsewhere on the board
SIG3: J3.3; also elsewhere on the board
SIG_SMPS: J3.1, R24.2, R25.1
V+: R23.1, R24.1, U1.OUT+; also elsewhere on the board

Notes on the sheet:
Switching Regulator Module
Voltage Dividers for SMPS
Header Interface to Power Management Board
Output of Regulators
Brass Standoffs
Hippo-PD Controller Stage Designed by: Erin Kennedy July 16, 2022
LEDs
