RobotGrrl/KitePropulsion/Electronics/04_ControllerStage_v1/04_ControllerStage_v1.brd

## EAGLE design Electronics/04_ControllerStage_v1/04_ControllerStage_v1.brd (continued)

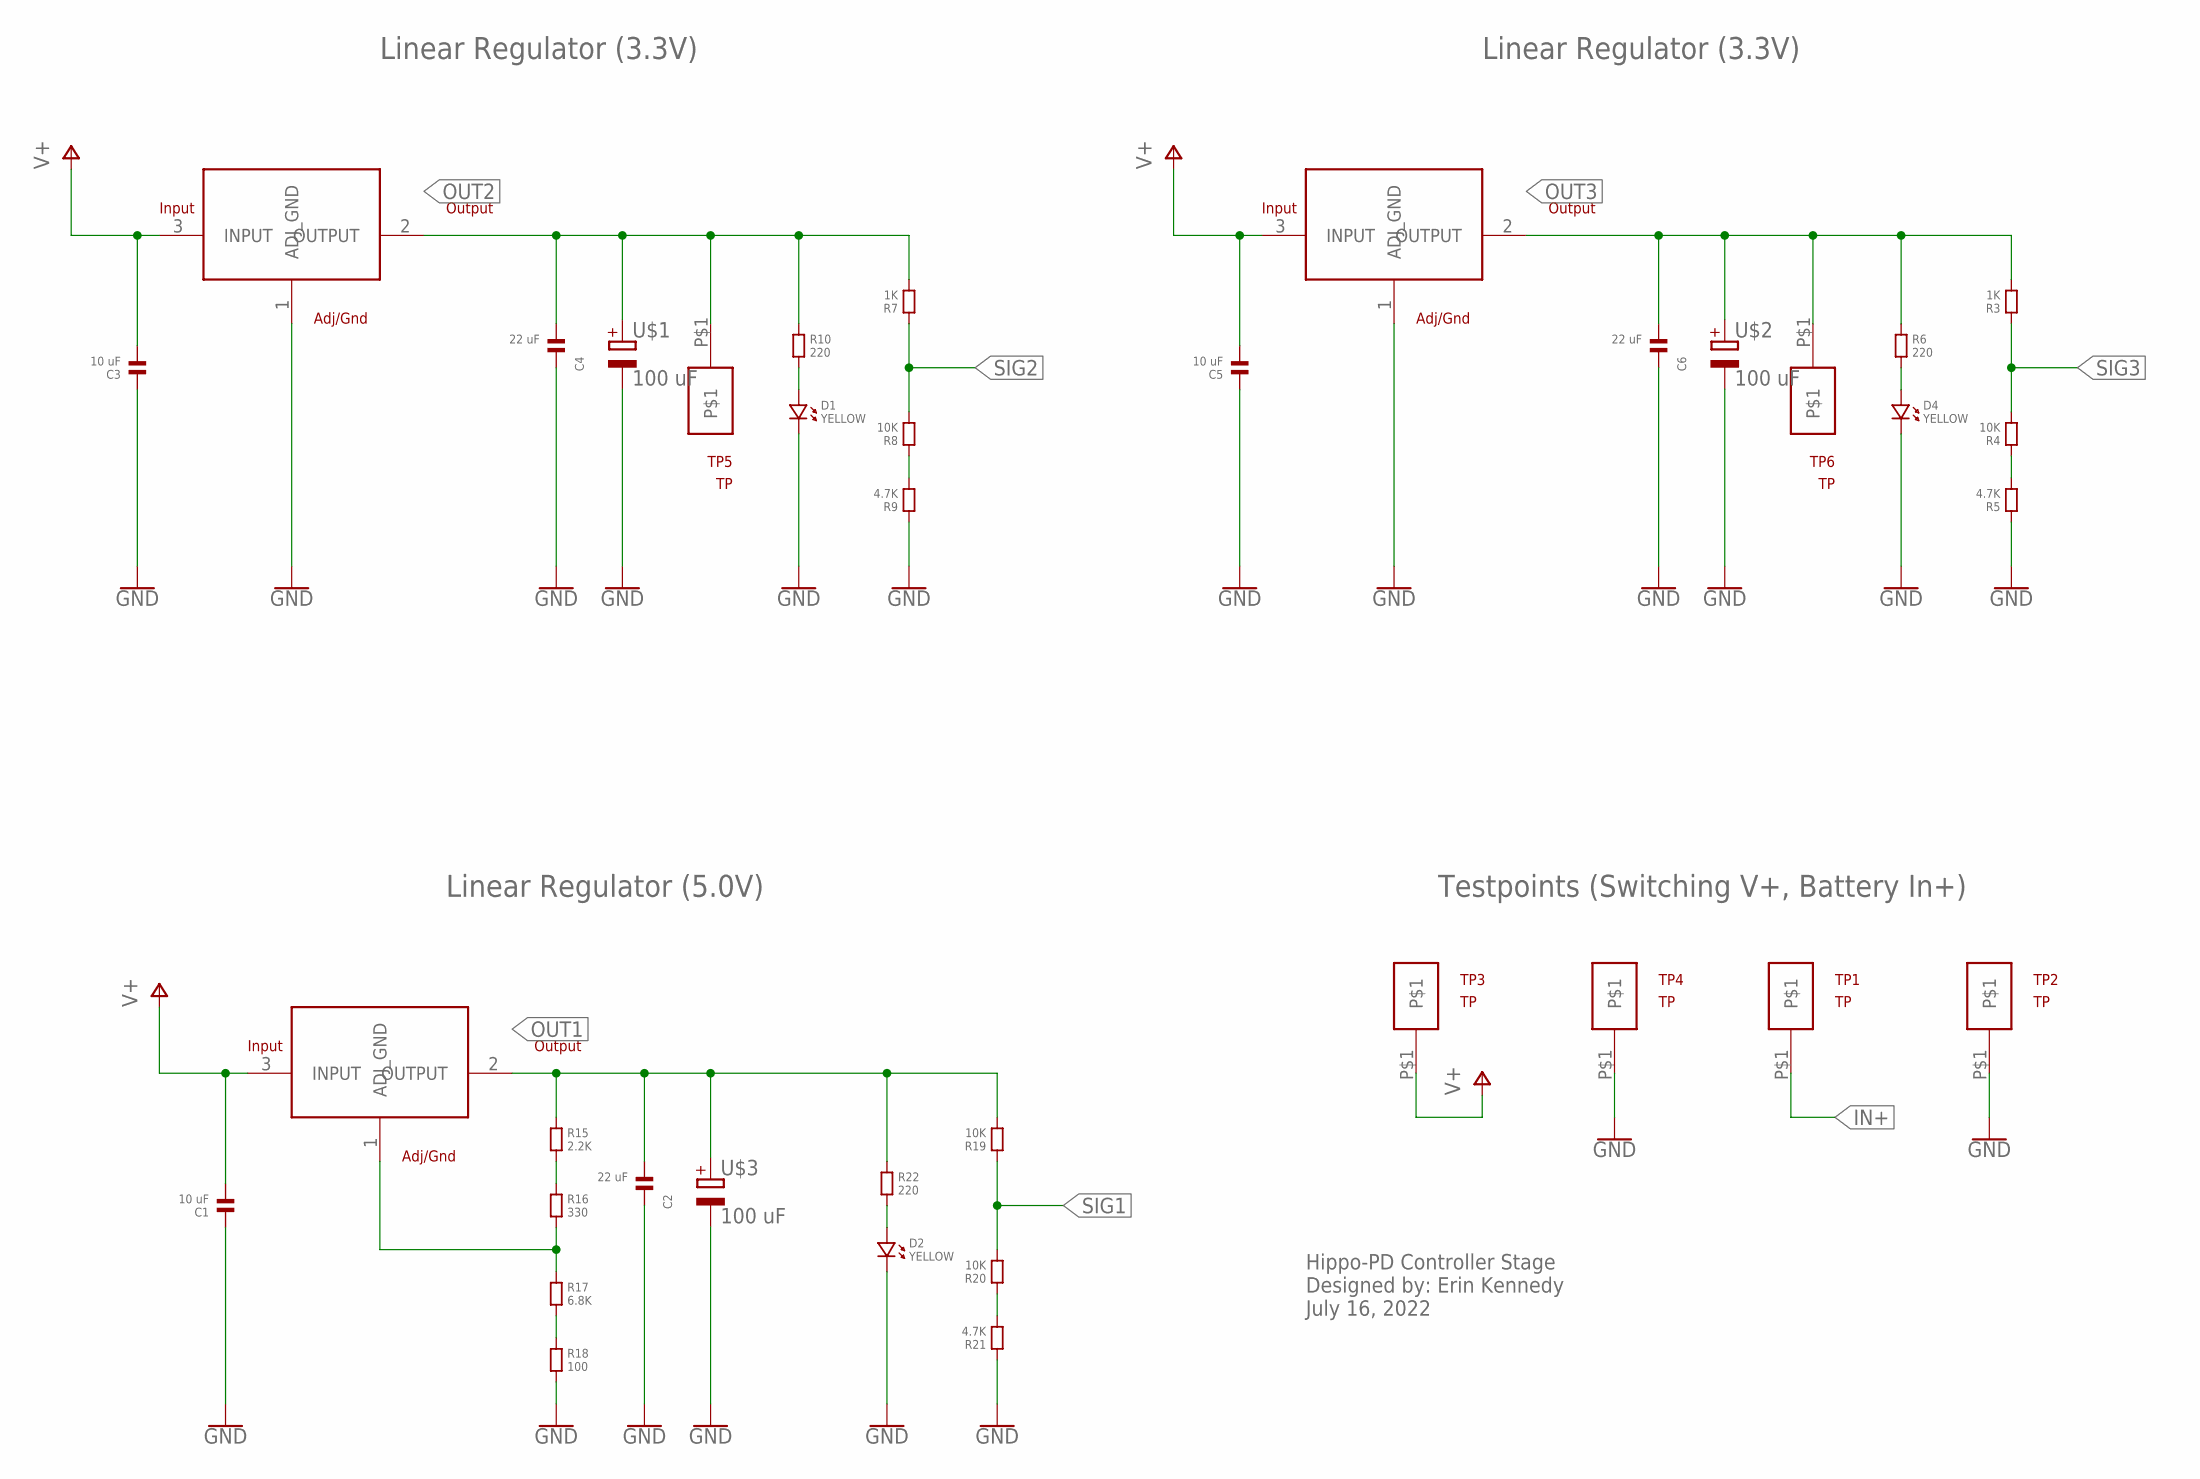
[picture p77: schematic 04_ControllerStage_v1.sch, sheet 2]

Parts:
C1, C3, C5: 10 uF; 1206
C2, C4, C6: 22 uF; 1206
D1, D2, D4: YELLOW; 1206.LED
R1, R2: AZ1117CDAZ1117CD; AZ1117CD
R3, R7: 1K; 1206
R4, R8, R19, R20: 10K; 1206
R5, R9, R21: 4.7K; 1206
R6, R10, R22: 220; 1206
R14: AZ1084C
R15: 2.2K; 1206
R16: 330; 1206
R17: 6.8K; 1206
R18: 100; 1206
TP1, TP2, TP3, TP4, TP5, TP6: TP
U$1, U$2, U$3: 100 uF; ELECTROLYTIC_CAP

Connections:
GND: C1.1, C2.1, C3.1, C4.1, C5.1, C6.1, D1.P$2 (2), D2.P$2 (2), D4.P$2 (2), R1.1 (ADJ_GND), R2.1 (ADJ_GND), R5.1, R9.1, R18.2, R21.1, TP2.P$1, TP4.P$1, U$1.-, U$2.-, U$3.-; also elsewhere on the board
IN+: TP1.P$1; also elsewhere on the board
unnamed: D1.P$1 (1), R10.2
unnamed: D4.P$1 (1), R6.2
unnamed: R4.1, R5.2
unnamed: R8.1, R9.2
unnamed: D2.P$1 (1), R22.2
unnamed: R15.2, R16.1
unnamed: R14.1 (ADJ_GND), R16.2, R17.1
unnamed: R17.2, R18.1
unnamed: R20.1, R21.2
OUT1: C2.2, R14.2 (OUTPUT), R15.1, R19.2, R22.1, U$3.+; also elsewhere on the board
OUT2: C4.2, R1.2 (OUTPUT), R7.2, R10.1, TP5.P$1, U$1.+; also elsewhere on the board
OUT3: C6.2, R2.2 (OUTPUT), R3.2, R6.1, TP6.P$1, U$2.+; also elsewhere on the board
SIG1: R19.1, R20.2; also elsewhere on the board
SIG2: R7.1, R8.2; also elsewhere on the board
SIG3: R3.1, R4.2; also elsewhere on the board
V+: C1.2, C3.2, C5.2, R1.3 (INPUT), R2.3 (INPUT), R14.3 (INPUT), TP3.P$1; also elsewhere on the board

Notes on the sheet:
Linear Regulator (5.0V)
Hippo-PD Controller Stage Designed by: Erin Kennedy July 16, 2022
Testpoints (Switching V+, Battery In+)
Linear Regulator (3.3V)

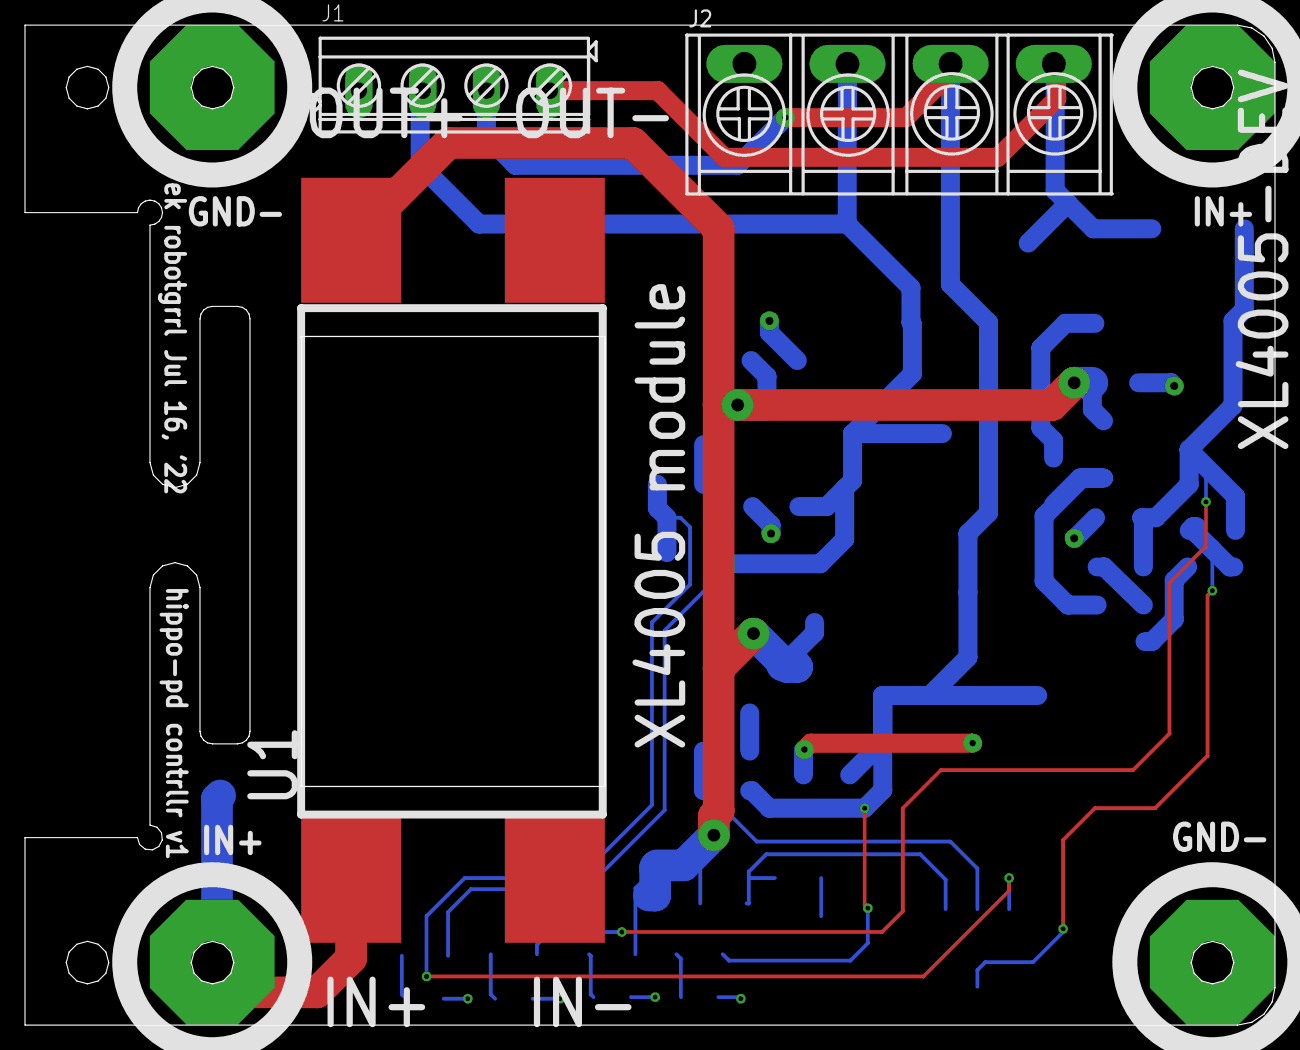
[picture p78: board 04_ControllerStage_v1.brd from above]

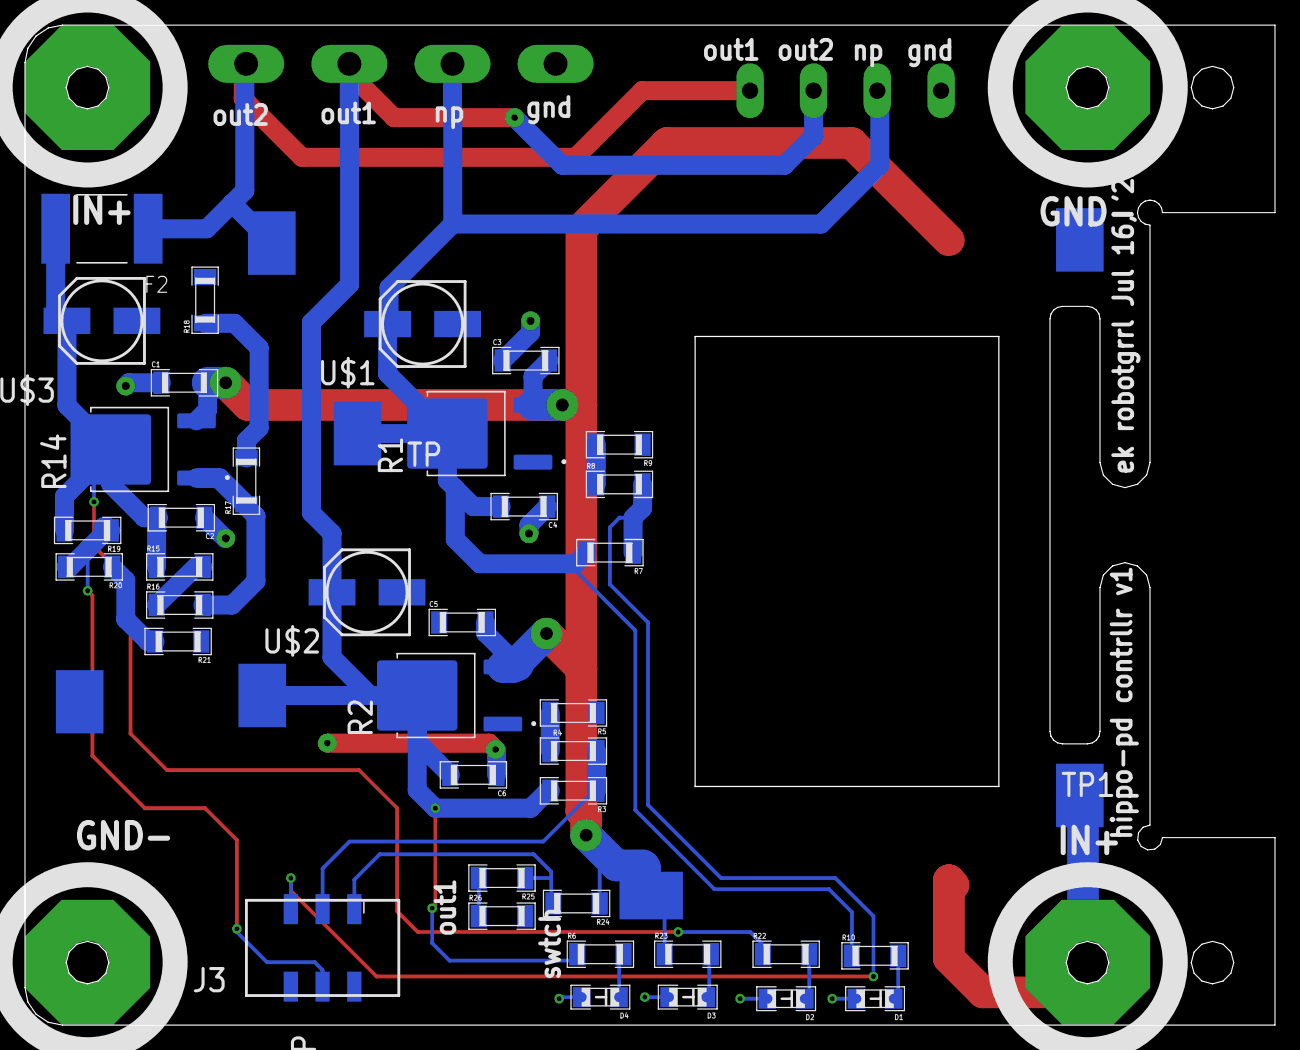
[picture p79: board 04_ControllerStage_v1.brd from below]

Board: 2 copper layers, 100.0 x 80.0 mm, 52 parts (45 on the bottom side), 22 nets.
