RobotGrrl/KitePropulsion/Electronics/01_InputStage_v1/01_InputStage_v1.brd

## EAGLE design Electronics/01_InputStage_v1/01_InputStage_v1.brd (2022-07-22)

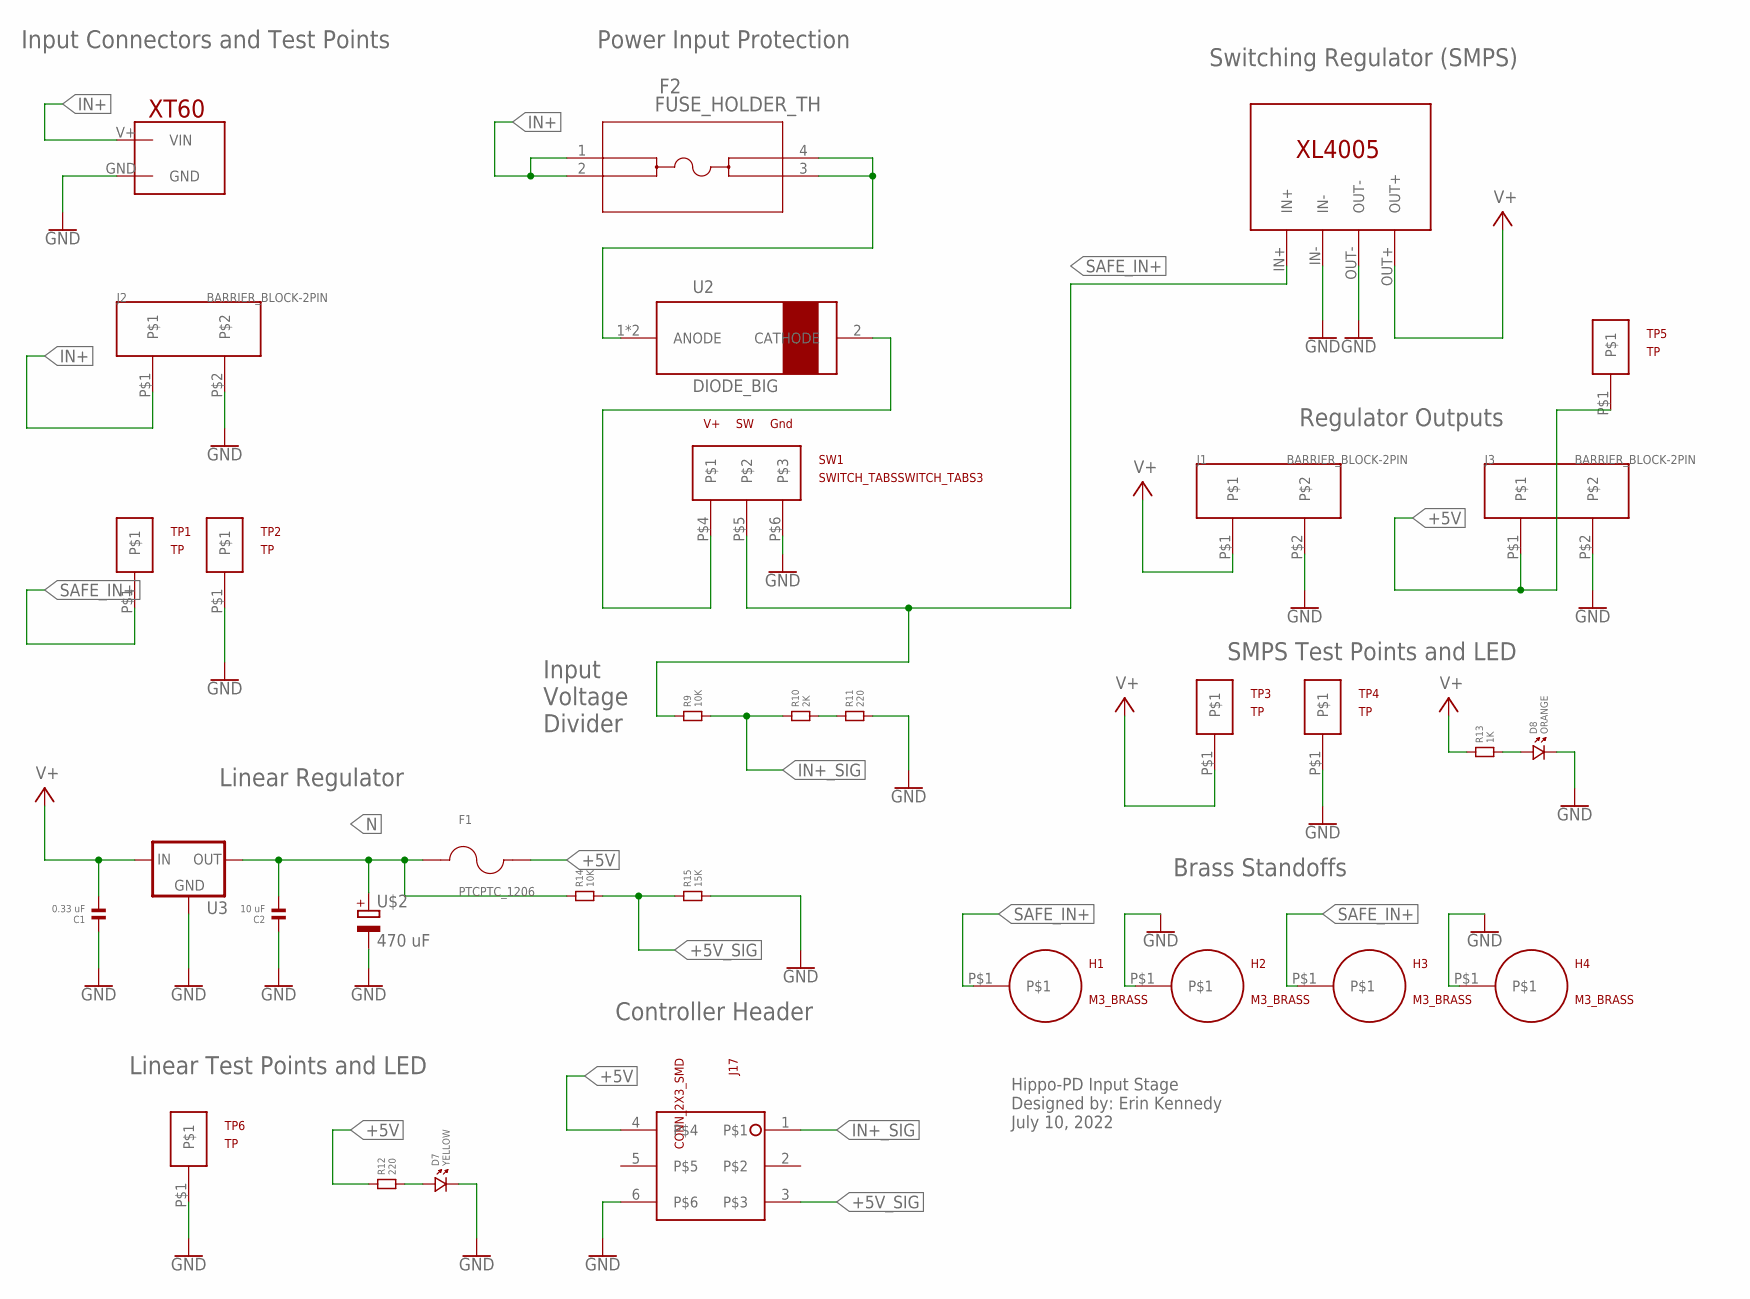
[picture p80: schematic 01_InputStage_v1.sch]

Parts:
C1: 0.33 uF; 1206
C2: 10 uF; 1206
D7: YELLOW; 1206.LED
D8: ORANGE; 1206.LED
F1: PTCPTC_1206; 1206
F2: FUSE_HOLDER_TH
H1, H2, H3, H4: M3_BRASS
J1, J2, J3: BARRIER_BLOCK-2PIN; BARRIERBLOCK-2PIN
J17: CONN_2X3_SMD; 2X3_SMD_CONNECTOR
R9, R14: 10K; 1206
R10: 2K; 1206
R11, R12: 220; 1206
R13: 1K; 1206
R15: 15K; 1206
SW1: SWITCH_TABSSWITCH_TABS3; SWITCH_TABS3
TP1, TP2, TP3, TP4, TP5, TP6: TP
U1: XL4005-DEV
U2: DIODE_BIG
U3: V_REG_78XXSINK; TO220-IGO
U$2: 470 uF; ELECTROLYTIC_CAP
U$5: XT60

Connections:
+5V: F1.2, J3.P$1, J17.4, R12.1, TP5.P$1
+5V_SIG: J17.3, R14.2, R15.1
GND: C1.1, C2.1, D7.P$2 (2), D8.P$2 (2), H2.P$1, H4.P$1, J1.P$2, J2.P$2, J3.P$2, J17.6, R11.2, R15.2, SW1.P$6, TP2.P$1, TP4.P$1, TP6.P$1, U1.IN-, U1.OUT-, U3.GND, U$2.-, U$5.GND
IN+: F2.1, F2.2, J2.P$1, U$5.V+ (VIN)
IN+_SIG: J17.1, R9.2, R10.1
N: C2.2, F1.1, R14.1, U3.OUT, U$2.+
unnamed: F2.3, F2.4, U2.1 (ANODE), U2.3 (ANODE)
unnamed: SW1.P$4, U2.2 (CATHODE)
unnamed: R10.2, R11.1
unnamed: D8.P$1 (1), R13.2
unnamed: D7.P$1 (1), R12.2
SAFE_IN+: H1.P$1, H3.P$1, R9.1, SW1.P$5, TP1.P$1, U1.IN+
V+: C1.2, J1.P$1, R13.1, TP3.P$1, U1.OUT+, U3.IN

Notes on the sheet:
Hippo-PD Input Stage Designed by: Erin Kennedy July 10, 2022
Brass Standoffs
Regulator Outputs
SMPS Test Points and LED
Switching Regulator (SMPS)
Power Input Protection
Input Voltage Divider
Linear Regulator
Controller Header
Linear Test Points and LED
Input Connectors and Test Points

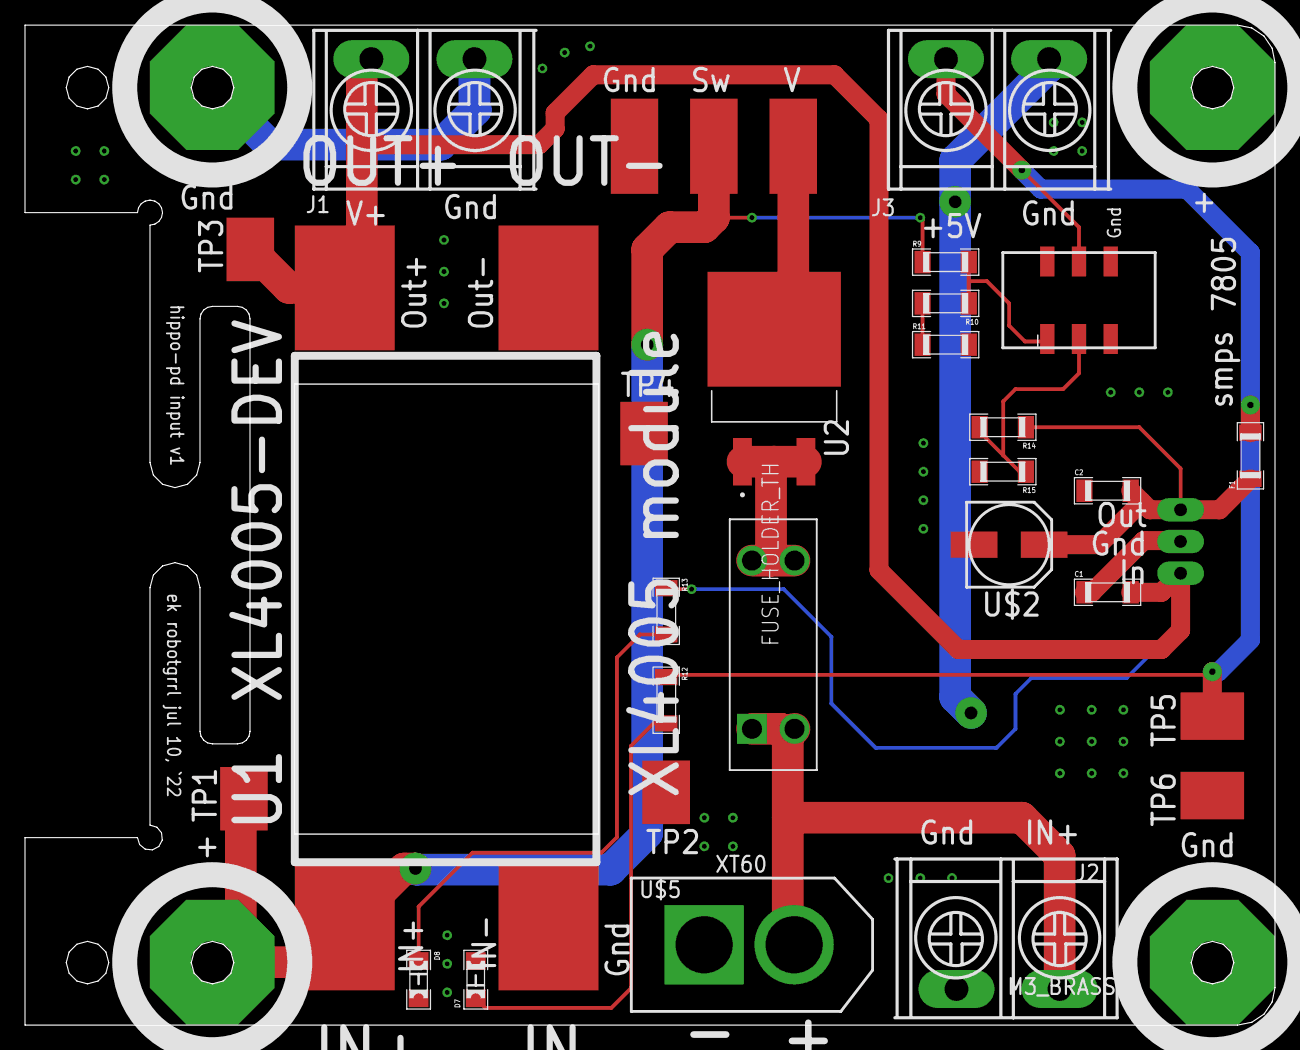
[picture p81: board 01_InputStage_v1.brd from above]

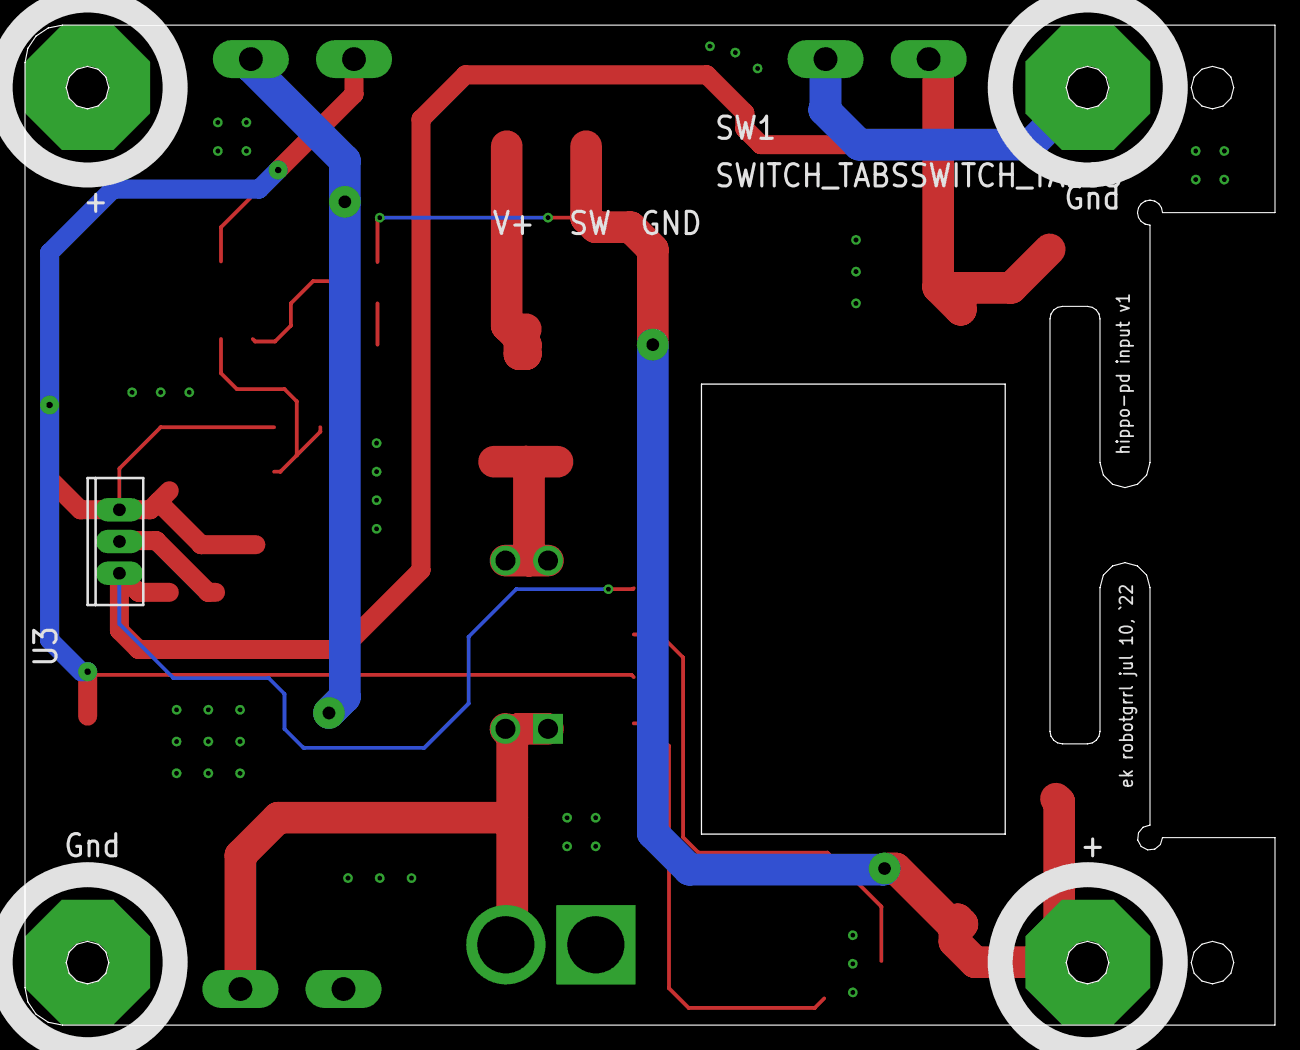
[picture p82: board 01_InputStage_v1.brd from below]

Board: 2 copper layers, 100.0 x 80.0 mm, 33 parts (2 on the bottom side), 13 nets.
