RobotGrrl/KitePropulsion/Electronics/99_Sleds_v1/Sled_Terminals_v1.brd

## EAGLE design Electronics/99_Sleds_v1/Sled_Terminals_v1.brd (2022-07-22)

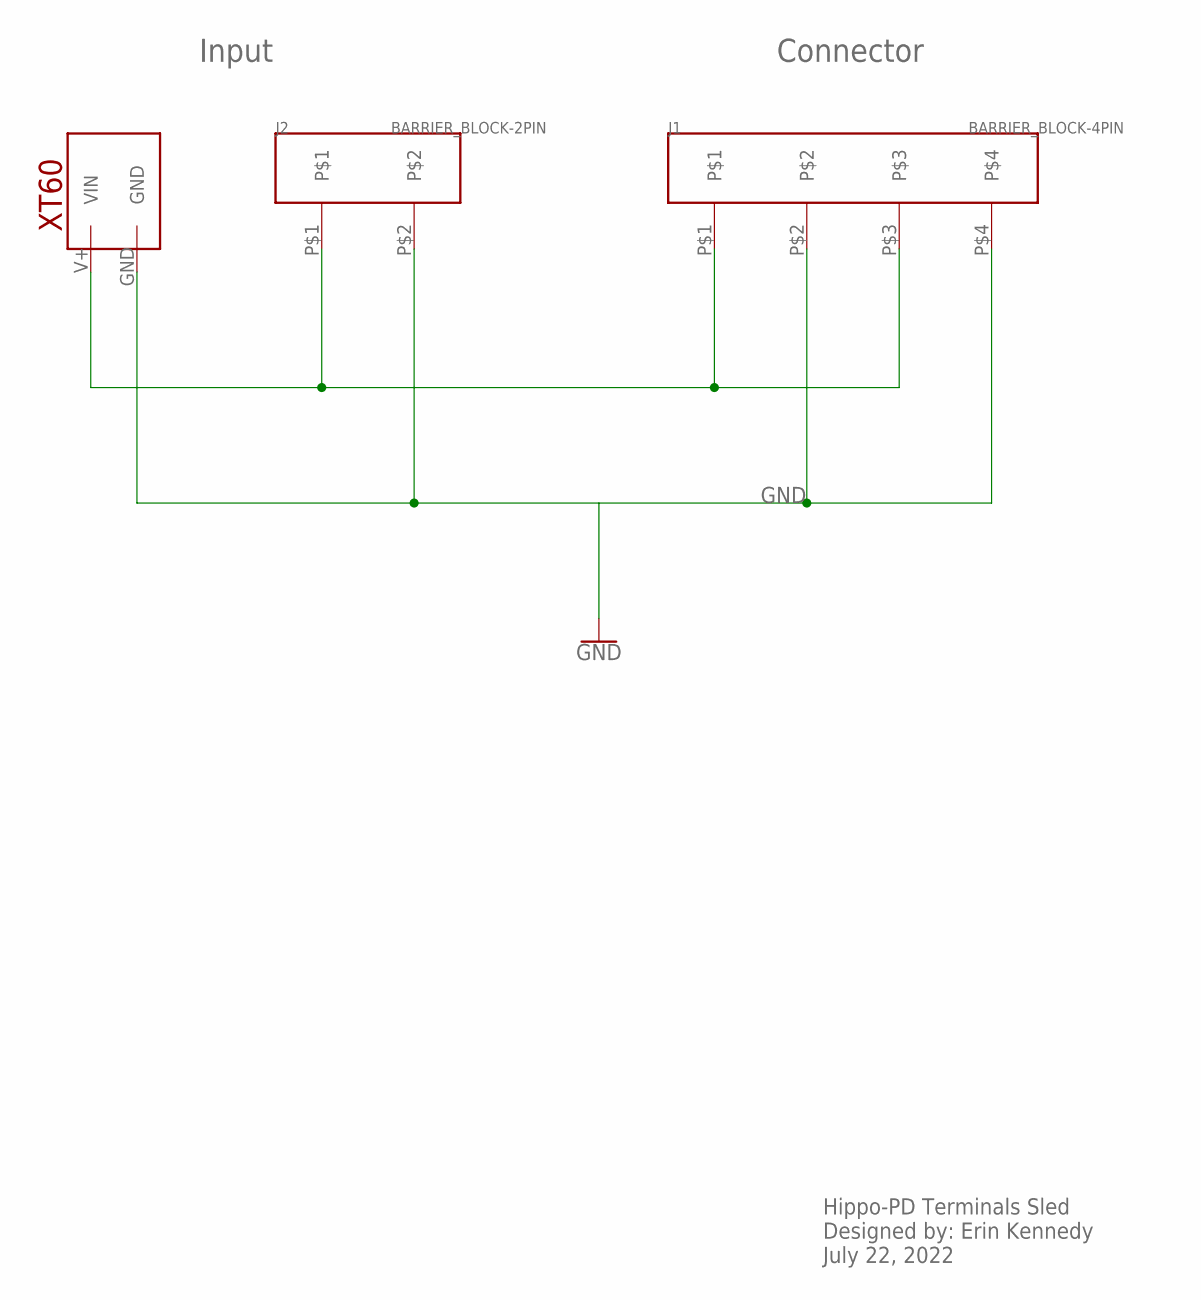
[picture p83: schematic Sled_Terminals_v1.sch]

Parts:
J1: BARRIER_BLOCK-4PIN; BARRIERBLOCK-4PIN
J2: BARRIER_BLOCK-2PIN; BARRIERBLOCK-2PIN
U$1: XT60

Connections:
GND: J1.P$2, J1.P$4, J2.P$2, U$1.GND
unnamed: J1.P$1, J1.P$3, J2.P$1, U$1.V+ (VIN)

Notes on the sheet:
Hippo-PD Terminals Sled Designed by: Erin Kennedy July 22, 2022
Connector
Input

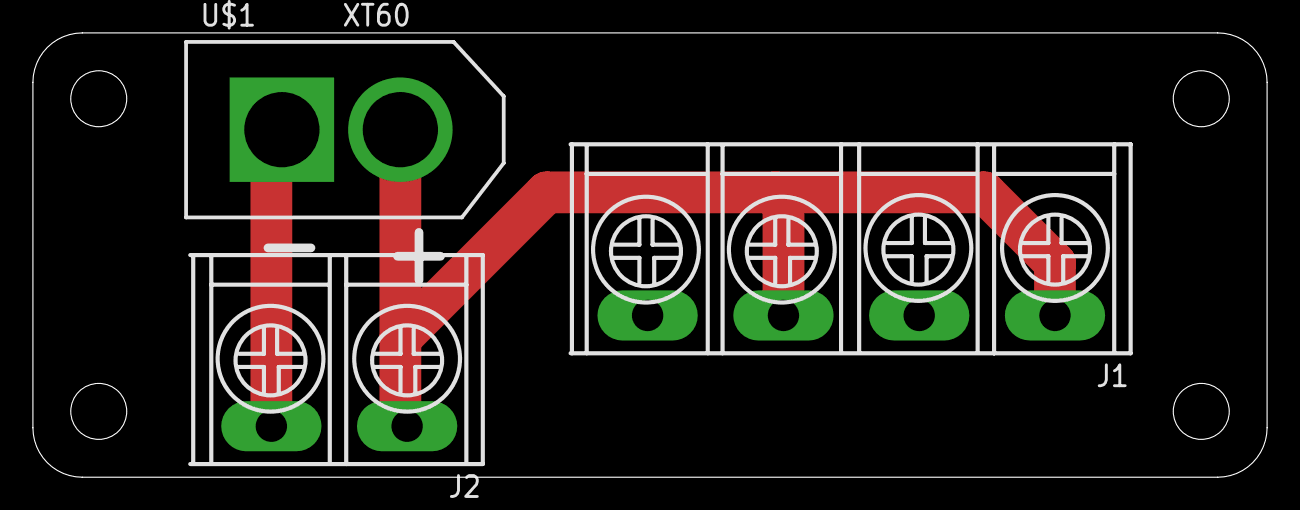
[picture p84: board Sled_Terminals_v1.brd from above]

Board: 2 copper layers, 75.0 x 27.0 mm, 3 parts (0 on the bottom side), 2 nets.
