RobotGrrl/KitePropulsion/Firmware/KiteToF_F3/Core/Src/main.c

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
/* Includes ------------------------------------------------------------------*/
#include "main.h"

/* USER CODE BEGIN Includes */
#include "vl53l0x_api.h"
/* USER CODE END Includes */

/* USER CODE BEGIN PD */
#define ERR_DETECT             -1
/* USER CODE END PD */

 I2C_HandleTypeDef hi2c2;

/* USER CODE BEGIN PV */

/**
 * Global ranging struct
 */
VL53L0X_RangingMeasurementData_t RangingMeasurementData;

/** leaky factor for filtered range
 *
 * r(n) = averaged_r(n-1)*leaky +r(n)(1-leaky)
 *
 * */
int LeakyFactorFix8 = (int)( 0.6 *256);

/** How many device detect set by @a DetectSensors()*/
int nDevPresent=0;

/** bit is index in VL53L0XDevs that is not necessary the dev id of the BSP */
int nDevMask;
// EK ^ that is probably not needed after removing the for loop completely

VL53L0X_Dev_t VL53L0XDev = {
		.Id=0,
		.DevLetter='e',
		.I2cHandle=&hi2c2, // TODO: I2C_HandleTypeDef
		.I2cDevAddr=0x29 // EK: documentation says address is 0x29, why did the code say 0x52?
};

int range;
int range_mm;
/* USER CODE END PV */

void SystemClock_Config(void);
static void MX_GPIO_Init(void);
static void MX_I2C2_Init(void);
/* USER CODE BEGIN PFP */

void ResetAndDetectSensor(int SetDisplay); // TODO: add this function

/* USER CODE END PFP */

/* USER CODE BEGIN 0 */

/**
 * Handle Error
 *
 * Set err on display and loop forever
 * @param err Error case code
 */
void HandleError(int err){
    char msg[16];
    sprintf(msg,"Er%d", err);
    while(1){};
}

/**
 * Reset all sensor then do presence detection
 *
 * All present devices are data initiated and assigned to their final I2C address
 * @return
 */
int DetectSensors(int SetDisplay) {
    int i;
    uint16_t Id;
    int status;
    int FinalAddress;

    // EK unused char PresentMsg[5]="    ";
    /* Reset all */
    nDevPresent = 0;

    // EK: commenting this out, unclear if it's needed w/o an i2c expander
    /*
    for (i = 0; i < 3; i++)
        status = XNUCLEO53L0A1_ResetId(i, 0);
    */
    // EK: this function is in the HAL for that nucleo board
    // why would it be located there if it is for the sensor?
    // what is that code doing - something about an expander? why?

    /* detect all sensors (even on-board)*/
    // EK no need for for loop for (i = 0; i < 3; i++) {

    i = 0; // EK: in case anything is out there using i

    		VL53L0X_Dev_t *pDev;
        pDev = &VL53L0XDev; // EK: only using one //&VL53L0XDevs[i];
        pDev->I2cDevAddr = 0x29; // EK: documentation says address is 0x29, why did the code say 0x52? //0x52;
        pDev->Present = 0;
        status = 1; // EK: is this needed? XNUCLEO53L0A1_ResetId( pDev->Id, 1);
        HAL_Delay(2); // EK: why is this here
        FinalAddress= 0x29; // EK: see comment a few lines above about address // 0x52+(i+1)*2;

        do {
        	/* Set I2C standard mode (400 KHz) before doing the first register access */
        	// EK: why is this, just do it  if (status == VL53L0X_ERROR_NONE)
        	// EK let's not do this status = VL53L0X_WrByte(pDev, 0x88, 0x00);

        	/* Try to read one register using default 0x52 address */
            status = VL53L0X_RdWord(pDev, VL53L0X_REG_IDENTIFICATION_MODEL_ID, &Id);
            if (status) {
                printf("#%d Read id fail\n", i);
                break;
            }
            if (Id == 0xEEAA) {
				/* Sensor is found => Change its I2C address to final one */
                status = VL53L0X_SetDeviceAddress(pDev,FinalAddress);
                if (status != 0) {
                    printf("#%d VL53L0X_SetDeviceAddress fail\n", i);
                    break;
                }
                pDev->I2cDevAddr = FinalAddress;
                /* Check all is OK with the new I2C address and initialize the sensor */
                status = VL53L0X_RdWord(pDev, VL53L0X_REG_IDENTIFICATION_MODEL_ID, &Id);
                if (status != 0) {
					printf("#%d VL53L0X_RdWord fail\n", i);
					break;
				}

                status = VL53L0X_DataInit(pDev);
                if( status == 0 ){
                    pDev->Present = 1;
                }
                else{
                    printf("VL53L0X_DataInit %d fail\n", i);
                    break;
                }
                printf("VL53L0X %d Present and initiated to final 0x%x\n", pDev->Id, pDev->I2cDevAddr);
                nDevPresent++;
                nDevMask |= 1 << i;
                pDev->Present = 1;
            }
            else {
                printf("#%d unknown ID %x\n", i, Id);
                status = 1;
            }
        } while (0);
        /* if fail r can't use for any reason then put the  device back to reset */
        if (status) {
        	  printf("something failed"); // EK
            // EK why is this needed XNUCLEO53L0A1_ResetId(i, 0);
        }

    // EK no need for for loop }

    // EK: not needed
    /* Display detected sensor(s) */
    /*
    if( SetDisplay ){
        for(i=0; i<3; i++){
            if( VL53L0XDevs[i].Present ){
                PresentMsg[i+1]=VL53L0XDevs[i].DevLetter;
            }
        }
        PresentMsg[0]=' ';
        XNUCLEO53L0A1_SetDisplayString(PresentMsg);
        HAL_Delay(1000);
    }
    */

    return nDevPresent;
}

void ResetAndDetectSensor(int SetDisplay){
    int nSensor;
    nSensor = DetectSensors(SetDisplay);

    // EK added this
    if( VL53L0XDev.Present==0 )
    {
    	HandleError(ERR_DETECT);
    }

    /* at least one sensor and if one it must be the built-in one  */
    if( (nSensor <=0) ) { // EK ||  (nSensor ==1 && VL53L0XDevs[1].Present==0) ){
        HandleError(ERR_DETECT);
    }
}

VL53L0X_Error WaitStopCompleted(VL53L0X_DEV Dev) {
    VL53L0X_Error Status = VL53L0X_ERROR_NONE;
    uint32_t StopCompleted=0;
    uint32_t LoopNb;

    // Wait until it finished
    // use timeout to avoid deadlock
    if (Status == VL53L0X_ERROR_NONE) {
        LoopNb = 0;
        do {
            Status = VL53L0X_GetStopCompletedStatus(Dev, &StopCompleted);
            if ((StopCompleted == 0x00) || Status != VL53L0X_ERROR_NONE) {
                break;
            }
            LoopNb = LoopNb + 1;
            VL53L0X_PollingDelay(Dev);
        } while (LoopNb < VL53L0X_DEFAULT_MAX_LOOP);

        if (LoopNb >= VL53L0X_DEFAULT_MAX_LOOP) {
            Status = VL53L0X_ERROR_TIME_OUT;
        }

    }

    return Status;
}

/* USER CODE END 0 */

/**
  * @brief  The application entry point.
  * @retval int
  */
int main(void)
{
  /* MCU Configuration--------------------------------------------------------*/

  /* Reset of all peripherals, Initializes the Flash interface and the Systick. */
  HAL_Init();

  /* Configure the system clock */
  SystemClock_Config();

  /* Initialize all configured peripherals */
  MX_GPIO_Init();
  MX_I2C2_Init();
  /* USER CODE BEGIN 2 */


  //ResetAndDetectSensor(1); // EK TODO: the parameter SetDisplay doesn't matter

  // EK test1
  HAL_StatusTypeDef status;
	uint8_t pData;
	status = HAL_I2C_Mem_Read(&hi2c2, 0x52, 0xC0, 1, &pData, 1, HAL_TIMEOUT);
	// pData should be 0xEE
	if(status == HAL_OK) {
		printf("good");
	}
	//--

  // EK test2
  VL53L0X_Dev_t *pDev;
	pDev = &VL53L0XDev;
	pDev->I2cDevAddr = 0x52;
	pDev->Present = 0;

  int status2 = VL53L0X_DataInit(pDev);
	if( status2 == 0 ){
			pDev->Present = 1;
	}
	else{
			printf("VL53L0X_DataInit fail\n");
	}
	printf("VL53L0X %d Present and initiated to final 0x%x\n", pDev->Id, pDev->I2cDevAddr);
	pDev->Present = 1;
	//--

	// EK test3
	uint8_t VhvSettings;
	uint8_t PhaseCal;
	uint32_t refSpadCount;
	uint8_t isApertureSpads;
	VL53L0X_RangingMeasurementData_t RangingMeasurementData;
	//int range;

	// Initialize the device in continuous ranging mode
	VL53L0X_StaticInit(pDev);
	VL53L0X_PerformRefCalibration(pDev, &VhvSettings, &PhaseCal);
	VL53L0X_PerformRefSpadManagement(pDev, &refSpadCount, &isApertureSpads);
	//VL53L0X_SetInterMeasurementPeriodMilliSeconds(pDev, 250); // Program continuous mode Inter-Measurement period in milliseconds
	//VL53L0X_SetDeviceMode(pDev, VL53L0X_DEVICEMODE_CONTINUOUS_RANGING);
	VL53L0X_SetInterMeasurementPeriodMilliSeconds(pDev, 100);
	VL53L0X_SetDeviceMode(pDev, VL53L0X_DEVICEMODE_CONTINUOUS_TIMED_RANGING);

	// Start continuous ranging
	VL53L0X_StartMeasurement(pDev);

	/*
	for(uint8_t i=0; i<5; i++) {
		VL53L0X_GetRangingMeasurementData(pDev, &RangingMeasurementData);
		range = (int)RangingMeasurementData.RangeMilliMeter/10;
		HAL_Delay(100);
	}

	// Stop continuous ranging
	VL53L0X_StopMeasurement(pDev);

	// Ensure device is ready for other commands
	WaitStopCompleted(pDev);
	*/
	//--



  /* USER CODE END 2 */

  /* Infinite loop */
  /* USER CODE BEGIN WHILE */
  while (1)
  {

  	VL53L0X_GetRangingMeasurementData(pDev, &RangingMeasurementData);
		range = (int)RangingMeasurementData.RangeMilliMeter/10; // cm
		range_mm = (int)RangingMeasurementData.RangeMilliMeter; // mm
		//HAL_Delay(1000);

    /* USER CODE END WHILE */

    /* USER CODE BEGIN 3 */
  }
  /* USER CODE END 3 */
}

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
