RobotGrrl/KitePropulsion/KiteControl/Core/Src/main.c

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
/* Includes ------------------------------------------------------------------*/
#include "main.h"

/* USER CODE BEGIN Includes */
#include "input_buf.h"
#include "console.h"
#include <stdbool.h>
#include "../../Drivers/BSP/STM32F3-Discovery/stm32f3_discovery.h"
#include "actuator.h"
#include "pin.h"
/* USER CODE END Includes */

 I2C_HandleTypeDef hi2c1;

SPI_HandleTypeDef hspi1;

TIM_HandleTypeDef htim2;

UART_HandleTypeDef huart4;

PCD_HandleTypeDef hpcd_USB_FS;

/* USER CODE BEGIN PV */
uint8_t uart_byte_buf[1];
input_buf uart_buf;
bool blink_leds = false;

volatile uint8_t step_a = 0;

Actuator yaw;

/* USER CODE END PV */

void SystemClock_Config(void);
static void MX_GPIO_Init(void);
static void MX_I2C1_Init(void);
static void MX_SPI1_Init(void);
static void MX_USB_PCD_Init(void);
static void MX_UART4_Init(void);
static void MX_TIM2_Init(void);
/* USER CODE BEGIN PFP */
void setupActuators(void);
void pinGo(Pin *p);
/* USER CODE END PFP */

/* USER CODE BEGIN 0 */
void HAL_UART_RxCpltCallback(UART_HandleTypeDef *huart) {
	input_buf_add(&uart_buf, uart_byte_buf[0]);
	HAL_UART_Receive_IT(&huart4, uart_byte_buf, 1);
}

void HAL_TIM_PeriodElapsedCallback(TIM_HandleTypeDef *htim) {

	// check which timer triggered this callback

	/*
	if(htim == yaw.htim) { // TODO: does this work?

		if(0 == yaw.step_count) {
			yaw.pin1->state = true;
			yaw.pin2->state = true;
			yaw.pin3->state = false;
			yaw.pin4->state = false;
		} else if(1 == yaw.step_count) {
			yaw.pin1->state = false;
			yaw.pin2->state = true;
			yaw.pin3->state = true;
			yaw.pin4->state = false;
		} else if(2 == yaw.step_count) {
			yaw.pin1->state = false;
			yaw.pin2->state = false;
			yaw.pin3->state = true;
			yaw.pin4->state = true;
		} else if(3 == yaw.step_count) {
			yaw.pin1->state = true;
			yaw.pin2->state = false;
			yaw.pin3->state = false;
			yaw.pin4->state = true;
		}

		pinGo(yaw.pin1); // TODO: does this work?
		pinGo(yaw.pin2);
		pinGo(yaw.pin3);
		pinGo(yaw.pin4);

		yaw.step_count++;
		if(yaw.step_count > 4) yaw.step_count = 0;
	}
	*/


	if(htim == &htim2) { // stepper A

		if(step_a == 0) {
			HAL_GPIO_WritePin(STEP_A1_GPIO_Port, STEP_A1_Pin, GPIO_PIN_SET);
			HAL_GPIO_WritePin(STEP_A2_GPIO_Port, STEP_A2_Pin, GPIO_PIN_SET);
			HAL_GPIO_WritePin(STEP_A3_GPIO_Port, STEP_A3_Pin, GPIO_PIN_RESET);
			HAL_GPIO_WritePin(STEP_A4_GPIO_Port, STEP_A4_Pin, GPIO_PIN_RESET);
		} else if(step_a == 1) {
			HAL_GPIO_WritePin(STEP_A1_GPIO_Port, STEP_A1_Pin, GPIO_PIN_RESET);
			HAL_GPIO_WritePin(STEP_A2_GPIO_Port, STEP_A2_Pin, GPIO_PIN_SET);
			HAL_GPIO_WritePin(STEP_A3_GPIO_Port, STEP_A3_Pin, GPIO_PIN_SET);
			HAL_GPIO_WritePin(STEP_A4_GPIO_Port, STEP_A4_Pin, GPIO_PIN_RESET);
		} else if(step_a == 2) {
			HAL_GPIO_WritePin(STEP_A1_GPIO_Port, STEP_A1_Pin, GPIO_PIN_RESET);
			HAL_GPIO_WritePin(STEP_A2_GPIO_Port, STEP_A2_Pin, GPIO_PIN_RESET);
			HAL_GPIO_WritePin(STEP_A3_GPIO_Port, STEP_A3_Pin, GPIO_PIN_SET);
			HAL_GPIO_WritePin(STEP_A4_GPIO_Port, STEP_A4_Pin, GPIO_PIN_SET);
		} else if(step_a == 3) {
			HAL_GPIO_WritePin(STEP_A1_GPIO_Port, STEP_A1_Pin, GPIO_PIN_SET);
			HAL_GPIO_WritePin(STEP_A2_GPIO_Port, STEP_A2_Pin, GPIO_PIN_RESET);
			HAL_GPIO_WritePin(STEP_A3_GPIO_Port, STEP_A3_Pin, GPIO_PIN_RESET);
			HAL_GPIO_WritePin(STEP_A4_GPIO_Port, STEP_A4_Pin, GPIO_PIN_SET);
		}

		step_a++;
		if(step_a >= 4) step_a = 0;
	}



}

void setupActuators(void) {

	// -- A --

	Pin p1 = { STEP_A1_GPIO_Port, STEP_A1_Pin, 0 };
	Pin p2 = { STEP_A2_GPIO_Port, STEP_A2_Pin, 0 };
	Pin p3 = { STEP_A3_GPIO_Port, STEP_A3_Pin, 0 };
	Pin p4 = { STEP_A4_GPIO_Port, STEP_A4_Pin, 0 };
	Pin p_slp = { SLP_A_GPIO_Port, SLP_A_Pin, 0 };
	Pin e1 = { END_A1_GPIO_Port, END_A1_Pin, 0 };
	Pin e2 = { END_A2_GPIO_Port, END_A2_Pin, 0 };

	yaw.pin1 = &p1; // TODO: is this how it goes?
	yaw.pin2 = &p2;
	yaw.pin3 = &p3;
	yaw.pin4 = &p4;
	yaw.slp = &p_slp;
	yaw.end1 = &e1;
	yaw.end2 = &e2;

	yaw.htim = &htim2; // TODO: is this how it goes?

	yaw.step_count = 0;

	// enable the stepper motor driver A by driving pin high
	HAL_GPIO_WritePin(p_slp.port, p_slp.pin, GPIO_PIN_SET);

	// ------

}

void pinGo(Pin *p) {
	if(p->state == true) {
		HAL_GPIO_WritePin(p->port, p->pin, GPIO_PIN_SET);
	} else {
		HAL_GPIO_WritePin(p->port, p->pin, GPIO_PIN_RESET);
	}
}

/* USER CODE END 0 */

/**
  * @brief  The application entry point.
  * @retval int
  */
int main(void)
{
  /* MCU Configuration--------------------------------------------------------*/

  /* Reset of all peripherals, Initializes the Flash interface and the Systick. */
  HAL_Init();

  /* Configure the system clock */
  SystemClock_Config();

  /* Initialize all configured peripherals */
  MX_GPIO_Init();
  MX_I2C1_Init();
  MX_SPI1_Init();
  MX_USB_PCD_Init();
  MX_UART4_Init();
  MX_TIM2_Init();
  /* Infinite loop */
  /* USER CODE BEGIN WHILE */
  HAL_TIM_Base_Start_IT(&htim2);
  ConsoleInit();
  input_buf_reset(&uart_buf);
  HAL_UART_Receive_IT(&huart4, uart_byte_buf, 1);

  //setupActuators();

  // enable the stepper motor driver A by driving pin high
  HAL_GPIO_WritePin(SLP_A_GPIO_Port, SLP_A_Pin, GPIO_PIN_SET);

  while (1)
  {




  	/*
  	if(step_a == 0) {
			HAL_GPIO_WritePin(STEP_A1_GPIO_Port, STEP_A1_Pin, GPIO_PIN_SET);
			HAL_GPIO_WritePin(STEP_A2_GPIO_Port, STEP_A2_Pin, GPIO_PIN_SET);
			HAL_GPIO_WritePin(STEP_A3_GPIO_Port, STEP_A3_Pin, GPIO_PIN_RESET);
			HAL_GPIO_WritePin(STEP_A4_GPIO_Port, STEP_A4_Pin, GPIO_PIN_RESET);
		} else if(step_a == 1) {
			HAL_GPIO_WritePin(STEP_A1_GPIO_Port, STEP_A1_Pin, GPIO_PIN_RESET);
			HAL_GPIO_WritePin(STEP_A2_GPIO_Port, STEP_A2_Pin, GPIO_PIN_SET);
			HAL_GPIO_WritePin(STEP_A3_GPIO_Port, STEP_A3_Pin, GPIO_PIN_SET);
			HAL_GPIO_WritePin(STEP_A4_GPIO_Port, STEP_A4_Pin, GPIO_PIN_RESET);
		} else if(step_a == 2) {
			HAL_GPIO_WritePin(STEP_A1_GPIO_Port, STEP_A1_Pin, GPIO_PIN_RESET);
			HAL_GPIO_WritePin(STEP_A2_GPIO_Port, STEP_A2_Pin, GPIO_PIN_RESET);
			HAL_GPIO_WritePin(STEP_A3_GPIO_Port, STEP_A3_Pin, GPIO_PIN_SET);
			HAL_GPIO_WritePin(STEP_A4_GPIO_Port, STEP_A4_Pin, GPIO_PIN_SET);
		} else if(step_a == 3) {
			HAL_GPIO_WritePin(STEP_A1_GPIO_Port, STEP_A1_Pin, GPIO_PIN_SET);
			HAL_GPIO_WritePin(STEP_A2_GPIO_Port, STEP_A2_Pin, GPIO_PIN_RESET);
			HAL_GPIO_WritePin(STEP_A3_GPIO_Port, STEP_A3_Pin, GPIO_PIN_RESET);
			HAL_GPIO_WritePin(STEP_A4_GPIO_Port, STEP_A4_Pin, GPIO_PIN_SET);
		}

		step_a++;
		if(step_a >= 4) step_a = 0;
  	HAL_Delay(10);
		*/



  	// new
  	if(input_buf_ready(&uart_buf)) {
  		ConsoleProcess();
			input_buf_reset(&uart_buf);
		}

  	/*
  	if(input_buf_ready(&uart_buf)) {
  		uint8_t my_str[] = "received: ";
  		HAL_UART_Transmit(&huart4, my_str, sizeof(my_str), HAL_MAX_DELAY);
  		HAL_UART_Transmit(&huart4, uart_buf.buf, uart_buf.curr_index, HAL_MAX_DELAY);
  		uint8_t my_str2[] = "\r\n";
  		HAL_UART_Transmit(&huart4, my_str2, sizeof(my_str2), HAL_MAX_DELAY);
  		//printf("received: %s", uart_buf.buf);
  		input_buf_reset(&uart_buf);
  	}
  	*/

  	if(blink_leds) {
			HAL_GPIO_WritePin(GPIOE, CS_I2C_SPI_Pin|LD4_Pin|LD3_Pin|LD5_Pin
																|LD7_Pin|LD9_Pin|LD10_Pin|LD8_Pin
																|LD6_Pin, GPIO_PIN_RESET);
			HAL_Delay(100);
			HAL_GPIO_WritePin(GPIOE, CS_I2C_SPI_Pin|LD4_Pin|LD3_Pin|LD5_Pin
																		|LD7_Pin|LD9_Pin|LD10_Pin|LD8_Pin
																		|LD6_Pin, GPIO_PIN_SET);
			HAL_Delay(100);
  	} else {
  		HAL_GPIO_WritePin(GPIOE, CS_I2C_SPI_Pin|LD4_Pin|LD3_Pin|LD5_Pin
  																		|LD7_Pin|LD9_Pin|LD10_Pin|LD8_Pin
  																		|LD6_Pin, GPIO_PIN_RESET);
  	}


    /* USER CODE END WHILE */

    /* USER CODE BEGIN 3 */
  }
  /* USER CODE END 3 */
}

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
