RobotGrrl/KitePropulsion/KiteControl/Core/Inc/consoleCommands.h

// code from https://github.com/eleciawhite/reusable/tree/master/source
// license: public domain (https://github.com/eleciawhite/reusable/blob/master/LICENSE)
// april 27, 2022

// The console command interface is generally used only by console.c, 
// if you want to add a command, go to consoleCommands.c

#ifndef CONSOLE_COMMANDS_H
#define CONSOLE_COMMANDS_H

#include <stdint.h>
#include "console.h"
#include <stdbool.h> // new

#define CONSOLE_COMMAND_MAX_COMMAND_LENGTH 10		// command only
#define CONSOLE_COMMAND_MAX_LENGTH 256				// whole command with argument
#define CONSOLE_COMMAND_MAX_HELP_LENGTH 64			// if this is zero, there will be no  help (XXXOPT: RAM reduction)

#if CONSOLE_COMMAND_MAX_HELP_LENGTH > 0
	#define HELP(x)  (x)
#else
	#define HELP(x)	  0
#endif // CONSOLE_COMMAND_MAX_HELP_LENGTH

typedef eCommandResult_T(*ConsoleCommand_T)(const char buffer[]);

typedef struct sConsoleCommandStruct
{
    const char* name;
    ConsoleCommand_T execute;
#if CONSOLE_COMMAND_MAX_HELP_LENGTH > 0
	char help[CONSOLE_COMMAND_MAX_HELP_LENGTH];
#else
	uint8_t junk;
#endif // CONSOLE_COMMAND_MAX_HELP_LENGTH 
} sConsoleCommandTable_T;

#define CONSOLE_COMMAND_TABLE_END {NULL, NULL, HELP("")}

const sConsoleCommandTable_T* ConsoleCommandsGetTable(void);

extern bool blink_leds; // new // does this work?

#endif // CONSOLE_COMMANDS_H
