RobotGrrl/KitePropulsion/Firmware/AHippo-PD_LEDTest/Board.h

#define LED_S03C_PIN        2
#define LED_S01_PIN         5
#define LED_S03_PIN         6
#define LED_S04_PIN         7
#define LED_S05_PIN         8
#define LED_S06_PIN         9
#define LED_S03D_PIN       10
#define BUZZER_PIN         11
#define FREE1_PIN          12
#define BUTTON1_PIN        24
#define BUTTON2_PIN        25
#define BUTTON3_PIN        26
#define FREE2_PIN          27
#define FREE3_PIN          28
#define LED_S03A_PIN       29
#define LED_S03B_PIN       30
#define T5V_SIG_PIN       A12
#define IN_SIG_PIN        A13
#define S03_SIG4_PIN      A14
#define S03_SIG3_PIN      A15
#define S03_SIG2_PIN      A16
#define S03_SIGSMPS_PIN   A17
#define S03_SIG1_PIN      A20
#define S06_SIG1_PIN      A21
#define S06_SIGSMPS_PIN   A22
#define LED_PIN            13
#define S04_SIG1_PIN       A0
#define S04_SIG2_PIN       A1
#define S04_SIG3_PIN       A2
#define S04_SIGSMPS_PIN    A3
#define S05_SIGNP_PIN      A6
#define S05_SIG2_PIN       A7
#define S05_SIG1_PIN       A8
#define S05_SIGSMPS_PIN    A9
