RobotGrrl/KitePropulsion/Simulation/CO2JetAnimation/Particle.pde

// A simple Particle class

class Particle {
  PVector position;
  PVector velocity;
  PVector acceleration;
  float lifespan;
  int fillc;

  Particle(PVector l) {
    acceleration = new PVector(0, -0.05);
    velocity = new PVector(random(-0.5, 0.5), random(-2, 0));
    position = l.copy();
    fillc = #FFFFFF;
    lifespan = 255.0;
  }

  void run() {
    update();
    display();
  }

  // Method to update position
  void update() {
    velocity.add(acceleration);
    position.add(velocity);
    lifespan -= 1.0;
  }

  // Method to display
  void display() {
    //stroke(255, lifespan);
    //fill(255, lifespan);
    //stroke(#8f4825, lifespan);
    //fill(#8f4825, lifespan);
    stroke(fillc, lifespan);
    fill(fillc, lifespan);
    ellipse(position.x, position.y, 8, 8);
  }

  // Is the particle still useful?
  boolean isDead() {
    if (lifespan < 0.0) {
      return true;
    } else {
      return false;
    }
  }
}
