RobotGrrl/KitePropulsion/(commit log)

2022-04-09 Fixed ports selector, fixed kite track percent, specified recording fps
    [GUI.pde, KiteView.pde, Recording.pde]
2022-04-10 Added trace functionality, added actuator gui elements, fixed controlP5 rendering to video recording
    [GUI.pde, KiteView.pde]
2022-04-11 Simulate promulgate test, fixed buttons activating on start from controlP5, added actuator gui elements, refactored arduino to microcontroller
    [GUI.pde, KiteView.pde, Microcontroller.pde, Promulgate.pde]
2022-04-15 Added logger to track x,y
2022-04-16 Filter trace with distance threshold and time
2022-04-18 Implemented input buffer on uart receive
2022-04-20 Improved logging with more parameters, hue track and kite trace enabled by default
2022-04-26 Generator design from yesterday
    [Generator.f3d, Generator.stl]
2022-04-26 Generator design prototype
    [Generator.f3d, Generator.stl]
2022-05-01 Updated design with guards and kite bearing tolerances
    [Generator.f3d, Generator.step, Generator.stl]
2022-05-01 Oscilloscope data from dc motor on generator
    [MokuOscilloscopeData_20220501_024608_HighRes.csv, MokuOscilloscopeData_20220501_024608_Measurements.csv, MokuOscilloscopeData_20220501_024608_Traces.csv]
2022-05-01 Added motor mount
    [Generator.f3d, Generator.step, Generator.stl]
2022-05-03 Selected pins on board
    [Pins.xlsx]
2022-05-04 Setup pins and timer interrupt for stepper A
2022-05-08 Landscape filter started
2022-05-09 Started draft of actuator driver
2022-05-09 Change pin to adapter pattern
2022-05-10 Setting pins on actuator instance, adjusting timer callback, added slp and endstop pins
2022-05-10 Updated pins to v1.1 to include SLP for each stepper. Improved labeling
    [Pins.xlsx]
2022-05-10 Attempts at implementing angled landscape filter - unsuccessful
    [4-14-2022_22-44-14.csv]
2022-05-11 Fixed timer configuration, tested stepper motor with HAL
    [KiteControlF3.ioc, actuator.h, main.c]
2022-05-12 Designed roll experiment model
    [Roll Experiment.f3z]
2022-05-13 Still trying to fix landscape...
    [GUI.pde, KiteView.pde, Landscape.pde, Vision.pde]
2022-06-01 Servo control test code
2022-06-02 Added time of flight sensor project code - non-working
2022-06-03 Receiving values from sensor
2022-06-21 Designed pan mechanism
    [Pan Mechanism.f3z, Pan Mechanism.step, Pan Mechanism.stl]
2022-06-22 Designed tilt mechanism
    [Tilt Mechanism.f3z, Tilt Mechanism.step, Tilt Mechanism.stl]
2022-06-23 Simulated basic model of wheel and kite
2022-07-06 Input stage with components placed, pre-routing
    [01_InputStage_v1.brd, 01_InputStage_v1.sch]
2022-07-07 Designed improved motor hub with 2 set screws for 4 mm axel
    [Motor hub 3DP.f3z, Motor hub 3DP.stl]
2022-07-08 Routed all 4 of the linear voltage regulators
    [03_MotorStage_v1.brd, 03_MotorStage_v1.sch]
2022-07-09 Completed routing of components on motor stage power supply board
    [03_MotorStage_v1.brd, 03_MotorStage_v1.sch]
2022-07-10 Motor stage circuit board v1 final
    [03_MotorStage_v1.brd, 03_MotorStage_v1.sch, 03_MotorStage_v1.step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]
2022-07-11 Electronics library update
    [01_InputStage_v1.brd, 01_InputStage_v1.sch]
2022-07-11 Final electronics of input stage v1 board design
    [01_InputStage_v1.brd, 01_InputStage_v1.sch, 01_InputStage_v1.step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]
2022-07-12 Motor hub design improvements for build platform removal and surface area cooling on top layers
    [Motor hub 3DP.f3z, Motor hub 3DP.stl]
2022-07-13 Designed cover circuit board
    [00_CoverStage_v1.brd, 00_CoverStage_v1.sch, 00_CoverStage_v1.step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]
2022-07-14 Added handle to cover stage circuit board
    [00_CoverStage_Alt_v1.brd, 00_CoverStage_Alt_v1.sch, 00_CoverStage_v1.brd, 00_CoverStage_v1.step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]
2022-07-14 Designed SBC stage circuit board
    [06_SBCStage_v1.brd, 06_SBCStage_v1.sch, 06_SBCStage_v1.step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]
2022-07-15 Electronics servo stage work in progress
    [05_ServoStage_v1.brd, 05_ServoStage_v1.sch]
2022-07-16 Input stage: Added PTC and moved some traces around
    [01_InputStage_v1.brd, 01_InputStage_v1.sch]
2022-07-16 SBC stage: Moved test point to after the PTC fuse
    [06_SBCStage_v1.brd, 06_SBCStage_v1.sch]
2022-07-16 Servo stage: Completed routing
    [05_ServoStage_v1.brd, 05_ServoStage_v1.sch]
2022-07-17 Started controller stage electronics
    [04_ControllerStage_v1.brd, 04_ControllerStage_v1.sch]
2022-07-18 Components and values determined on schematic and routing started on controller stage
    [04_ControllerStage_v1.brd, 04_ControllerStage_v1.sch]
2022-07-19 Naming update to Hippo-PD
    [03_MotorStage_v1.brd, 03_MotorStage_v1.sch, 05_ServoStage_v1.brd, 05_ServoStage_v1.sch, 06_SBCStage_v1.brd, 06_SBCStage_v1.sch]
2022-07-19 Change fuse holder to through-hole component
    [01_InputStage_v1.brd, 01_InputStage_v1.sch]
2022-07-19 Finish routing controller stage electronics
    [04_ControllerStage_v1.brd, 04_ControllerStage_v1.sch]
2022-07-19 Cover stage artwork naming update
    [00_CoverStage_v1.brd, 00_CoverStage_v1.sch]
2022-07-20 Move LEDs to side on input stage
    [01_InputStage_v1.brd]
2022-07-20 Started monitor stage electronics
    [02_MonitorStage_v1.brd, 02_MonitorStage_v1.sch]
2022-07-21 Progress on monitor electronics schematic
    [02_MonitorStage_v1.brd, 02_MonitorStage_v1.sch]
2022-07-22 Routed monitor stage board
    [02_MonitorStage_v1.brd, 02_MonitorStage_v1.sch]
2022-07-22 Routing improvements on monitor stage electronics
    [02_MonitorStage_v1.brd, 02_MonitorStage_v1.sch]
2022-07-22 Board outlines and library update
    [cover_outline.dxf, stage_outline.dxf]
2022-07-22 Designed helper boards
    [Sled_5A_v1.brd, Sled_5A_v1.sch, Sled_5A_v1.step, Sled_8A_v1.brd, Sled_8A_v1.sch, Sled_8A_v1.step, Sled_Terminals_v1.brd, Sled_Terminals_v1.sch]
2022-07-22 Cover stage electronics v1 final
    [00_CoverStage_Alt_v1.brd, 00_CoverStage_Alt_v1.sch, 00_CoverStage_v1.brd, 00_CoverStage_v1.step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]
2022-07-22 Input stage electronics v1 final
    [01_InputStage_v1.brd, 01_InputStage_v1.step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]
2022-07-22 Monitor stage electronics v1 final
    [02_MonitorStage_v1.brd, 02_MonitorStage_v1.sch, 02_MonitorStage_v1.step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]
2022-07-22 Motor stage electronics v1 final
    [03_MotorStage_v1.brd, 03_MotorStage_v1.step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]
2022-07-22 Controller stage electronics v1 final
    [04_ControllerStage_v1.brd, 04_ControllerStage_v1.step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]
2022-07-22 Servo stage electronics v1 final
    [05_ServoStage_v1.brd, 05_ServoStage_v1.step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]
2022-07-22 SBC stage electronics v1 final
    [06_SBCStage_v1.brd, 06_SBCStage_v1.sch, 06_SBCStage_v1.step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]
2022-07-24 Designed 3D printed pieces for Hippo-PD boards
    [Hippo-PD_Assembly.step, clip_A.stl, clip_B.stl, tray.stl]
2022-07-25 Revised Hippo-PD design based on fasteners
    [Hippo-PD_Assembly.step, clip_A.stl, clip_B.stl, tray.stl]
2022-07-27 Calculation of efficiencies (power and thermal) for hippo-pd stage 01
2022-07-28 Efficiencies calculations for all stages in Hippo-PD
2022-07-31 Designed test jig for 3D printing to hold hippo-pd stages in place
    [Hippo-PD Test Jig.f3z, Hippo-PD Test Jig.step, lower_test_jig.stl, upper_bottom_test_jig.stl, upper_top_test_jig.stl]
2022-08-03 Updated refdes of some components
    [02_MonitorStage_v1.brd, 02_MonitorStage_v1.sch, 03_MotorStage_v1.brd, 03_MotorStage_v1.sch]
2022-08-04 Created button debounce test
2022-08-05 Added led test for hippo-pd
2022-08-08 Motor stage test points
2022-08-08 Physics model for Helium kite on Mars
    [Helium Kite.xlsx]
2022-08-11 Modifications to 3D print pieces for Hippo-PD assembly design based on the 20 mm brass hex standoffs used
2022-08-12 Improvements to 3D prints design for Hippo-PD (again)
2022-09-07 Designed line spool CAD model
    [Line Spool.f3z, Line Spool.stl]
