RobotGrrl/KitePropulsion/(notices)

Notices in the files:
Firmware/KiteToF_F3/Core/Src/main.c:
Copyright (c) 2022 STMicroelectronics.
All rights reserved.
This software is licensed under terms that can be found in the LICENSE file
parts and their libraries:
SparkFun-PowerSymbols: Licensing: Creative Commons ShareAlike 4.0 International - https://creativecommons.org/licenses/by-sa/4.0
COPYRIGHT: Copyright (C) 2022 Ultra Librarian. All rights reserved.
